anweat/idea-05b-smart-medicine-box/01_设计文档/07_取药几何优化.md

# IDEA-05B 取药几何优化（7 格演进版）

> 针对已确认的 **7 格演进方向**，专门解决「药片倒不出来 / 手指抠不到 / 手抖撒药 / 清洗难」。
> 结论：不做复杂机构，用 **一只可取出药杯** 同时支持「斜向指取」和「提杯倾倒」两种取法。
> 状态：待确认后进入 Blender 建模。

---

## 0. 结论先说

| 项 | 方案 |
|---|---|
| 格型 | 浅口 **15 mm**（现状约 25 mm），前部浅槽 **4.8°**、整底微倾 **3.4°**，内壁 R3、底壁 R2 |
| 取药口 | 前唇高 **5 mm**，中央 **24 mm** 宽倒药口，R2 圆唇 |
| 药杯 | **可取出**：41.9 × 54 × 15 mm，食品级 PP，带提手，可水洗、可预装、可带走 |
| 指取 | 指腹从上方 **35–45°** 斜插，落点距唇口仅 **5 mm**，不需要捏取、不需要下探到格底 |
| 倒取 | 提杯 → 倾斜 **40–50°** → 从 24 mm 倒药口倒入手心，适合手抖/关节炎 |
| 底座配合 | 杯底 **10 × 24 mm** 透光窗，与 LED 引导灯、红外对射对位 |
| 代价 | **+7 只 PP 杯**，BOM +¥2–3；模具多一套杯体（7 腔一模） |
| 不做 | 弹起平台、翻斗、电机转盘——机构复杂、密封差、成本高，首版不做 |

取药几何
取药方案对比

---

## 1. 为什么「抠药」是个几何问题

现状 7 格：单格约 44 × 55 × 25 mm，垂直壁、平底、无倒药口。

| 几何事实 | 老人实际动作 | 后果 |
|---|---|---|
| 格深 25 mm | 食指要整根下探到格底 | 指关节弯曲受限、指甲长的用户更困难 |
| 垂直壁 + 平底 | 药片贴在格底，只能「捏」或「抠」 | 捏力 3–5 kg 且关节炎再降 30–40%，失败率高 |
| 格口 44 × 55 | 手要伸进格子，视线被盖沿挡住 | 看不清、容易把药拨到别的格 |
| 平底无聚集 | 药片散在四周 | 要多次拨动，手抖会撒 |
| 一体内胆不可拆 | 只能擦，不能洗 | 药粉残留、串味、受潮 |

**核心判断**：老人不是「不愿意取」，而是**取药动作要求的手指能力超过了他们的手**。几何优化的目标不是把格子做大，而是**把「捏/抠」改成「斜插/倾倒」**。

---

## 2. 四种几何方案对比

| 方案 | 做法 | 步骤 | 耗时 | 指力/捏力 | 清洁 | 成本 | 密封风险 | 结论 |
|---|---|---|---|---|---|---|---|---|
| A 现状 | 深格 + 垂直壁 | 3 | 5–10 s | 高（下探+捏） | 差 | 0 | 低 | 不解决根本问题 |
| B 斜底 + 前唇（一体模） | 15 mm 浅格、3.4° + 前槽 4.8° 斜底、5 mm 前唇 | 3 | 3–5 s | 中低（斜插） | 差（不可拆） | 低 | 低 | 可作为**低配** |
| **C 可取出杯 + 倒药口（推荐）** | B + 独立 PP 杯 + 提手 + 24 mm 倒药口 | 3–5 | 3–6 s | **低**（斜插或倾倒） | **好（可水洗）** | +¥2–3 | 中（杯口密封） | **主推** |
| D 可翻出硅胶软胆 | 软硅胶内胆，按压翻出 | 2 | 2–4 s | **最低** | 中（易吸味） | +¥4–6 | 中 | 作为**配件**，重度关节炎选配 |

**推荐 B + C 组合**：同一个杯体，两种取法。
- 日常：开盖 → 斜插指取 → 合盖（3 步，3–5 s）。
- 手抖/关节炎：开盖 → 提杯 → 倾斜倒出 → 放回 → 合盖（3–5 步，但每步都简单）。
- D 软胆作为选配件，不进入首版模具。

---

## 3. 推荐几何（给建模的硬参数）

### 3.1 药杯

| 参数 | 数值 | 说明 |
|---|---|---|
| 外形 | **41.9 × 54 × 15 mm** | 与 7 格托盘 1:1；单杯有效容积约 20 ml |
| 壁厚 | 1.6 mm | 食品级 PP，注塑 |
| 内腔 | 38.7 × 50.8 mm，内深 10–11 mm | 内壁 R3 |
| 底形 | **3.4° 微倾 + 前 12 mm 浅槽 4.8°** | 前部内深 11 mm、后部内深 10 mm；胶囊平放不顶盖 |
| 前唇 | 高 **5 mm**（相对杯底最低点） | 静置挡药；倾倒时越过 |
| 倒药口 | 宽 **24 mm**、深 5 mm、R2 圆唇 | 20 mm 胶囊可整粒倒出 |
| 提手 | 前缘上方 20 × 8 mm，外伸 3 mm | 拇指+食指可勾；提杯力 <2 N |
| 透光窗 | 杯底 **10 × 24 mm**，厚 0.8 mm | 与 LED/红外对位；≥70 % @850 nm |
| 圆角 | 内壁 R3、底壁 R2、口沿 R1.5 | 无锐边、不夹药、不藏粉 |
| 间隙 | 杯与托盘单边 0.2 mm | 不夹手、可取出 |
| 防呆 | 2 条导向筋 + 前后不对称 | 反装插不进 |

### 3.2 取药动作与尺寸链

```
杯口 z=41.5
前唇 z=35.5  ← 距杯底 5 mm，距杯口 6 mm
前部浅槽 z=30.5  ← 距唇口 5 mm，距杯口 11 mm
后部杯底 z=31.5  ← 距杯口 10 mm（胶囊平放不顶盖）
```

- 指腹落点：距前唇仅 **5 mm**，食指以 35–45° 斜插即可触药；不需要整根手指下探。
- 视线：杯口完全敞开（日盖开 100°），无遮挡。
- 倒药：提杯后倾斜 40–50°，5 mm 唇口成为倒药堰，24 mm 口宽保证胶囊/大钙片通过。
- 单杯约 20 ml：一天 3–6 粒胶囊只占 10–20 %，空间不局促；药片不会「卡」在角落。

### 3.3 托盘与底座配合

- 托盘 7 腔，单腔 42.3 × 54.4 × 15.4 mm；杯口低于托盘口 0.4 mm，日盖压合时密封在**托盘口**（不是杯口），避免杯体公差影响密封。
- 杯底透光窗与底座 PCB 上的 LED/红外对射一一对位；杯取出后，底座仍可检测「杯缺失」。
- 称重：托盘整体坐在称重平台上；取杯/放杯的重量变化由固件识别为「杯取出/放回」，不误判为「已取药」。

---

## 4. 为什么不是其他几何

| 备选 | 为什么不选 |
|---|---|
| 加深/加大格 | 手指能力不变，只是让药更难够到 |
| 纯倒药口、不可拆杯 | 倒药口在托盘上要穿破前脸，密封与外观都麻烦 |
| 抽屉/翻斗 | 滑轨占空间、药片易卡、密封差、成本高 |
| 弹起平台 | 7 套弹簧+导向，公差累积、清洁死角、成本高 |
| 转盘自动出药 | 电机、卡药、清洁、体积、成本都上一个量级；首版不做 |
| 只做硅胶软胆 | 软胆吸味/难彻底干燥，且需要杯体支撑；作为配件更合适 |

---

## 5. 对建模的影响（直接进 Blender）

1. 7 只独立药杯，不是 7 个一体化格；杯体单独建模、阵列 7 个。
2. 杯体必须做出：3.4° + 前槽 4.8° 斜底、5 mm 前唇、24 mm 倒药口、20×8 提手、10×24 透光窗、R3/R2 圆角。
3. 托盘 7 腔带 0.4 mm 台阶与防呆筋；日盖密封面在托盘口。
4. 英雄图：打开「周三」日盖，杯内 5 粒胶囊，杯底 LED 微亮；同时展示提手与倒药口。
5. 爆炸图：日盖 → 药杯（7 只）→ 托盘 → 称重/传感器板 → 主板/电池 → 底壳。
6. 细节图：杯口 5 mm 唇口与 24 mm 倒药口的特写；指取姿态用透视/剖面辅助图说明。

---

## 6. 待验证（打样前）

1. **5 mm 唇口**：静置 7 天不洒；倾斜 40–50° 时胶囊/大钙片可靠倒出；不同形状药片（圆片、椭圆片、胶囊、软胶囊）各 10 次。
2. **斜底 3.4° + 前槽 4.8°**：是否需要微振动/更陡角度才能让药片聚集；若药片仍停在后面，改 10° 或加前部浅槽。
3. **指取**：15 名老人（含关节炎/低视力）开盖→取药→合盖的成功率、时间、是否需要双手。
4. **透光窗**：PP 透光率 @850 nm ≥70 %；药片颜色（深色/半透明）对红外判定的影响。
5. **杯口密封**：杯在托盘内、日盖压合后的 IP54 与 7 天湿度保持。
6. **清洗**：杯体可洗碗机（≤70 °C）；提手/倒药口无清洁死角。

---

## 7. 与整体设计的关系

- 本次只改「取药几何」，不改已确认的：**7 格、段码屏 + 3 键、暖白 + 烟灰盖、主机+药芯+爆炸图+渲染**。
- 称重、环境、语音、双端 App 的规格沿用前版方案（见 `IDEA-05_设计优化方案_v1.md` 的对应章节，按 7 格口径调整：7 个杯、7 个霍尔、7 组红外/灯）。
- 下一步：按本文件的杯体参数建模；如果确认采用「一体模（B）」或「加硅胶软胆（D）」，只改杯体与爆炸图，不影响主机。

---

> 依据：`notes/research_ergonomics.md`（捏力、开盖力、单格尺寸、步骤上限）、`notes/research_competitors.md`（格子太小/太深、倒不出来、开盖判定）、`notes/research_components.md`（PP/PC、硅胶、透光、IP54、BOM）。
