anweat/idea-05b-smart-medicine-box/01_设计文档/08_IDEA-05B_7格定稿.md

# IDEA-05B 智能药盒 · 7 格演进版 · 设计定稿

> 确认日期：2026-10-18
> 已确认：**7 格演进** · **段码屏 + 3 键** · **暖白 + 烟灰透明盖** · **主机 + 药芯 + 爆炸图 + 渲染** · **可取出药杯 + 前唇倒药口（B+C）**
> 交付：`model/IDEA-05_box.blend`、`model/IDEA-05_box.glb`、`model/IDEA-05_box_closed.glb`、`renders/`、`design/09_IDEA-05B_design_board.png`、本文件、`07_取药几何优化.md`

---

## 1. 一句话

保留 IDEA-04 的 320 × 70 × 52 mm 外形与 7 天分格，把「深格抠药」改成 **7 只可取出药杯（浅口 + 前唇倒药口 + 底部透光窗）**，并补齐 **只称药芯的称重台、SHT40 温湿度/光照、离线语音、段码屏 + 3 键、双端 App**。

## 2. 总体尺寸与分层

| 项 | 数值 |
|---|---|
| 外形 | 320 × 70 × 52 mm，圆角 R8，暖白 ABS + 烟灰 PC |
| 底壳 | 0–24 mm：电池、主控、传感器板、称重台、UI |
| 药芯托盘 | 24–42 mm：7 腔、2 mm 底、可整体抽出 |
| 日盖 | 42–52 mm：7 个独立烟灰 PC 盖，按压弹开 |
| 空机重量 | 目标 ≤ 380 g |
| 电池 | 3.7 V 3000 mAh（805060，约 60 g） |

## 3. 七格与药杯（最终几何）

- 7 个日格（周一…周日），每格一只 **可取出药杯**：
  - 外 **41.9 × 54 × 15 mm**，壁厚 1.6 mm，食品级 PP；
  - 内腔 **38.7 × 50.8 mm**，前部内深 11 mm、后部内深 10 mm；
  - 底形：整底微倾 3.4° + 前 12 mm 浅槽 4.8°；
  - **前唇高 5 mm**、中央 **24 mm 倒药口**（R2 圆唇），距杯口 6 mm；
  - 杯底 **10 × 24 mm 透光窗**（与 LED/红外对位）；
  - 内壁 R3、底壁 R2；杯与托盘单边 0.2 mm 间隙；2 条防呆筋；
  - 提杯：指腹勾住前唇/杯口，或双手捏杯口；可水洗、可预装、可带走。
- 托盘：310 × 62 × 18 mm，7 腔 42.3 × 54.4 mm；日盖密封在**托盘口**，避免杯体公差影响密封。
- 日盖：43.4 × 62 × 9.5 mm，烟灰 PC 空心壳，前缘提手 26 × 8 mm；push-push 弹开 + 阻尼下放 + 磁吸辅助合盖；7 个霍尔判盖。
- 取药动作：
  - 指取 3 步：开盖 → 斜插指取 → 合盖（3–5 s）；
  - 倒取 2 步：提杯 → 倾斜 40–50° 倒出（手抖/关节炎）。
- 详细几何与验证项见 `07_取药几何优化.md`。

## 4. 称重（只称药芯）

| 项 | 方案 |
|---|---|
| 传感器 | 1 只 500 g–1 kg 单点式，承托「托盘 + 7 杯」；HX711/CS1237，24 bit |
| 精度目标 | 0.2–0.5 g（500 g 量程），需温度补偿与空载去皮 |
| 每格有无 | 7 组红外对射（38 kHz 调制），杯底透光窗对位 |
| 开合 | 7 个霍尔 + 盖内磁铁 |
| 装药标定 | App 引导逐格装药，记录每格增重 Δm 作为基线；总重复核，错格/漏装提示 |
| 取药校验 | 开盖 + 减重 ≈ 基线 → 已取出；无减重 → 未取；未开盖 → 未动 |
| 状态口径 | **已确认 / 已取出未确认 / 未动** 三态；不显示「已服药」 |
| 能力边界 | 单片 0.1–0.5 g，不能逐粒计数；整剂校验可靠 |

## 5. 环境感应

- **SHT40**（±0.2 °C / ±1.8 %RH）置于药仓侧壁，ePTFE 透气膜后，远离电池/充电 IC ≥15 mm。
- **VEML7700** 光照：开盖见光累计；避光药提醒。
- **密封**：托盘口硅胶圈 + 日盖 TPU 密封唇，目标 **IP54**；7 盖累计公差是最大风险。
- **干燥剂**：可抽换硅胶盒，按湿度上升速率提醒更换；120–140 °C 可再生。
- **阈值动作**：>25 °C 预警、>30 °C 告警；>65 %RH 预警、>75 %RH 更换干燥剂；见光超阈提醒合盖/避光内胆。
- **避光边界**：透明/烟灰 PC 不满足「遮光」；可选乳白避光内胆；如做琥珀窗需实测 290–450 nm 透射。
- **负面清单**：胰岛素/GLP-1、生物制品、硝酸甘油、泡腾片、中药颗粒、栓剂、需冷藏滴眼液、麻精药、儿童药。

## 6. 语音与交互

- 离线优先：RTC + Flash，断网可定时、语音、记录 30 天。
- **MEMS 麦克风** + SU-03T 离线唤醒（按键/开盖/加速度计一级唤醒，语音模组负载开关供电 3–5 s）。
- **8 Ω 2 W 扬声器**：75 dB、500–1000 Hz、语速 100–150 字/分；家人录音「亲情语音」。
- **3 键**：⌀22 主键「已服药」、⌀12「稍后」、⌀12「呼叫」；0.8–2 N，行程 ≥1.5 mm，声/光/触反馈。
- **58 × 18 段码屏**：时间 + 下一剂 + 温湿度/电量；7 天进度灯；7 格内导光（当次应服格常亮）。
- 提醒升级：T0 声光 → +5 min 重复 → +15 min 家属 App → +30 min 可选电话；「稍后」10 min，次数同步家属端。

## 7. App 双端

| | 长者端 | 家属端 |
|---|---|---|
| 账号 | 无 | 有 |
| 入口 | 物理键 + 语音（可选大字 App） | App / 小程序 |
| 功能 | 确认、稍后、呼叫、问状态 | 排药、装药引导、依从性、环境、库存、远程提醒、亲情语音、多家属协同 |
| 连接 | 断网可用 | BLE 近场 + WiFi 云同步；4G 底座选配 |

## 8. BOM（1k 批量估算，不含模具/认证/组装）

| 物料 | 数量 | 小计 ¥ |
|---|---|---|
| ESP32-C3-MINI-1 | 1 | 12 |
| 称重传感器 500 g–1 kg + HX711 | 1+1 | 24 |
| 红外对射（每格一组） | 7 | 7 |
| 霍尔（每盖一个） | 7 | 13 |
| SHT40 + VEML7700 | 1+1 | 8 |
| SU-03T + 功放 + MEMS 麦克风 | 1 | 22 |
| 8 Ω 2 W 扬声器 + 音腔 | 1 | 5 |
| 段码屏 58 × 18 | 1 | 12 |
| 充电管理 + 电池 3000 mAh + Type-C + pogo | 1 | 33 |
| PCB + 阻容/ESD/辅料 | 1 | 18 |
| 药杯 7 只（PP）+ 托盘 + 日盖（PC） | 7+1+7 | 约 8–12 |
| 密封圈 + 干燥剂 + 铰链/弹开 + 磁铁 + 脚垫 | — | 约 12 |
| **合计** | | **≈ ¥160–180** |

建议零售 ¥299–399；家属云服务基础免费 + ¥9.9/月高级。

## 9. 已交付的模型/渲染

| 文件 | 内容 |
|---|---|
| `model/IDEA-05_box.blend` | 参数化 Blender 源文件（单位 m，1:1） |
| `model/IDEA-05_box.glb` | 2.2 MB，117 mesh / 25 material / 1 texture；含开盖状态 |
| `model/IDEA-05_box_closed.glb` | 同上，全部日盖关闭；适合 Web/AR 展示 |
| `design/09_IDEA-05B_design_board.png` | 2000 × 1250 设计图板（整体图 / 三视图 / 爆炸图 / 取药几何 / 参数） |
| `renders/hero.png` | 3/4 英雄图（周三开盖 + 药杯 + 引导光） |
| `renders/front.png` | 正视图（段码屏、三键、7 日标签） |
| `renders/top.png` | 俯视图（7 个烟灰日盖 + 周一…周日） |
| `renders/exploded.png` | 爆炸图（日盖 / 药杯 / 托盘 / 称重传感 / 主板电池 / 底壳） |
| `renders/cup_detail.png` | 药杯细节（前唇、倒药口、透光窗） |

GLB 校验：开盖版包围盒 **322 × 77.5 × 93 mm**，闭盖版 **322 × 73.2 × 57.7 mm**（含按键/脚垫凸起）；Z 轴向上。材质含 transmission，Web/AR 需支持 KHR_materials_transmission。

## 10. 与 IDEA-04 的差异

| 部位 | IDEA-04 | IDEA-05B |
|---|---|---|
| 格型 | 深格 25 mm | 浅口 15 mm + 可取出杯 |
| 取药 | 手指抠 | 斜插指取 / 提杯倾倒 |
| 称重 | 机身中部称重片 | 只承托药芯的称重台 + 7 格红外 + 7 霍尔 |
| 环境 | 无 | SHT40 + 光照 + IP54 + 干燥剂 |
| 语音 | 仅播报 | 麦克风 + 离线唤醒 + 亲情语音 |
| 交互 | 4 LED + 1 键 | 段码屏 + 3 键 + 7 天进度 + 7 格导光 |
| 摄像头 | 顶部扫码窗 | 取消（App 扫码） |
| 充电 | Type-C | Type-C + pogo 底座（选配） |

## 11. 待验证（打样前）

1. 5 mm 前唇：静置 7 天不洒；倾斜 40–50° 可倒出胶囊/大钙片。
2. 杯底透光窗 ≥70 % @850 nm；深色药片不影响红外判定。
3. 称重 0.2–0.5 g 重复性；开盖手压扰动；装药基线误差 <5 %。
4. IP54：7 个日盖 + 托盘口密封累计公差。
5. 15 人可用性（75+、关节炎、低视力）：开盖、指取、提杯倒、读标签、处理报警。
6. 合规：GB 4806、GB 31241、GB/T 9254.1、IP54、SRRC；**NMPA 分类界定**；宣传禁用「治疗/诊断」，称重只讲三态。
