anweat/idea-05b-smart-medicine-box/01_设计文档/11_特色点与创新点_讲述稿.md

# IDEA-05B 智能药盒 · 特色点与创新点（讲述稿）

> 用途：答辩 / 路演 / 评审 / 组会讲述。所有数字为设计目标或调研值，标注了“目标/估算”，不要当成实测结论。

---

## 0. 先记住三句话

1. **一句话定位**：不是把药盒做“智能”，而是把**取药**这件小事做简单——让老人不用抠、不用记、不用学 App。
2. **一句话差异**：同尺寸 7 天分格，**可取出药杯 + 前唇倒药口**，**只称药芯的称重三态**，**离线语音 + 双端**。
3. **一句话边界**：称重只证明“药离开了药仓”，不证明“吞下去了”；所以我们只说**已确认 / 已取出未确认 / 未动**三态。

---

## 1. 30 秒电梯稿

> 我们的智能药盒面向独居、行动不便、每天要吃药的长辈。调研发现，老人真正的痛点不是“缺一个 App”，而是**盖子难开、格子太深倒不出来、忘了吃没吃、受潮变质、不会用手机**。所以我们保留 7 天分格，把格子做成**可取出药杯**：浅口、前唇、24 mm 倒药口，手指斜插就能取，也可以提杯直接倒；底座只称药芯，配合 7 格红外和 7 个霍尔，做**装药逐格标定 + 取药差重校验**；再加上温湿度、光照、密封、离线语音和双端 App。白牌 30 元只分格，进口 200–800 元/月卖服务，我们做 **299–399 元买断**的智能硬件。

---

## 2. 2 分钟讲述稿（按“痛点 → 方案 → 差异 → 证据”）

**① 痛点（20 秒）**
> 我国社区老年多重用药者不依从率约 31.8%–48.8%，平均吃 6 种药；60 岁以上占非网民 46.8%。老人不是不想吃，是**开、倒、看、记**四个动作超出了手和眼睛的能力。

**② 方案（50 秒）**
> 我们做了四件事：
> 第一，**取药几何**。7 个日格，每格一只可取出药杯：15 mm 浅口、5 mm 前唇、24 mm 倒药口、杯底 10×24 透光窗。日常“开盖 → 斜插指取 → 合盖”3 步；手抖或关节炎时“提杯 → 倾斜倒出”2 步。
> 第二，**称重三态**。称重台只承托药芯，装药时逐格记录基线，取药前后做差重校验；配合 7 组红外和 7 个霍尔，输出“已确认 / 已取出未确认 / 未动”，不冒充“已服药”。
> 第三，**保存条件**。SHT40 温湿度 + 光照 + 硅胶密封 + 可换干燥剂，超温、超湿、见光都给具体动作，而不只是显示数字。
> 第四，**适老化交互**。段码屏 + 3 个物理键 + 7 格导光；离线语音 + 家人录音的“亲情语音”；长者端零账号，家属端管排药、依从性、环境、库存和远程提醒。

**③ 差异（30 秒）**
> 和 14 款竞品比，**“称重 + 温湿度/光照”这个组合没看到**；白牌只做“分格 + 闹铃”，进口卖的是月费服务。我们的差异是：同尺寸把“取”做好、把“有没有取”说清楚、把“保存条件”变成动作、把 App 从老人侧拿掉。

**④ 收尾（20 秒）**
> 目前完成 7 格方案的设计定稿、Blender 模型、爆炸图和概念图板；下一步是药杯打样、5 mm 唇口倾倒测试、称重台架和 15 人可用性测试。我们先把最难的“取”做对，再谈自动分药。

---

## 3. 6 个特色点（讲给别人听时，一条一句话 + 一个数字）

| # | 特色点 | 一句话讲法 | 支撑细节 / 数字 |
|---|---|---|---|
| 1 | **7 天独立分格 + 按压弹开** | 一天一格，7 个独立烟灰日盖，指腹一压就弹开 | 按压 <3 N；开 100°；阻尼下放防夹手；日盖可整排取下 |
| 2 | **可取出药杯 + 前唇倒药口** | 药杯能拿出来，浅口 + 前唇 + 24 mm 倒药口，斜插或倾倒都行 | 杯 41.9×54×15 mm；内深 10–11 mm；前唇 5 mm；指腹落点距唇口 5 mm；可水洗、可预装、可带走 |
| 3 | **只称药芯的称重三态** | 只称药芯，装药逐格标定，取药差重校验 | 500 g 单点 + HX711；目标 0.2–0.5 g；7 组红外 + 7 霍尔；三态输出 |
| 4 | **环境感应闭环** | 不只显示温湿度，而是告诉你“现在该做什么” | SHT40 ±0.2 °C / ±1.8 %RH；>25 °C 预警、>30 °C 告警；>65/75 %RH 提醒换干燥剂；目标 IP54 |
| 5 | **离线优先 + 亲情语音** | 断网也能提醒、能记录；家人录的声音比机器声更管用 | 本地 RTC + Flash，30 天事件；SU-03T 门控供电；8 Ω 2 W、75 dB、500–1000 Hz |
| 6 | **双端分工：长者零账号，家属管后台** | 老人不需要学 App；家属在手机上看排药、依从性、环境、库存 | 长者端 3 键 + 语音；家属端排药 / 依从性 / 环境 / 库存 / 远程提醒 / 亲情语音 |

**加分项**：段码屏 + 3 键 + 7 天进度 + 7 格导光；Type-C + 磁吸 pogo 底座（选配）；取消摄像头（隐私 + 成本）；BOM 约 ¥160–180，建议零售 ¥299–399。

---

## 4. 5 个创新点（重点：为什么算创新、为什么难被抄）

### 创新点 1：把“取药”当成几何问题，而不是 UI 问题
- **做法**：7 只可取出药杯，15 mm 浅口、5 mm 前唇、24 mm 倒药口、杯底透光窗；指取 3 步、倒取 2 步。
- **为什么算创新**：竞品大多在“提醒”和“分格数量”上卷，很少有人把**手指可达、倾倒角度、唇口高度、胶囊能否通过**做成可量化的几何指标。
- **证据**：人因数据——捏力老人约 3–5 kg、关节炎再降 30–40%；开盖/按键建议 ≤10–15 N；单次操作 ≤3 步。
- **一句话**：**把“抠药”改成“斜插 / 倾倒”，让手比 App 先解决问题。**

### 创新点 2：只称药芯，而不是称整机
- **做法**：称重台只承托“托盘 + 7 只药杯”，不承托电池、主板和外壳；装药时逐格记录增重基线，取药后做差重校验。
- **为什么算创新**：整机称重会被电池、外壳、手压和温漂吃掉精度；只称药芯把量程从“整机”降到“药芯”，分辨率更容易做；再用“逐格基线”把“总重”变成“哪一格少了多少”。
- **证据**：1 kg 单点工程精度约 0.5–1 g，500 g 量程可到 0.2–0.5 g；单片药 0.1–0.5 g，不能逐粒计数——所以我们只做**整剂校验**，不做“数粒”。
- **一句话**：**从“开盖推断”升级为“差重校验”，并且诚实地说三态。**

### 创新点 3：环境感应必须“给动作”，不是“给参数”
- **做法**：SHT40 放在药仓侧壁，远离电池/充电 IC；>25/30 °C、>65/75 %RH、见光超阈，分别给“移阴凉处 / 换干燥剂 / 合盖或换避光内胆”的动作；干燥剂按湿度上升速率提醒更换。
- **为什么算创新**：多数产品只显示温湿度，用户不知道 68 %RH 意味着什么；我们把“保存条件”翻译成“下一步做什么”。
- **边界**：透明/烟灰 PC 不满足“遮光”，避光药要选配乳白内胆；不宣称“药典遮光”。
- **一句话**：**把“保存条件”从参数装饰变成行动建议。**

### 创新点 4：适老化不是放大字体，而是把 App 从老人侧拿掉
- **做法**：设备端 3 个物理键 + 语音 + 段码屏 + 格内导光；断网可定时、可语音、可记录 30 天；长者端零账号；家属端才做排药、依从性、环境、库存和远程提醒。
- **为什么算创新**：60+ 占非网民 46.8%，让老人“先配网、再授权、再学 App”是把最难的一步留给最弱的人；我们把复杂度移到家属端。
- **一句话**：**老人端是“家电”，家属端才是“后台”。**

### 创新点 5：同尺寸 7 格的可换药芯 + 成本卡位
- **做法**：药芯（7 只杯 + 托盘 + 日盖）可整体抽出、可水洗、可预装；主机复用；BOM 约 ¥160–180，零售 ¥299–399。
- **为什么算创新**：白牌 ¥23–45 只做“分格 + 闹铃”，进口 ¥213–888/月是服务费；中间 ¥199–399 的“买断式智能硬件”是空档。可换药芯把“卫生 + 备药 + 耗材”做成产品结构。
- **一句话**：**用耗材化药芯解决卫生和备药，用主机复用把价格打下来。**

> 如果评委问“21 格是不是更创新”：我们做过同尺寸 7×3 = 21 格的概念（文档里有），但 21 格装药负担大、7 个日盖的密封累计公差更难；首版选 7 格是**风险控制**，不是没想到。多剂次可以后续用日内分隔内胆或 21 格 SKU 扩展。

---

## 5. 和竞品 / 白牌 / 进口的对比（讲这一张表就够）

| 维度 | 白牌 7 格（¥23–45） | 进口自动分药（¥213–888/月） | IDEA-05B（¥299–399 买断） |
|---|---|---|---|
| 分格 | 7 格 | 10–60 杯 / 28 格 | **7 天 × 7 只可取出杯** |
| 取药 | 手指抠 | 自动出药 / 托盘 | **斜插指取 3 步 / 提杯倾倒 2 步** |
| 是否吃了 | 无 | 开盖/出药推断 | **称重 + 红外 + 霍尔 → 三态** |
| 环境 | 无 | 基本无 | **温湿度 + 光照 + 密封 + 干燥剂** |
| 联网 | 无 | 月费服务 / 蜂窝 | **离线优先 + BLE/WiFi + 双端** |
| 老人操作 | 闹铃 | 需家属/药师装药 | **3 键 + 语音 + 格内导光** |
| 价格 | ¥23–45 | ¥213–888/月 | **¥299–399 买断** |

---

## 6. 现场演示动线（3 分钟）

1. **开盖**：按一下 周三 日盖 → 弹起 12° → 掀开 100°；说“按压 <3 N，阻尼下放，不夹手”。
2. **指取**：食指 35–45° 斜插，从 5 mm 前唇上方触到药片；说“指腹落点距唇口 5 mm，不用下探到格底”。
3. **倒取**：把药杯提出，倾斜 40–50°，从 24 mm 倒药口倒入手心；说“手抖/关节炎也能完成”。
4. **称重**：放回药杯 → 屏幕/语音提示“已取出，请确认”；说“只称药芯，不称整机；三态，不冒充已服药”。
5. **环境**：展示温湿度/光照卡片，说“超 30 °C 提醒移阴凉处；超 75 %RH 提醒换干燥剂”。
6. **双端**：长者端按“已服药” → 家属端收到记录；说“长者零账号，家属管后台；断网也能用”。

---

## 7. 可能被追问的 8 个问题（附答法）

| 问题 | 答法 |
|---|---|
| 称重能证明老人吃了吗？ | 不能。称重只证明“药离开药仓”，所以我们输出三态，不写“已服药”；结合按键/语音确认和家属端事件流。 |
| 单片 0.1 g 能称出来吗？ | 不能逐粒计数。目标 0.2–0.5 g，做整剂校验和装药基线；单片计数需要更高精度和更贵的结构，首版不做。 |
| 7 格够吗？一天 3 次怎么办？ | 7 格是“一天一格”；多剂次可由家属按顿分装，或后续加日内分隔内胆 / 21 格 SKU。首版选 7 格是降低装药负担和密封风险。 |
| 为什么不做自动分药？ | 电机、卡药、清洁、体积、成本都上一个量级；首版先把“取、称、存、提醒”做对。 |
| 7 个日盖能做到 IP54 吗？ | 日盖 TPU 密封唇 + 托盘口硅胶圈，目标 IP54；7 盖累计公差是最大风险，必须打样验证。 |
| 成本/售价怎么定？ | 1k 批量 BOM 约 ¥160–180；建议零售 ¥299–399，卡在白牌和进口月费之间。 |
| 法规上算医疗器械吗？ | 只做提醒/记录/依从性，通常按消费电子；不宣称治疗/诊断，不做按剂量分发；建议做 NMPA 分类界定。 |
| 老人不会用 App 怎么办？ | 老人端不需要 App/账号；设备本地 3 键 + 语音 + 屏幕；家属端才需要 App。 |

---

## 8. 一页 PPT / 展板提纲

1. **标题**：IDEA-05B · 把“取药”做简单
2. **痛点**：开、倒、看、记（4 个动作）+ 3 个数字（31.8–48.8% 不依从、6 种药、46.8% 非网民）
3. **方案总图**：概念图板（整体 + 三视图 + 爆炸 + 取药几何）
4. **特色 1**：可取出药杯 + 前唇倒药口（剖面图 + 3 步/2 步）
5. **特色 2**：只称药芯 + 三态（称重架构 + 状态卡）
6. **特色 3**：环境闭环（阈值 → 动作）
7. **特色 4**：离线语音 + 双端（长者端/家属端分工）
8. **对比**：白牌 / 进口 / 我们（价格 + 能力）
9. **验证计划**：药杯打样、5 mm 唇口、称重台架、15 人可用性、IP54
10. **收尾**：先把“取”做对，再谈自动分药

---

## 9. 金句（可直接用）

- 把吃药从**记忆题**，变成**动作题**。
- 不是提醒得更大声，而是让**手**更容易。
- 称重不证明“吃下去了”，只证明“药离开了药仓”——所以我们只说**三态**。
- 老人端是**家电**，家属端才是**后台**。
- 同尺寸、7 天、可水洗：先把最难的“**取**”做好。
- 白牌 30 元只分格，进口 300 元/月卖服务；我们做 **300 元买断**的智能硬件。

---

## 10. 诚实边界（别被问倒）

- 5 mm 前唇、IP54、称重 0.2–0.5 g、15 人可用性：**都还没实测**，是设计目标。
- 7 格是“一天一格”；一天 2–3 次的场景需要家属分装或后续内胆/SKU。
- 透明/烟灰 PC 不满足“遮光”；避光药需选配内胆，琥珀窗要实测 290–450 nm。
- 称重不能逐粒计数；不能证明吞服。
- 不做摄像头、不做自动分药、不做 4G 主机（4G 只做底座选配）。
- 宣传禁用“治疗/诊断/替代用药”；医疗器械分类需 NMPA 界定。
