anweat/idea-05b-smart-medicine-box/01_设计文档/IDEA-05_设计优化方案_v1.md

# IDEA-05 智能药盒 · 设计优化方案 v1（概念对比稿）

> **已确认方向（2026-10-18）**：采用 **7 格演进版**（不是本文件的 21 格方案），取药几何采用 **可取出药杯 + 前唇倒药口（B+C）**。7 格定稿见 `08_IDEA-05B_7格定稿.md`，取药几何见 `07_取药几何优化.md`。本文件保留 21 格概念作为备选与论证材料。

> 基于现有设计稿 **IDEA-04（320 × 70 × 52 mm，7 格单排）** 的优化提案。
> 目标：在**不改变外形语言与总体尺寸**的前提下，解决「槽位不够、存取费劲、称重说不清、保存条件不可见、提醒不闭环、双端不会用」六个问题。
> 状态：**待确认**。确认后进入 Blender 建模（主机 + 药芯 + 爆炸图 + 渲染 + GLB）。

---

## 0. 一页结论

| 维度 | 现状 IDEA-04 | 优化后 IDEA-05 | 收益 |
|---|---|---|---|
| 外形 | 320 × 70 × 52 mm | **不变**（仅细节重构） | 不推翻已有 ID |
| 槽位 | 7 格 × 1 剂/天 | **21 格 = 7 天 × 3 剂（早/中/晚）** | 同尺寸容量 ×3，覆盖 2–3 次/天的主流方案 |
| 药芯 | 固定内胆 | **可换药芯**（7×1 / 7×2 / 7×3 共用底座） | 可水洗、可预装备用、耗材化 |
| 开盖 | 单排大盖 + 把手 | **7 个独立日盖**，按压弹开 <3 N，阻尼下放 | 单手、无捏取、无夹手 |
| 格型 | 深格垂直壁 | **15 mm 浅口 + 前低后高斜面 + R3 圆角** | 好倒、好抠、不撒 |
| 称重 | 单片「称重片」，不可定位到格 | **只承托药芯的浮动称重 + 21 格红外 + 7 霍尔** | 装药逐格标定；取药差重校验；输出三态 |
| 环境 | 无传感器，仅文案 | **SHT40 + VEML7700 + IP54 密封 + 可换干燥剂** | 超温/超湿/见光 → 给出动作建议 |
| 语音 | 仅播报、无麦克风 | **离线唤醒 + 亲情语音 + 三级升级**（供电门控） | 断网可用；家属声音更有效 |
| 交互 | 4 颗 LED + 1 大键 | **段码屏 + 3 键 + 7 天进度 + 21 格引导灯** | 大字、少步骤、状态可见 |
| 双端 | 未定义 | **长者端零账号 / 家属端管理后台** | 老人不用学 App，家属能真正管起来 |
| 成本 | — | 1k 批量 BOM **≈ ¥160（¥150–190）** | 建议零售 ¥299–399，卡在 ¥199–399 空档 |

**一句话**：外壳不动，内部重构成「**7 天 × 3 剂的换芯药盒 + 只称药芯的称重台 + 会发光指路的药格 + 断网也能用的语音提醒**」。

顶视图
正视图
横剖
槽位对比

---

## 1. 现设计诊断（IDEA-04）

| # | 现状问题 | 用户后果 | 优化动作 |
|---|---|---|---|
| 1 | 7 格 = 7 剂，只覆盖「每天 1 次」 | 2–3 次/天的慢病患者不够用，只能每天补药 | 同尺寸改 7×3 = 21 格；保留 7×1 / 7×2 药芯变体 |
| 2 | 格深、壁垂直、底部平 | 手指抠不到、倒不净；关节炎用户尤其困难 | 浅口 15 mm、前低后高 6° 斜面、R3 圆角、前唇倒药 |
| 3 | 单排长盖，开盖要捏/抬 | 需要捏取与持续用力，失败率高 | 7 个独立日盖，按压弹开，<3 N；阻尼下放防夹手 |
| 4 | 「称重片」在机身中部，测的是整机 | 只能得总重，无法对应到格；开盖≠服药 | 称重台只承托药芯；21 格红外判有无；7 霍尔判盖；三源融合 |
| 5 | 无温湿度/光照/密封 | 「防潮防氧化」只是文案，无法验证 | SHT40 + 光照 + 硅胶密封 + 可换干燥剂；阈值→动作 |
| 6 | 只有语音播报，无麦克风 | 只能被动听，不能问「我今天吃了吗」 | MEMS 麦克风 + 离线唤醒（门控供电）+ 亲情语音 |
| 7 | 4 颗 LED 对应 7 格 | 状态对不上号，老人更困惑 | 21 格内引导灯 + 7 天进度灯 + 段码屏 |
| 8 | 前面板信息量低 | 老人不知道「下一剂几点、吃什么」 | 段码屏显示时间/下一剂/温湿度/电量 |
| 9 | 顶部扫码摄像头凸起 | 增加高度与成本，隐私顾虑，使用频次低 | **取消机身摄像头**，扫码放回手机 App |
| 10 | Type-C 侧插 | 老人插不准、方向错 | Type-C 保留 + **磁吸 pogo 底座**（放上即充，兼 10° 支架） |
| 11 | 内胆不可拆洗 | 药粉残留、串味、卫生差 | 药芯可整体抽出，食品级 PP，可水洗 |
| 12 | 透明 PC 盖 + 「防潮」文案 | 避光药（硝酸甘油等）实际不达标 | 透明盖为标准；另出**避光内胆/琥珀窗**，但**不宣称「满足药典遮光」** |
| 13 | 无儿童锁 | 彩色药片被幼儿误食 | 磁吸 + 隐藏滑扣的两动作结构（需 ISO 8317 双人群实测） |

---

## 2. 三个方向，为什么选 B

| 方向 | 内容 | 容量 | 存取 | 成本/风险 | 结论 |
|---|---|---|---|---|---|
| A 演进版 | 保留 7 格，只改格型、盖子、称重、环境、语音 | 7 剂/周 | 最好 | 低；但与现有 21 格白牌拉不开差距 | 可作为**低配 SKU** |
| **B 换芯 21 格（推荐）** | 同尺寸 7×3；药芯可换；共用底座 | **21 剂/周** | 好（7 个日盖 + 引导灯） | 中；核心风险是 7 盖密封与装药耗时 | **主推** |
| C 转盘自动分药 | 电机转盘 + 单出口，按点自动出药 | 14–28 剂 | 老人操作最少 | 高（电机、卡药、清洁、体积、成本） | 二代再评估 |

**选 B 的理由**

1. 竞品调研（14 款）里，**「称重 + 温湿度/光照」组合为 0**；21 格产品（SEC P56、金隆兴）只有「分格 + 闹铃」。B 是明确的差异化位置。
2. 中国 60+ 人群占非网民 **46.8%**（CNNIC），离线优先是硬需求；B 的本地提醒、本地记录、家属近场同步正好覆盖。
3. 换芯不是新概念（Memo Box 已验证「可换内芯」），但把「换芯 + 逐格称重标定 + 灯光引导装药」连起来，是本方案的独特点。
4. 同尺寸从 7 剂到 21 剂，是设计稿上最容易被看懂、也最容易被记住的升级点。

---

## 3. 推荐方案 B 详解

### 3.1 槽位系统：同尺寸 7 × 3 = 21 格

**总体**：320（长）× 70（宽）× 52（高）mm，圆角 R8，无锐边。

**分层**（从下到上）：

| 层 | 高度 | 内容 |
|---|---|---|
| 底座 | 0–24 mm | 电池、主控、传感器板、称重平台、按键/屏/扬声器 |
| 药芯托盘 | 24–42 mm | 3 mm 底 + 15 mm 格深；可整体抽出 |
| 透明日盖 | 42–52 mm | 7 个独立盖，10 mm 拱高，可整排取下 |

**槽位尺寸**

- 7 列 = 周一…周日；3 行 = 早/中/晚（**前→后 = 早→中→晚**，最近的一排是早上，最里面是晚上）。
- 单格净空 **41.9 × 16.8 × 15 mm ≈ 10.6 ml**，可放 6–10 粒常见胶囊/片剂。
- 格底 6° 前低后高；前唇 5 mm 挡药；四角 R3；格与格之间 1.5 mm 分隔筋。
- 7 × 3 = 21 格；每列上方一个日盖（43.4 × 62 mm），盖面印「周一…周日」。

**关于「7×3 还是 7×4」**（人因调研建议优先 7×4）：

- 7×3 覆盖「早/中/晚」，其中「晚」按睡前服处理；对 4 次/天（含睡前单独一剂）的用户不够。
- **7×4 需要把整机加宽到约 320 × 86 × 52 mm**，不能与 70 mm 底座共用。建议作为**第二 SKU**，不在首版。
- 首版保留 7×1 / 7×2 / 7×3 三种药芯（同一底座）；7×2 的单格深度可做到 27 mm，更适合超大药片/中药丸。

**为什么单格深度 16.8 mm 不是 20 mm**

- 人因建议单格 ≥20 × 20 × 15 mm；本方案在 70 mm 宽度内做 3 行，只能到 16.8 mm。
- 补偿：单格宽度 41.9 mm，手指可从侧向进入；前唇低、底部斜，实际取药动作是「拨/倒」而不是「捏」。
- **动作**：首版样机做 15 人形成性测试；若「抠取成功率」不达标，直接切 7×2 药芯（同底座）或 86 mm 宽的第二 SKU。

**编码方式（三重冗余）**

- 文字：盖面「周一…周日」≥ 5 mm 字高；格内前壁「早/中/晚」。
- 图形：太阳 / 时钟 / 月亮图标；行色带（暖黄 / 青 / 靛蓝）。
- 触觉：日盖把手左侧 1/2/3 个凸点；格区可加盲文「周一」。
- 灯光：**当次应服格常亮暖白**（格内导光），其余格不亮；不靠颜色区分对错。

### 3.2 存取几何：让「开—取—关」变成 3 步以内

| 动作 | 设计 | 指标 |
|---|---|---|
| 开日盖 | 按压前缘 → 弹起 12° → 可掀至 100° | 按压 <3 N；掀开 ≤10 N；无捏取、无夹点 |
| 取药 | 浅口 15 mm + 6° 斜面 + 前唇 5 mm | 单指可拨出；倒药不撒；不粘壁 |
| 关盖 | 磁吸辅助 + 阻尼下放 | 松手自动合到底；无「啪」声；防夹手 |
| 定位 | 日盖把手凸点 + 盖面文字 + 格内灯 | 不用记「第几格」 |
| 夜间 | 开盖即亮格内灯 + 2700 K 柔光 | 不刺眼、不吵醒家人 |
| 清洁 | 药芯 + 日盖整体抽出，可水洗 | 食品级 PP；无电子件；R2 以上圆角 |
| 防倾倒 | 底面积大、四角硅胶脚、重心低 | 15° 倾斜不翻倒；开盖不滑动 |
| 防儿童 | 磁吸 + 隐藏滑扣（两动作） | 需 ISO 8317 老人/儿童双人群实测 |

**一个关键的取巧**：日盖前缘把手**外伸 3 mm**，悬在底座前脸之外。老人不用把手指塞进缝里，用指腹一压即可弹开；这也让「盖缝」成为视觉特征。

### 3.3 称重系统：能说清「药离开药仓了没有」

**架构（三源融合）**

| 来源 | 器件 | 作用 |
|---|---|---|
| 总重 | 1 个单点式称重传感器（**只承托药芯**，量程 500 g–1 kg）+ HX711 | 装药基线、取药差重、余量趋势 |
| 每格有无 | 21 组红外**对射**（38 kHz 调制，ITR9608 类） | 哪一格还有药；装药引导 |
| 开合 | 7 个霍尔 + 盖内磁铁 | 哪一天、哪一刻开盖；与减重配对 |

> 为什么**不**做 21 格独立称重：调研测算显示 7 格独立称重 BOM +¥180–220，且温漂（0.05 %FS/10 K）与格间串扰会吃掉克级优势；21 格更不划算。首版用「整盘 + 每格有无」是正确取舍。

**装药流程（把称重变成确定性）**

1. 家属在 App 进入「装药模式」，设备逐格点亮。
2. 每装完一格，按一下主键 → 设备记录该格**增重 Δm**，作为该格基线。
3. 21 格装完，设备用总重复核；漏装/多装/错格立即语音提示。
4. App 生成「本周药单」，家属可回看每一格的基线。

**取药校验（三态，不说「已服药」）**

| 事件 | 判定 | 对外表述 |
|---|---|---|
| 开盖 + 减重 ≈ 该剂基线（±15% 或 ±0.5 g） | 已取出 | **已取出，请确认** |
| 开盖 + 无减重 | 开盖未取 | **未取药，请检查** |
| 未开盖 + 到点 | 未动 | **未服药，已通知家属** |
| 老人按键「我吃了」 | 人确认 | **已确认**（与称重独立） |

**精度边界（必须写进说明书）**

- 500 g 量程、HX711/CS1237，工程可重复精度目标 **0.2–0.5 g**（1 kg 量程为 0.5–1 g）。
- 单片药 0.1–0.5 g，**不能逐粒计数**；只能判断「整剂取了 / 没取 / 明显少取」。
- 温度补偿用 SHT40；开盖时手压会扰动，只在「盖合 + 稳定 2 s」后取值；每次装药自动去皮。
- 宣传口径：**「已取出 / 已确认 / 未动」三态**，禁止直接显示「已服药」。称重证明的是「药离开药仓」，不是「被吞下」。

**额外收益**：总重趋势 + 计划用量 → 提前 3–5 天提醒补药；对「一周装一次」的家庭非常实用。

### 3.4 环境感应：从「显示数字」到「给出动作」

| 参数 | 器件 | 位置 | 阈值 → 动作 |
|---|---|---|---|
| 温度 | SHT40（±0.2 °C） | 药仓侧壁，ePTFE 透气膜后，远离电池/充电 IC ≥15 mm | >25 °C 预警；>30 °C 告警「请移到阴凉处」；<5 °C 提醒回温 |
| 湿度 | SHT40（±1.8 %RH） | 同上 | >65 %RH 预警；>75 %RH 告警「更换干燥剂 / 检查盖缝」 |
| 光照 | VEML7700 | 药仓内侧，避开 LED 直射 | 开盖见光累计超阈 → 「避光药请尽快合盖 / 考虑避光内胆」 |
| 开合 | 7 霍尔 | 每个日盖 | 开盖事件、未关盖提醒（>2 min） |
| 姿态（选配） | 加速度计 | 主板 | 拿起/放下唤醒、跌落记录 |

**密封与干燥**

- 药芯与底座之间：食品级硅胶异形圈，压缩量 20–30 %，目标 **IP54**（防尘 + 防溅，不浸水）。
- 每个日盖：TPU 密封唇（双色注塑或嵌件），7 盖累计公差是最大风险，需做 IP54 验证。
- 干燥剂：底部可抽换硅胶盒（20 × 30 mm，无钴变色），App 按湿度上升速率提醒更换；硅胶 120–140 °C 烘 2–3 h 可再生。
- 隔热：电池与药仓之间加 2 mm EPP/泡棉隔层，避免充电发热影响温度读数与药品。

**避光边界（重要，不要过度承诺）**

- 透明 PC 盖满足「看得见药」，但**不满足「遮光」**；USP 对塑料容器的判据是 290–450 nm 任一波长透射 ≤10 %。
- 实测资料显示琥珀色半透明 PC 在 290–450 nm 透射 **1 %–37 %**，不稳定达标。
- 方案：标准透明盖 + **可拆避光内胆（乳白不透光 PP）**；如做琥珀窗，必须用分光光度计实测 290–450 nm 曲线，**不得只写「UV 阻隔」**。

**适用边界（说明书负面清单）**

- 只适用于 **10–30 °C 常温固体口服药**。
- 不适合：胰岛素/GLP-1、生物制品/疫苗、硝酸甘油（需原棕色瓶）、泡腾片、中药颗粒/散剂、栓剂、需冷藏滴眼液/益生菌、麻醉/精神药品、儿童药。
- 提前 7 天分装有稳定性风险：密封 + 干燥剂 + 避光 + 每周清洗，且不建议把药片从原包装取出超过 7 天。

### 3.5 声音与交互：断网也能用，声音是「家电」不是「App」

**离线优先**

- 本地 RTC + Flash：定时、语音、21 格灯、开合记录、30 天事件全部本地完成。
- 断网/没配网也能正常提醒；联网只做同步、远程、OTA。
- 长辈端**不需要账号**；家属端才有账号。

**语音方案（含功耗门控）**

| 模块 | 选型 | 说明 |
|---|---|---|
| 唤醒/命令词 | SU-03T（或 CI1302） | 离线唤醒「小药盒」+ 8–12 条命令 |
| 播报 | ESP32 I2S + 功放 + 8 Ω 2 W 扬声器 | 支持家属录音（App 录制 → 设备下载到 Flash） |
| 麦克风 | MEMS（I2S） | 拾音孔在前脸右侧 |
| 供电门控 | LDO + 负载开关 | SU-03T 待机可达 60 mA，**不能常开**：按键/开盖/加速度计先唤醒，再给语音模组上电 3–5 s |

**语音命令（示例）**：今天吃药了吗 / 下一顿几点 / 还有几格药 / 再提醒我 10 分钟 / 呼叫女儿 / 现在几度。

**提醒升级链（可配置）**

1. T0：格内灯常亮 + 段码屏 + 语音（75 dB，500–1000 Hz，语速 100–150 字/分）。
2. +5 min 未响应：重复语音 + 橙色状态灯。
3. +15 min：家属 App 推送；家属可远程「喊话」或代确认。
4. +30 min：可选电话/短信（云服务）。
5. 老人按「稍后」：10 min 后再提醒，次数同步家属端，避免被监控感。

**三个物理键（少而明确）**

| 键 | 尺寸 | 力度 | 功能 |
|---|---|---|---|
| 主键「已服药」 | ⌀22 mm | 0.8–2 N，行程 ≥1.5 mm | 短按确认；长按重播语音 |
| 副键「稍后」 | ⌀12 mm | 0.8–2 N | 10 min 后再提醒 |
| 副键「呼叫」 | ⌀12 mm | 0.8–2 N | 呼叫家属（App 推送/电话） |

所有按键：凸起、哑光、有「咔哒」+ LED + 短振动（至少两路反馈）；相邻键边距 ≥10 mm，加隔离筋。

**显示与灯光**

- 58 × 18 mm 段码屏：时间 + 下一剂（周三·早 3 粒）+ 温湿度/电量图标；字高 ≥10 mm，强光可读、暗处自动调光。
- 7 天进度灯：本周完成情况一眼可见。
- 21 格内导光：应服格常亮；装药模式逐格点亮；漏服格慢闪。
- 夜间模式：2700 K、低亮度，不直射眼。

### 3.6 App 双端：长者端是「家电」，家属端是「后台」

| | 长者端 | 家属端 |
|---|---|---|
| 账号 | **不需要** | 微信/手机号 |
| 主要入口 | 物理键 + 语音；可选「大字 App」 | App / 小程序 |
| 功能 | 确认、稍后、呼叫、问状态 | 排药计划、药品库、装药引导、依从性、环境、库存、远程提醒、亲情语音、多家属协同 |
| 复杂度 | 单次 ≤3 步 | 允许复杂，但默认向导化 |

**家属端关键页面**

1. 本周药单：7 × 3 网格，点格编辑；支持从处方/药盒扫码导入。
2. 装药模式：手机与设备同步逐格点亮，称重基线自动记录。
3. 依从性日历：已确认 / 已取出未确认 / 未动 / 漏服，四色 + 文字。
4. 环境曲线：温度、湿度、光照；异常给「现在做什么」。
5. 库存与补药：按总重趋势预测，提前 3–5 天提醒。
6. 亲情语音：家属录 30 s，设备播放；支持方言。
7. 异常分级：未开盖 > 开盖未减重 > 减重异常 > 设备离线。
8. 多家属：谁看过、谁确认，老人可查（隐私）。

**连接策略**：BLE 配网/近场同步 + WiFi 云同步；无路由器时，家属上门用 BLE 同步也能拿到记录。4G 只做底座选配，不放进主机（峰值电流 2 A 级）。

### 3.7 结构与材料

| 件 | 材料 | 工艺 | 备注 |
|---|---|---|---|
| 底壳/前脸 | 食品级 ABS（哑光） | 注塑，1.5° 拔模，壁厚 2.0 mm | 无锐边 R2+；前脸做 IMD/丝印 |
| 透明日盖 | PC（透明/烟灰） | 注塑，壁厚 1.8–2.0 mm | 可选避光内胆；UV 阻隔需实测 |
| 药芯托盘 | 食品级 PP（半透白） | 注塑 | 可水洗；格底 6° 斜面；格底开透光窗 |
| 密封 | 食品级硅胶 50–60 A | 异形圈 + TPU 唇边 | 压缩 20–30 %；可拆洗 |
| 脚垫 | TPE | 双色注塑/背胶 | 摩擦系数 ≥0.5 |
| 按键 | PC + 硅胶 | 双色 | 凸起、哑光 |
| 导光 | PMMA | 注塑 | 21 格 + 7 天 + 状态 |
| 磁铁 | N35 φ4×2 | — | 盖子磁吸 + 定位；远离扬声器与称重传感器 |

**结构要点**

- 三层架构：底壳（电池/主控）→ 传感器+称重板 → 药芯 → 日盖。
- 药芯 3 点 kinematic 定位 + 2 个防呆筋；称重平台只托药芯，四周留 0.5 mm 不接触。
- 日盖：独立销轴铰链（不锈钢 φ1.2）+ 扭转弹簧 + 硅胶阻尼；push-push 锁扣；7 组可整体取下。
- 磁吸 pogo：4 pin（V+/GND/D+/D-），磁极防反接，ESD/短路保护；底座 10° 倾角当支架。
- 主板天线区（右端）做 ABS 净空，远离电池与金属件。
- 可维修：底部 4 颗 M2.5 螺钉 + 卡扣；电池插拔式；干燥剂可换。

### 3.8 尺寸与重量预算

| 项 | 目标 |
|---|---|
| 外形 | 320 × 70 × 52 mm（不变） |
| 层高 | 24（底座）+ 18（药芯）+ 10（日盖） |
| 空机重量 | ≤ 380 g |
| 含一周药 | ≈ 430–460 g |
| 电池 | 3.7 V 3000 mAh（805060，约 60 g），Type-C 1 A + pogo 底座 |
| 续航 | 目标 45–60 天（每天 3 次提醒 + 2 次同步；语音模组门控） |

### 3.9 BOM 概算（1k 批量，不含模具/认证/组装）

| # | 物料 | 选型 | 数量 | 单价 ¥ | 小计 ¥ |
|---|---|---|---|---|---|
| 1 | 主控 | ESP32-C3-MINI-1 | 1 | 12.0 | 12.0 |
| 2 | 称重传感器 | 500 g–1 kg 单点式 | 1 | 22.0 | 22.0 |
| 3 | 称重 ADC | HX711 / CS1237 | 1 | 2.2 | 2.2 |
| 4 | 每格红外对射 | ITR9608 类 | 21 | 1.0 | 21.0 |
| 5 | 霍尔 | AH1815 | 7 | 1.8 | 12.6 |
| 6 | 温湿度 | SHT40 | 1 | 4.0 | 4.0 |
| 7 | 光照 | VEML7700 | 1 | 4.3 | 4.3 |
| 8 | 离线语音 | SU-03T | 1 | 8.0 | 8.0 |
| 9 | 功放 + 麦克风 | NS4168 + MEMS | 1 | 9.0 | 9.0 |
| 10 | 扬声器 | 8 Ω 2 W + 音腔 | 1 | 4.8 | 4.8 |
| 11 | 段码屏 | 定制 58 × 18 | 1 | 12.0 | 12.0 |
| 12 | 充电 | TP4056 + 保护 | 1 | 1.0 | 1.0 |
| 13 | 电池 | 3000 mAh 带保护 | 1 | 18.0 | 18.0 |
| 14 | Type-C + pogo | 16P + 4 pin 磁吸 | 1 | 7.0 | 7.0 |
| 15 | PCB | 4 层 60 × 90 | 1 | 10.0 | 10.0 |
| 16 | 密封/干燥剂 | 硅胶圈 + 硅胶盒 | 1 | 3.2 | 3.2 |
| 17 | 铰链/弹开/磁铁 | 7 组 + 8 磁铁 | 1 | 6.0 | 6.0 |
| 18 | 阻容/ESD/辅料 | — | 1 | 8.0 | 8.0 |
| | **合计** | | | | **≈ ¥165** |

- 区间 **¥150–190**（1k 批量）；不含外壳模具（¥3–8 万）、认证、包装、组装。
- 建议零售 **¥299–399**，家属云服务「基础免费 + ¥9.9/月高级」。
- 与「每格独立称重」版（BOM +¥180–220）对比：首版不做，二代评估。

### 3.10 合规与口径

| 事项 | 要求 | 状态 |
|---|---|---|
| 食品接触 | GB 4806.1 / 4806.7，供应商符合性声明 + 第三方报告 | 必做 |
| 锂电池 | GB 31241-2022，电芯 UN38.3 | 必做 |
| EMC | GB/T 9254.1-2021 Class B | 必做 |
| 防护 | GB/T 4208-2017，目标 IP54 | 打样验证 |
| 无线电 | WiFi/BLE 需 SRRC 型号核准 | 必做 |
| 医疗器械分类 | 「提醒/记录/依从性管理」通常按消费电子；若声称「按剂量分发/治疗/诊断/慢病干预」可能被界定 II 类 | **需 NMPA 分类界定**（建议正式申请） |
| 药品分装 | 消费电子不得替代药师分装 | 说明书声明 |
| 宣传 | 禁用「治疗/诊断/替代用药」；称重表述为三态 | 文案审核 |

### 3.11 风险与边界（先写清楚，再画图）

| 风险 | 影响 | 缓解 |
|---|---|---|
| 称重≠吞服 | 家属误以为「已服药」 | 三态 + 文案 + 人确认；不显示「已服药」 |
| 单片太轻（0.1–0.5 g） | 无法逐粒计数 | 只做整剂校验；说明书明示 |
| 7 盖密封累计公差 | IP54 不达标、受潮 | 每盖 TPU 唇边 + 整圈硅胶；打样做 IP54 + 湿度保持测试 |
| 21 格装药耗时 | 家属嫌麻烦，弃用 | 灯光引导 + 逐格称重 + 5 分钟目标；备用药芯预装 |
| 21 组红外对准 | 误判「有/无」 | 38 kHz 调制 + 同步解调；透光窗模具精度；产线校准 |
| SU-03T 功耗 | 待机被拖垮 | 负载开关 + 一级唤醒（按键/开盖/加速度计） |
| 琥珀 PC 遮光不达标 | 避光药失效风险 | 不做「遮光」宣称；避光内胆；实测 290–450 nm |
| 磁铁干扰 | 称重/扬声器异常 | 磁铁远离传感器与扬声器；做磁场分布验证 |
| 儿童锁 vs 老人友好 | 二者冲突 | 两动作磁吸+滑扣，ISO 8317 双人群实测；或只做「防误开」不做「儿童安全认证」 |
| 分装稳定性 | 7 天内受潮/避光不足 | 密封 + 干燥剂 + 避光内胆 + 说明书负面清单 |
| 法规 | 被认定为 II 类医疗器械 | 先做分类界定；宣传口径保守 |

### 3.12 验证计划（确认后随模型一起做）

1. **可用性**：≥15 人，覆盖 75+、手部关节炎、低视力、轻度认知障碍；任务：开盖、取药、读标签、处理报警；记录成功率、时间、开盖力。
2. **称重**：空载/满载/偏载/温漂/开盖扰动；目标 0.2–0.5 g 重复性；装药基线误差 <5 %。
3. **环境**：25/30/35 °C、45/65/75 %RH 下 7 天药片外观与重量变化；干燥剂寿命。
4. **结构**：IP54、1.2 m 跌落、15° 不翻倒、开合 5000 次、铰链寿命。
5. **续航**：正常使用 30 天电流积分；语音门控前后对比。
6. **EMC/SRRC**：预测试。
7. **小批试用**：10–20 户家庭 4 周，看依从性、装药耗时、家属使用频次。

### 3.13 与现设计的差异清单（给结构/建模用）

| 部位 | IDEA-04 | IDEA-05 |
|---|---|---|
| 槽位 | 7 格单排 | 21 格 7×3 |
| 盖 | 单排长盖 | 7 个独立日盖（按压弹开 + 阻尼） |
| 药芯 | 固定内胆 | 可抽出、可水洗、可换 7×1/7×2/7×3 |
| 称重 | 机身中部称重片 | 药芯下方浮动称重台 + 21 红外 + 7 霍尔 |
| 环境 | 无 | SHT40 + 光照 + 密封 + 干燥剂 |
| 麦克风 | 无 | 前脸 MEMS + 离线唤醒 |
| 屏 | 无 | 58 × 18 段码屏 |
| 键 | 1 大键 | 1 主键 + 2 副键 |
| 灯 | 4 颗 | 21 格导光 + 7 天进度 + 状态 |
| 摄像头 | 顶部扫码窗 | 取消（App 扫码） |
| 充电 | Type-C | Type-C + 磁吸 pogo 底座 |
| 底部 | 防滑脚 | 四角 TPE + 磁吸触点 + 称重限位 |
| 内部 | 电池 + 主板 + 语音 | 增加称重 ADC、传感器板、霍尔、21 组红外、干燥剂仓 |

### 3.14 下一步：Blender 建模交付物（确认后执行）

1. `IDEA-05_box.blend`：底座 + 药芯 + 7 日盖 + 21 格 + 前脸 UI + 接口；参数化，可改尺寸。
2. `IDEA-05_box.glb`：Web/AR 预览（PBR 材质）。
3. 渲染：
   - 英雄图（3/4 视角，一个日盖打开，应服格发光）；
   - 正视图 / 顶视图 / 侧视图；
   - 爆炸图（底座 / 称重板 / 药芯 / 日盖）；
   - 细节图（按压把手、按键、干燥剂仓、pogo 触点）；
   - 可选：夜间模式、装药模式。
4. 一张新的「设计图」板（把渲染 + 标注 + 参数组合，替代/升级现有 IDEA-04 图板）。

### 3.15 待确认（影响建模）

1. **槽位方案**：A 21 格换芯（推荐）/ B 7 格演进 / C 7×4 28 格（宽 82 mm）。
2. **显示与交互**：A 段码屏 + 3 键（推荐）/ B 电子墨水屏（需加高前面板）/ C 极简（只按钮 + 灯）。
3. **建模范围**：A 主机 + 药芯 + 爆炸 + 渲染（推荐）/ B 加磁吸充电底座 / C 先只做主机外壳。
4. **配色**：暖白 + 烟灰透明盖（推荐）/ 白 + 透明 / 深空灰 + 琥珀盖。

---

## 附录：调研依据

- 竞品与痛点：`notes/research_competitors.md`（14 款产品对比、12 条痛点、7 条空档、40 条来源）
- 元器件与 BOM：`notes/research_components.md`（称重精度、21 格红外、SHT40、SU-03T 功耗、BOM ¥120 基线、合规）
- 适老化人因与药品保存：`notes/research_ergonomics.md`（开盖力、按键、字号、听力、7×3/7×4、药典储存条件、负面清单）

> 本文中的价格为公开网页抓取的量级估算，不是询价单；结构尺寸为设计名义值，开模前需按供应商图纸与公差链复核。
