anweat/idea-05b-smart-medicine-box/06_调研笔记/research_ergonomics.md

# 面向中国老年人的智能药盒：适老化人因与药品保存条件依据

> 用途：为产品定义、结构/UI 设计、可用性测试与宣传口径提供可追溯依据；不构成用药建议。
> 证据等级：★★★ 药典/国标/规范原文级；★★ 同行评议论文或政府、三甲医院科普；★ 工程经验、小样本或专家判断，必须在本项目可用性测试中复核。
> 适用边界：本文的"常温药盒"指在 10–30 ℃ 室内环境使用的分装/提醒装置，不含冷藏、冷链运输与无菌调配场景。

## A. 适老化人因数据

### A1 手部力量、灵活度与开盖力

| 项目 | 数据/建议 | 设计含义 | 来源 |
|---|---|---|---|
| 握力 | 中国 60–69 岁约男 35–40 kg、女 22–26 kg；80 岁以上约男 22–26 kg、女 15–18 kg，女性约为男性 60%–65% ★★ | 整机重量、开盖力按女性第 5 百分位设计，不按"平均老人"；不要假设老人能握紧 | [7][14] |
| 捏力 | 钥匙捏（key pinch）老年约 5–9 kg，指尖捏约 3–5 kg；手部骨关节炎可再降 30%–50%，且疼痛限制持续用力 ★★ | 需捏取的动作应 ≤10 N（约 1 kg），避免"捏—拉""捏—撕"；泡罩板、小卡扣、薄膜开关对老人不友好 | [7][8] |
| 手指灵活度 | 精细操作随年龄下降；4–8 Hz 震颤使小于 10 mm 的目标命中率明显下降 ★ | 最小可操作目标 ≥20 mm；不用小滑块、微型拨轮、需要指甲抠的缝隙 | [9] |
| 开盖扭矩 | 普通螺旋盖约 0.6–1.5 N·m；儿童安全盖（CRC）常见 1.5–2.5 N·m；适老建议 ≤1.0 N·m，硬上限 1.5 N·m（40 mm 握持半径约合 25–37 N 切向力）★★ | 大盖径 + 滚花/软胶；避免"下压再旋转"复合动作——下压轴向力才是老人真正的障碍 | [6][21] |
| 开盖轴向力 | 拔盖/掀盖建议 ≤10–15 N；按压卡扣 ≤15 N ★ | 拇指可单动作完成；用弹盖、磁吸、杠杆助力，而不是更用力 | [9] |
| 按键力 | 舒适区 0.8–2.0 N，上限 2.5–3 N；关节炎/帕金森建议 ≤1.5 N ★ | 轻触即触发，但必须配防误触（见 A2），不能靠"按不动"防错 | ★ |
| 旋钮/拨杆 | 旋钮 ≤0.3–0.5 N·m，直径 ≥30 mm，档位 ≤5，每档 15–30°；拨杆长 ≥25 mm、力 ≤5 N ★ | 作为小按键的替代通道；档位要有清晰"咔哒"和指针，并设终点限位 | ★ |
| 提握 | 便携整机 ≤500 g（长时间单手持 ≤300 g）；提手内径 30–40 mm；握持保持力 ≤最大握力的 15%（约 5 kg）★ | 重心靠近握持面；桌面款 ≤1.5 kg，搬动时有双手位 | ★ |
| 单手操作 | 老年人单手操作成功率显著低于双手，但服药场景多为坐姿单手 ★★ | 取药、开盖、关盖三个关键动作均应单手可完成，另一手可扶握 | ★ |
| 关节炎影响 | 手部骨关节炎握力约降 20%–30%、捏力约降 30%–40%，类风湿更重 ★ | 表面不冰手、无锐边；力矩留 2 倍余量；冬季低温环境下塑料变硬、摩擦下降 | ★ |

### A2 按键与替代操作

| 项目 | 数据/建议 | 设计含义 | 来源 |
|---|---|---|---|
| 按键直径 | ≥15 mm 为最低，≥20 mm 推荐，≥25 mm 用于关节炎/震颤人群 ★ | 实体键应明显大于触屏目标；用指腹而非指尖操作 | [10][12] |
| 按键间距 | 相邻键边距 ≥10–12 mm，键间加隔离筋 ★ | 防"一按两键"；凸起隔离筋还能提供触觉定位 | ★ |
| 行程与反馈 | 行程 1.5–3 mm；按到底有"咔哒"声 + LED + 短振动或语音 ★ | 多模态确认，弥补听/视下降；不能只靠屏幕变化 | ★ |
| 按压力曲线 | 起始力低、末段略增，避免"无段落感"的薄膜键 ★ | 让老人明确知道"按到了"，减少重复按压 | ★ |
| 防误触 | 长按 1.5–2 s 或双击确认；物理翻盖；提供取消/撤销 ★ | 降低重复服药；但确认步骤不能超过 A5 的步骤上限 | ★ |
| 触感编码 | 不同形状/凸点：圆点=早、长条=中、三角=晚；可加盲文 ★ | 不依赖视力也能定位；形状差异应可单手摸辨 | ★ |
| 旋钮/拨杆替代 | 大旋钮、拨杆、翻盖+单一大键；避免小滑块和触摸薄膜 ★ | 转动比精确按压更省力；档位少、行程大、有终点限位 | ★ |
| 触屏（如采用） | 目标 ≥44×44 CSS px 且物理尺寸 ≥12 mm；支持指甲/手套；防掌误触 ★ | 老人皮肤干燥、指纹浅，电容屏识别率下降；触屏不应是唯一入口 | [10] |

### A3 视觉

| 项目 | 数据/建议 | 设计含义 | 来源 |
|---|---|---|---|
| 字号 | 正文 ≥18 pt（约 6.4 mm 字身，实际字面 5–5.5 mm）；关键信息 ≥24 pt（约 8.5 mm）；12 pt 仅限次要信息 ★★ | 药名、剂量、时间用最大字号；屏幕 UI 支持 200% 缩放 | [10] |
| 中文换算 | 1 pt = 0.3528 mm；建议实际字高 ≥5 mm，弱视/黄斑变性 ≥8 mm ★ | 印刷与屏幕统一用 mm/pt 标注，不用 px 描述字号 | ★ |
| 对比度 | 正文 ≥4.5:1，老年推荐 ≥7:1；大字 ≥3:1；图标/边框等非文本 ≥3:1 ★★★ | 深字浅底；避免灰底灰字、浅色 pastel、半透明叠色 | [10] |
| 色彩辨识 | 白内障晶状体黄化使蓝/紫/青辨识下降，短波散射加重眩光；黄斑变性造成中心暗点、对比敏感度下降 ★★ | 不用蓝紫传达关键状态；关键信息用高亮差（黑/白、红/橙）而非色相差异 | [17] |
| 红绿色觉 | 男性约 8% 红绿异常，老年后天色觉也下降 ★ | "已服/未服"不能只靠红/绿；加 ✓/✗、文字与亮度差 | ★ |
| 眩光 | 镜面/高光反射在白内障眼中散射明显；建议哑光表面（60° 光泽 ≤10 GU）★ | 避免高亮黑、镜面亚克力；屏幕亮度自动或三档可调，夜间不直射眼 | ★ |
| LED 指示 | 发光面 ≥3 mm；亮度可调；白天与环境对比 ≥3:1；颜色绿/琥珀/红并配图标或文字 ★ | 不要只用蓝色 LED；闪烁 1–3 Hz，避免 3–50 Hz 不适频段；夜间降低亮度 | ★ |
| 屏幕 | 室内亮度 ≥200 cd/m²、对比 ≥7:1；避免低频 PWM 调光 ★ | 减少闪烁感；阳光下可读性需实测 | ★ |

### A4 听觉

| 项目 | 数据/建议 | 设计含义 | 来源 |
|---|---|---|---|
| 高频损失 | 老年性耳聋先从 2 kHz 以上下降；65 岁以上约 1/3、75 岁以上约 1/2 有听力损失 ★★ | 提示音能量放在 2 kHz 以下，不要把"高频蜂鸣"当默认 | [16] |
| 提示音频率 | 基频 500–1000 Hz，带 1–2 次谐波；避免大于 3 kHz 的纯高频 ★ | 用"叮—咚"双音或低频调制音，而非尖锐蜂鸣 | ★ |
| 音量 | 60–75 dBA @1 m，高于环境 15–20 dB；可调三档 ★ | 夜间默认低档；最高不超过 75 dBA，避免惊扰与邻里问题 | ★ |
| 时长/节奏 | 单次 ≥500 ms；节奏 2–5 Hz；未响应每 10 min 重复 ★ | 与语音提示错开，避免声音重叠造成听不清 | ★ |
| 语音语速 | 老年友好 100–150 字/分钟（常规新闻播报约 240–300）；句间停 0.5–1 s ★ | 关键数字逐位读："两片，早饭后"；重要句可重复一次 | ★ |
| 语言 | 普通话为主，提供方言包（粤语/吴语/川渝等）或家属录音 ★ | 方言理解与信任度更高；语速、音量可独立调节 | ★ |
| 冗余 | 声 + 光 + 振动，至少两路；声音可关闭 ★ | 听障用户不依赖声音；光信号需在 1 m 外可见 | ★ |

### A5 认知与标签

| 项目 | 数据/建议 | 设计含义 | 来源 |
|---|---|---|---|
| 步骤数 | 单次任务 ≤3 步（理想 1–2 步），全流程 ≤5 步 ★ | "开盖→取一格→关盖"已是 3 步；不要"选日期→选时段→确认→再确认" | ★ |
| 工作记忆 | 老年工作记忆约 3–4 个 chunk；避免要求记住"第几格"★ | 用当前格高亮/弹起/语音点名，而不是记忆编码 | ★ |
| 编码方式 | 颜色（≤5 类）+ 图形（太阳/月亮/星星）+ 中文（早/中/晚/睡前）三重编码 ★ | 任一通道失效（色盲、白内障、不识字）仍可识别 | ★ |
| 7×3 网格 | 21 格；7 列接近快速扫视上限，3 行常缺"睡前"这一时段 ★ | 优先 7 列×4 行（早/中/晚/睡前）；若必须 3 行，需明确"晚"是否含睡前 | ★ |
| 单格尺寸 | ≥20×20×15 mm；开口 ≥15 mm；格内药片应可视 ★ | 7 列时盒宽约 ≥180 mm，与便携性冲突，需在结构上取舍 | ★ |
| 标签文字 | 药名（通用名+商品名）、剂量（片数+mg）、时间、餐前/餐后；≥18 pt ★ | 避免缩写与拉丁文；加药片外观图/颜色；"每次 1 片"比"qd"有效 | ★ |
| 提醒锚点 | 绑定"早饭/晚饭/睡前"等生活事件，而非抽象钟点 ★ | 减少看钟表与换算负担；固定位置放置 | ★ |
| 错误恢复 | 可撤销、可回看"今天已服"、家属远程确认 ★ | 防止重复服药；异常状态用文字说明原因，不只闪红灯 | ★ |

### A6 尺寸、可达与稳定

| 项目 | 数据/建议 | 设计含义 | 来源 |
|---|---|---|---|
| 手部可达 | 坐姿舒适操作区约肩前 300–400 mm、高 700–1200 mm；拇指可达半径 50–60 mm ★ | 桌面款放在餐桌/床头柜高度；不要设计成需要起身或转身取药 | ★ |
| 单手便携 | 宽度 ≤90 mm、厚 ≤40 mm；开盖用拇指推/拨 ★ | 可单手握持并完成操作；表面防滑 | ★ |
| 盒体尺寸 | 便携 ≤180×120×40 mm、≤500 g；桌面 ≤250×180×80 mm、≤1.5 kg ★ | 7 天×4 次=28 格，便携款需折叠/转盘/抽拉结构 | ★ |
| 防倾倒 | 15° 倾斜不翻倒；单手开盖不滑动；底部硅胶脚摩擦系数 ≥0.5 ★ | 重心低、底面积大；可加吸盘或防滑垫 | ★ |
| 防滑/防护 | 1.2 m 跌落不开裂；IPX4 防溅（GB/T 4208）★★ | 浴室/厨房场景；充电口加塞，外壳接缝做防水筋 | [18] |
| 放置环境 | 避窗台、灶台、浴室、冰箱顶；建议床头/餐桌固定位 ★ | 高温高湿是家庭药品失效主因（见 B3）；说明书写明"不要放哪里" | ★ |

### A7 相关标准与规范

| 标准 | 关键内容 | 对本项目的含义 | 来源 |
|---|---|---|---|
| GB/T 4208-2017 | 外壳防护等级（IP 代码）；家用建议 IPX4 | 只覆盖防尘防水，不覆盖可用性，不能拿来宣称"适老" | [18] |
| GB 50763-2012 | 无障碍设计规范；操作高度、通行与 reach 参考 | 公共/住宅设施标准，药盒可借用其尺寸逻辑 | [19] |
| GB 50340-2016 | 老年人居住建筑设计规范 | 床头柜/柜面高度与照度参考 | [19] |
| GB/T 10000-2023 | 中国成年人人体尺寸 | 手长、手宽、握距的本土数据优先于欧美数据 | [22] |
| WCAG 2.2 | 2.5.8 目标 ≥24×24 CSS px（AA）；2.5.5 ≥44×44（AAA）；1.4.3 对比 4.5:1/3:1；1.4.4 支持 200% 缩放 | 适用于 App/屏幕 UI；实体键按 20–25 mm 执行更严 | [10][11] |
| IEC 62366-1 | 医疗器械可用性工程：形成性评价 + 总结性评价 | 若按医疗器械/健康软件申报，按 NMPA 2024 年指导原则执行 | [13] |
| ISO 8317 / ISO 14375 | 儿童安全包装；老年友好测试组通常为 50–70 岁 | 兼顾"儿童打不开"与"老人打得开"，两者需同时测试 | [21] |
| ISO 14971 | 风险管理 | 误服、漏服、重复服药纳入危害分析 | ★ |
| GB 9706.1-2020 | 医用电气安全（若带电源/充电） | 充电、电池、漏电安全 | ★ |

> 常见误传："WCAG 要求点击目标 ≥44 px"。准确说法：WCAG 2.2 AA 的最低要求是 24×24 CSS px（2.5.8），44×44 属 AAA（2.5.5）；Apple HIG 的 44 pt、Material 的 48 dp 是平台规范，不是 WCAG AA。对老年实体按键，建议直接做到 20–25 mm。

## B. 药品保存条件

### B1 《中国药典》储存术语与家庭含义

| 术语 | 定义 | 家庭/药盒含义 | 来源 |
|---|---|---|---|
| 常温 | 10–30 ℃ | 夏季窗台、厨房灶旁可超 35 ℃；必须做温度监测与报警 | [1] |
| 阴凉处 | 不超过 20 ℃ | 多数家庭夏季难满足；需空调房或阴面柜 | [1] |
| 凉暗处 | 避光且不超过 20 ℃ | "避光 + 阴凉"叠加，要求最高 | [1] |
| 冷处 | 2–10 ℃ | 冰箱冷藏室，不贴内壁、不靠冷冻室 | [1] |
| 遮光 | 用不透光容器包装，如棕色容器或黑纸包裹 | 透明分格盒不满足；需不透光格体或铝箔袋 | [1] |
| 避光 | 避免日光直射 | 不等于"不透光"，但窗边仍不合格 | [1] |
| 密闭 | 防止尘土及异物进入 | 普通旋盖即可 | [1] |
| 密封 | 防止风化、吸潮、挥发或异物进入 | 需密封圈 + 干燥剂，普通分格盖不够 | [1] |
| 熔封/严封 | 防止空气与水分侵入并防污染 | 安瓿/西林瓶级别，不适用于分装 | [1] |
| 相对湿度 | 药典未统一规定家用值；GSP 要求储存环境 35%–75%；家用建议 45%–65% ★★ | >75% 易霉变/吸潮；<30% 胶囊脆裂、片剂易碎 | [2] |
| 温湿度记录 | 传感器 ±1 ℃、±5%RH；至少 2 次/日或连续记录 ★ | 用于发现车内、窗台、冰箱异常，不作为稳定性数据 | ★ |

### B2 常见家庭药品的敏感类型

| 类型 | 代表药品 | 储存要求 | 能否放常温分装药盒 |
|---|---|---|---|
| 需避光 | 硝酸甘油、维生素 C/B2、硝苯地平、左氧氟沙星、部分头孢与注射剂 | 遮光/避光、密封，硝酸甘油需原棕色瓶 | 硝酸甘油：不建议；其余需不透光格 |
| 需防潮 | 泡腾片、胶囊、中药颗粒/散剂、阿司匹林、酵母片 | 密封、干燥处 | 泡腾片、颗粒剂：不建议 |
| 需冷藏 | 胰岛素、司美格鲁肽等 GLP-1、部分生物制品/疫苗、部分滴眼液、益生菌 | 未开封 2–8 ℃，禁冷冻 | 不建议（见负面清单） |
| 易挥发/串味 | 樟脑、薄荷脑、风油精、碘酒、芳香类中药饮片 | 单独密闭，远离其他药品 | 不建议同盒混放 |
| 需儿童安全包装 | 铁剂、部分降压药、阿片类等处方药 | 儿童安全盖 | 必须带儿童锁 |
| 麻醉/精神药品 | 吗啡、安定类等 | 专柜、双锁、专册登记 | 不建议家用普通药盒 |

**"不适合放这种常温药盒"清单（说明书/宣教应逐条列出）**

1. 胰岛素及 GLP-1：未开封必须 2–8 ℃；已开封虽可室温，但要求 ≤25–30 ℃ 且 28 天内用完，药盒无法保证。
2. 生物制品、疫苗、部分单抗：全程冷链，超温即报废，不可自行判断。
3. 硝酸甘油：需原棕色瓶遮光密封；频繁开合与受热会加速失效，舌下无烧灼感常提示失效。[3]
4. 泡腾片：吸潮后失效、产气，开封后要求密封干燥。
5. 中药颗粒/散剂、胶囊：高湿下粘连、结块、霉变。
6. 栓剂：超过 30 ℃ 软化变形，需冷藏或阴凉处。
7. 需冷藏的滴眼液、益生菌。
8. 麻醉药品、精神药品：需专柜双锁，不得放入日常药盒。
9. 儿童药：必须保留儿童安全包装，不能转入无锁分格。
10. 开封后的滴眼液：一般 4 周内用完，且易污染，不适合长期分装。

### B3 温湿度超限与受潮的处置

| 情形 | 处置建议 | 设计含义 | 来源 |
|---|---|---|---|
| 短期超温（固体口服制剂） | 未直射、未超 40 ℃、小时级暴露：多数固体制剂可继续使用，观察外观；超 40 ℃、暴晒或时间长：咨询药师 ★ | 药盒记录超温时长与峰值，提示风险并建议咨询药师，而不是只报警 | [5] |
| 胰岛素 | 冻结或 >30 ℃：弃用；未开封误置室温：按厂家 28 天规则或弃用 ★★ | 药盒不应设计为"可放胰岛素"，说明书明确排除 | [4] |
| 生物制品 | 不自行判断，联系厂家/药师，按稳定性数据评估 ★★ | 不在普通药盒场景内 | [2] |
| 栓剂软化 | 冷藏 30 min 定型；变形、分层、变色则弃用 ★ | 提示"不要放车内/窗台" | ★ |
| 冷藏药回温 | 室温放置 10–30 min，擦干冷凝水，不加热、不热水浸泡 ★★ | 取药提醒可包含"提前取出"步骤 | [4] |
| 吸潮后 | 不可晒、不可烘、不可继续服用；片剂变色/斑点/霉/松散、胶囊粘连、泡腾片吸潮均弃用 ★★ | 格内放指示卡；App 记录"已丢弃"而非"已服用" | [5] |
| 变色硅胶 | 蓝→粉红表示吸湿；橙色无钴硅胶→墨绿；再生 120–140 ℃ 烘 2–3 h，冷却后密封保存 ★ | 优先无钴变色硅胶；干燥剂仓可更换并提醒 | ★ |
| 温湿度记录的意义 | 发现异常环境、支持就医/药师沟通、强化服药仪式感；对临床结局的改善证据有限 ★★ | 记录应默认本地存储、可导出，避免隐私风险 | ★ |

### B4 提前分装的风险与缓解

| 风险 | 机制 | 设计缓解 |
|---|---|---|
| 稳定性下降 | 脱离原包装后失去避光、密封、干燥屏障；光/氧/湿加速降解 | 不透光格体 + 每格密封圈 + 干燥剂仓；分装周期 ≤7 天 |
| 避光失效 | 透明塑料格无法满足"遮光" | 棕色/不透光材料；或整盒放入避光袋 |
| 受潮 | 反复开盖引入湿气；吸湿性药物在单剂量包装中仍可吸湿（2025 年研究 [15]）★★ | 独立密封格、湿度传感、干燥剂更换提醒 |
| 混淆 | 外观相似的药片混放、多药同格 | 一格一次剂量；标签含药名、剂量、外观图；禁止混装 |
| 有效期识别 | 脱离原包装后批号/效期丢失 | 打印"药名/剂量/分装日期/失效日期"；扫码关联原包装 |
| 儿童误服 | 彩色药片像糖果，分格盒无锁 | 双动作儿童锁；高置；说明书警示 |
| 微生物污染 | 手接触、非无菌分装、清洗不彻底 | 可拆洗内胆；每周清洗并彻底干燥；不徒手抓药 |
| 依从性反效果 | 分装麻烦、格位难认 | 药房 unit-dose 分装；家属协助；大格、少格、清晰标签 |

## C. 设计硬指标卡（建议直接进 PRD）

- 开盖扭矩 ≤1.0 N·m（硬上限 1.5），盖径 ≥35 mm，单手拇指可完成，不做"下压+旋转"。
- 按键直径 ≥20 mm（关节炎款 ≥25 mm），按压力 0.8–2.0 N，行程 ≥1.5 mm，声/光/触至少两路反馈。
- 正文 ≥18 pt、关键信息 ≥24 pt；对比度 ≥7:1；哑光表面；状态不只靠颜色。
- 提示音基频 500–1000 Hz、60–75 dBA；语音 100–150 字/分；普通话 + 可选方言；声光振动冗余。
- 单次操作 ≤3 步；默认 7 列×4 行；单格 ≥20×20×15 mm；标签四要素齐全。
- 便携 ≤500 g、≤180×120×40 mm；15° 不翻倒；IPX4；1.2 m 跌落不开裂。
- 分装周期 ≤7 天；不透光 + 每格密封 + 干燥剂；儿童锁；保留原包装与说明书。
- 10–30 ℃ 监测，>30 ℃ 或 >75%RH 报警（>65%RH 先预警）；明确"不要放窗台/厨房/浴室/车内"。
- 说明书与包装必须列"不适合放入本药盒"的负面清单（胰岛素、硝酸甘油、泡腾片、生物制品等）。
- 可用性测试 ≥15 人，覆盖 75 岁以上、手部关节炎、轻度认知障碍与低视力用户；任务含开盖、取药、读标签、处理报警。

## D. 不确定项与待验证

- 握力/捏力为中国人群近似范围，来自公开体质标准与文献综合，建议用本项目样本复核第 5 百分位。
- 开盖扭矩阈值来自小样本与包装研究，需在本项目做扭矩计实测 + 老人开盖成功率测试。
- 7×3 与 7×4 网格的可读性缺直接对照实验，结论属设计判断，需形成性测试。
- 家用相对湿度无药典统一值，45%–65% 为工程建议；35%–75% 来自 GSP，不直接等同于家庭场景。
- 硝酸甘油开封后效期各厂家不同（常见 3–6 个月），以说明书为准。
- 语音语速、方言偏好的老年样本证据有限，建议做 5–8 人快速访谈。
- 温湿度记录对临床结局的改善证据有限，更多价值在异常发现与沟通。

## 来源

1. 《中国药典》2020 年版 凡例（贮藏术语）：https://www.chp.org.cn/three/anon/user/download?id=48475cf592184cd684169dce92627bb9
2. NMPA《药品经营质量管理规范》（GSP，英文版）：https://english.nmpa.gov.cn/2022-06/30/c_785622_4.htm
3. 上海市卫健委《硝酸甘油的保存和使用》：https://wsjkw.sh.gov.cn/jtyx/20210722/bef3b3e2784747829f91dbc318eba6d3.html
4. 上海市卫健委《胰岛素如何储藏才正确？》：https://wsjkw.sh.gov.cn/jtyx/20200827/611238caacac40ac94b7c7a09d54b3c9.html
5. 北京大学医院《家庭如何正确存放药品》：https://www.pkuh6.cn/Html/News/Articles/5182.html
6. Quantifying Removal Torque for Child-Resistant and Senior-Friendly Packaging（Packaging Technology and Science）：https://onlinelibrary.wiley.com/doi/10.1002/pts.2859
7. Prediction of grip and key pinch strength in 978 healthy subjects（BMC Musculoskeletal Disorders）：https://link.springer.com/article/10.1186/1471-2474-11-94/tables/1
8. Hand strength and plastic bottle opening（J-Stage）：https://www.jstage.jst.go.jp/article/circrep/advpub/0/advpub_CR-25-0090/_pdf/-char/ja
9. Requirements for packaging from an ageing consumer's perspective（Age and Ageing）：https://academic.oup.com/ageing/article-pdf/49/2/233/32677877/afz148.pdf
10. W3C《Web Content Accessibility Guidelines (WCAG) 2.2》：https://www.w3.org/TR/WCAG22/
11. ETSI EN 301 549（含 WCAG 2.1 引用）：https://www.etsi.org/deliver/etsi_en/301500_301599/301549/04.01.00_30/en_301549v040100va.pdf
12. Smashing Magazine：Minimum WCAG-Conformant Interactive Element Size：https://www.smashingmagazine.com/2024/07/getting-bottom-minimum-wcag-conformant-interactive-element-size/
13. NMPA 器审中心《医疗器械可用性工程注册审查指导原则》（2024 年第 13 号）：https://www.cmde.org.cn/xwdt/zxyw/20240319144656177.html
14. 《国民体质测定标准》握力指标（地方体育局公开 PDF）：http://sport.yq.gov.cn/tzgg/202407/P020240721632366321474.pdf
15. Stability assessment of hygroscopic medications in one-dose packaging（Scientific Reports, 2025）：https://www.nature.com/articles/s41598-025-89835-y
16. WHO Deafness and hearing loss fact sheet：https://www.who.int/news-room/fact-sheets/detail/deafness-and-hearing-loss
17. WHO Blindness and visual impairment fact sheet：https://www.who.int/news-room/fact-sheets/detail/blindness-and-visual-impairment
18. GB/T 4208-2017《外壳防护等级（IP 代码）》（标准检索入口）：https://openstd.samr.gov.cn/
19. GB 50763-2012《无障碍设计规范》、GB 50340-2016《老年人居住建筑设计规范》（标准检索入口）：https://www.mohurd.gov.cn/
20. 《中国药典》2020 年版（官网入口）：https://www.chp.org.cn/
21. 東京都「海外の医薬品等の安全容器に係る規制」（含 ISO 8317 老年测试组说明）：https://www.shouhiseikatu.metro.tokyo.lg.jp/anzen/kyougikai/h22/documents/1_sankou4.pdf
22. GB/T 10000-2023《中国成年人人体尺寸》：https://openstd.samr.gov.cn/bzgk/std/newGbInfo?hcno=B19DCCA575D9406856ABF87A511EE11F

> 检索说明：以上链接为公开检索所得；本机网络限制导致部分原文未能逐字打开，凡与原文不一致处，以标准/药典/说明书原文为准。
