anweat/idea-05b-smart-medicine-box/v3/01_设计文档/31_创新点详述_v3.md

# IDEA-05B 智能药盒 v3 · 创新点详述

> 日期：2026-10-26 · 对应模型 `model/v3/IDEA-05_box_v3.blend`（整机）、`model/v3/取药结构_v3.blend`（取药结构）
> 写法：每条都按「问题 → 借鉴的成熟做法 → 我们怎么落 → 参数 → 证据 → 边界」。证据只写模型校验和仿真算出来的；没实测的标"目标"。
> 与 `11_特色点与创新点_讲述稿.md` 的关系：v3 **兑现并修正**了其中两条——"提杯倾斜 40–50° 倒出"（原杯仿真要 85–100°）、"只称药芯"（原模型托盘直接坐在底壳上）。讲述时以本文为准。

---

## 0. 一句话

**外观一点没变，里面把"取、称、感、存、装"五条链路全部换成了经过别的行业验证过的结构**——药杯借量杯、数药盘、硬币杯和 SIM 卡；称重借厨房秤和精密仪器的三点定位；开盖检测借笔记本电脑。每一条都在 3D 模型里装配、校验、仿真过。

| 链路 | 原设计的问题（实测） | v3 的做法 | 关键证据 |
|---|---|---|---|
| 取 | 斜底 3.4° 小于摩擦角；倒药要 85–100° | 后勾手 + 收拢倒嘴 + R12 弧底 | 仿真 40–58° 全部倒出 |
| 称 | 托盘直接坐在底壳上，称重片悬空 4 mm | 浮动架 + 单点称重 + 三点运动学定位 | 托盘只碰浮动架，其余件间隙 ≥0.6 |
| 感 | 7 组红外之间无隔光；霍尔在可拆件上 | 杯坐底 + 通光孔 + 隔光墙；霍尔进铰链脊 | 药芯不带任何电子件 |
| 存 | 干燥剂在底座，不在密封腔里 | 每盖 1 片干燥片 + 一件多腔密封垫 | 干燥片在日盖内腔，与勾手间距 ≥4 |

---

## 一、取药：把"抠"改成"推"和"倒"

### 创新点 1｜量杯式"后勾前嘴"：手和药分在杯子两端

- **问题**：原方案要么捏杯壁（老人捏力 3–5 kg，关节炎再降 30–40%），要么在托盘前壁挖指扣槽（前壁只有 3.8 mm，挖 6 mm 会挖穿密封面）。
- **借鉴**：量杯、水壶、簸箕——**把手在后，倒嘴在前**。倒的时候手在药的反方向，不挡视线、不沾药。
- **落法**：杯后壁一体伸出 T 形勾手（20 宽、高出杯口 6.5、翼板前伸 5），藏在日盖 8 mm 净高里；前壁开 24 mm 倒嘴。食指从上往下一勾就起，不需要捏。
- **证据**：勾手顶离日盖内顶 2.5 mm；日盖开合 0–105° 扫掠与杯零干涉；PP 杯约 11 g，提杯几乎不需要力。
- **边界**：勾手手感、杯在手里倾倒时会不会转，要手板验证。

### 创新点 2｜药房数药盘式收拢导流：药排队出口，不从杯角翻出

- **问题**：原杯倒嘴 24 宽，但杯内满宽 38.7 直壁；倾倒时药堆在前壁两角，有的从倒嘴外的杯沿翻出去。
- **借鉴**：药房数药盘的导流槽——药片被刮进一条收拢的槽，从一个口倒进药瓶。
- **落法**：杯前 18 mm 的两侧壁向倒嘴收拢，单侧 22°；倒嘴先 24 宽直通前壁再张开（避免斜壁和前壁夹出薄边）。
- **证据**（刚体仿真，6 粒）：v3 所有药都从倒嘴中线 ±7.7 mm 内出来；原杯最大偏 15.2 mm（从杯沿翻出）。
- **边界**：仿真是刚体，没算药粉、受潮粘连。

### 创新点 3｜收银机硬币杯式弧底：药自己不会滑，那就让手指"推到边再捏"

- **问题**：原文档用 3.4° 斜底 + 4.8° 前槽让药"聚到前面"。但药片在 PP 上的静摩擦角约 17–24°，**3.4° 根本推不动**——仿真里药片要倾到 12–19° 才开始动。斜底只在图纸上起作用。
- **借鉴**：收银机钱箱的硬币杯——前端是一段大圆弧，手指把硬币往前一推，硬币沿弧面上到杯沿，**停在边上**，再捏就容易了（和"把硬币推到桌边再拿"是一个道理）。
- **落法**：聚药沟（离杯口 12）→ R12 弧面 → 5.2 宽唇台（离最低点 5）。不提杯时，食指从后往前一抹，药停在唇台边。
- **同一几何解决倒药**：原杯唇口内侧是直壁，倾倒时药要沿前壁"爬"5 mm；弧面把这段"爬坡"变成斜面，倾过 ~55° 后整段弧面都朝外。
- **证据**（刚体仿真，μ=0.4，35°/s 前倾）：

  | | 原设计杯 | v3 杯 |
  |---|---|---|
  | 第一粒倒出 | 85° | **40°** |
  | 全部倒出 | 100° | **58°** |
  | 70° 时杯内残留 | 6 / 6 | **0 / 6** |

- **边界**：硬币是平的，药有厚度和圆角；R10 / R12 / R15 要打手板对比（改 `params.COVE_R` 一个数即可重建）。

### 创新点 4｜SIM 卡切角防呆 + 卡匣导入：放回去不用看

- **问题**：杯底透光窗必须正对红外；杯子方向放反，传感器就读错。老人放杯不会去对方向。
- **借鉴**：SIM 卡切掉一个角，插反插不进；卡匣插座口做导入倒角，插的时候自己对正。
- **落法**：杯后左角切 5，托盘杯位对应角放 4.6 填块；杯位口做 0.4 × 1.5 的导入（四周一致）。
- **证据**：杯转 180° 放入时与填块干涉 86 mm³（= 放不下去）；7 杯正常放入干涉 0。
- **边界**：导入倒角受格板（2.23 mm）和托盘后壁（1.6 mm）厚度限制，只给得出 0.4；后壁口沿实际留 1.2 mm。

---

## 二、称重：让"只称药芯"真正成立

### 创新点 5｜厨房秤式浮动架 + 单点称重：托盘不再坐在底壳上

- **问题**：原模型的托盘直接放在底壳口上，称重片在下面悬空 4 mm——**称重片根本不受力**；"只称药芯"只写在文档里。
- **借鉴**：厨房秤——一只单点（平行梁）称重传感器放在中间，上面托一块秤盘；单点传感器本身做了偏载补偿，东西放在秤盘哪个角，读数都一样。
- **落法**：
  - 铝浮动架（前梁 + 后梁 + 两端横梁，一体）托住托盘；
  - 后中 1 只 500 g 微型平行梁（双孔应变区），固定端坐底座凸台，自由端经垫块托住浮动架；
  - 托盘底比底座口高 **0.8 mm**——这条浮动缝在外观上就是原来的分模线，**外观零代价**；
  - 4 个 TPE 过载限位柱，离浮动架 0.5 mm，只在被按压或跌落时才接触。
- **证据**（整机校验）：托盘只与浮动架接触；托盘离底座 0.8、离铰链脊 0.8、离铰链梁 0.6、离传感板 1.2；浮动架离底座 0.9、离传感板 2.0；称重传感器固定端离浮动架 0.77。
- **为什么是"只称药芯"**：电池、主板、外壳、屏幕全部在称重链之外，传感器量程只需覆盖托盘 + 7 杯 + 药（约 200 g），500 g 量程目标分辨 0.2–0.5 g（**目标**，需台架验证）。

### 创新点 6｜三点运动学定位（锥窝 / V 槽 / 平面）：每次放回去都在同一个位置

- **问题**：托盘要整盘取出装药、再放回去。普通"四角平面落座"是过定位：四个点只要有一点不平就会翘、会晃，每次落座的受力都不同，去皮就漂。
- **借鉴**：精密仪器、光学平台、三坐标测量机常用的 **Maxwell 运动学定位**——三个球分别落在锥窝（限 3 个自由度）、V 槽（限 2 个）、平面（限 1 个），正好约束 6 个自由度，不多不少，放回去重复精度可到微米级。
- **落法**：托盘底 3 个 R3 半球脚；浮动架后梁左端锥窝（90°）、右端 V 槽（指向锥窝）、前梁中间平面。三个点同时是唯一的传力点。
- **证据**：托盘 × 浮动架干涉 0、间隙 0（相切接触）；托盘其余部位与底座无接触。
- **配合价值**：落座不会给秤加额外预载 → 放回即"自动去皮"可靠；托盘不会因为桌面不平而晃。
- **边界**：PP 球脚会磨损；量产可用不锈钢球嵌件。

---

## 三、感知：电子件全部留在底座，药芯不带电

### 创新点 7｜光路：杯坐底 + 通光孔 + 隔光墙，7 组红外互不串光

- **问题**：原杯底悬空 1.5 mm，托盘底 1 mm 实心 PP，红外要穿透；7 组之间无任何隔光，相邻格会串光。
- **落法**：杯直接坐托盘底；托盘底每格开 10×24 通光孔，下方两侧 1.6 mm 隔光墙（离传感板 1.2，不碰秤）；传感板每格 1 颗导光 LED + 1 对红外对管。"今日格"的 LED 透过半透明 PP 杯底发光，就是格内导光。
- **证据**：隔光墙、LED、红外对管与浮动架、托盘全部零干涉（两两校验 95 对）。

### 创新点 8｜开盖检测借笔记本电脑：霍尔在铰链脊，磁铁在盖后壁

- **问题**：如果霍尔做在托盘上，托盘就带电，不能水洗，也不能整盘拿走。
- **借鉴**：笔记本电脑的合盖检测——磁铁在屏幕边，霍尔在机身里。
- **落法**：日盖铰链梁改挂在底座的"铰链脊"上（不在托盘上），7 颗霍尔藏在铰链脊顶部；每个日盖后壁嵌 1 颗 Ø3×1.5 磁铁，开盖时随盖转开。
- **结果**：**托盘 + 7 杯 + 密封垫这一整套药芯不带任何电子件**，可整盘取出、水洗、预装。
- **证据**：日盖开合 0–105° 与铰链脊零干涉；托盘离铰链脊 0.8。

---

## 四、保存：干燥剂终于进了密封腔

### 创新点 9｜每盖 1 片干燥片 + 一件多腔密封垫

- **问题**：原设计干燥剂放在底座里，而密封腔是"托盘口 + 日盖"——**干燥剂根本不在密封腔里**；7 个独立硅胶圈有 7 份累计公差。
- **落法**：每个日盖内顶卡 1 片 30×34×2 硅胶干燥片 + 冲孔格栅（开盖就能换）；7 圈密封合并成 1 件多腔硅胶垫，一次定位。
- **证据**：干燥片与杯后勾手在前后方向错开 ≥4 mm，闭盖不碰。
- **边界**：IP54 与 7 天湿度保持要打样测；干燥片用量 1 g/格是估算。

---

## 五、装药：一周的药，一次装完

### 创新点 10｜同轴空程联动全开：拨一下，7 个盖一起开

- **问题**：给一周装药要逐个开 7 个盖。
- **借鉴**：单向拨爪 / 空程联轴（棘轮、离合器里常用）——主动件只在一个方向推从动件，从动件可以自己先走。
- **落法**：7 个日盖共用的铰链销做成驱动轴，每个铰链节里一只拨爪 + 一段约 150° 的空程槽；右端一个小拨片。拨片转 100°，拨爪推 7 盖同时翻开；拨回去，盖靠自重 + 阻尼跟着合上。单独开某一格时，盖带着铰链节在空程槽里转，轴不动。机构全部与日盖同轴、藏在铰链节里，外观只多一个拨片。
- **证据**：联动 0→100° 每 10° 校验，拨片 / 拨爪 / 7 盖与托盘、底座、铰链脊、杯零干涉；单开一格到 100°，拨爪不碰铰链节。
- **试过并放弃的方案**：在铰链后方加一根"压条"压日盖尾翼。日盖绕后下角翻开时，后壁会扫过铰链后方约 R9.5 的区域，压条放在哪里都会被单独打开的盖撞上（三角面相交检测查出）。
- **边界**：铰链节只有 Ø4.2，拨爪与空程槽是概念尺寸，量产要加粗铰链节或改金属销。

### 创新点 11｜提耳整盘提出 + 装药漏斗模板

- **问题**：托盘四周只有 0.8 mm 称重浮动缝，没有能抓的地方；在盒子上逐格装药容易撒、容易装错格。
- **借鉴**：烤盘的端耳；药房分装用的漏斗 / 模板。
- **落法**：托盘两端各一只提耳（伸出端面 2 mm，仍在 320 外形以内）。全开后捏住两耳整盘提出，到桌上装；放回时三点运动学定位自动对正、自动去皮。配件"装药漏斗模板"盖在托盘口上，7 个漏斗对准 7 只杯、避开杯后勾手，药撒进漏斗就落进当天的杯，不会串格。
- **证据**：模板与杯、勾手、日盖、托盘零干涉（离勾手 0.7 mm）；拨片离托盘 0.6 mm，不碰秤；批量装药刚体动画里，各格的药都经漏斗落进本格杯。

---

## 六、研发方法：数字样机闭环（这是能持续迭代的原因）

- **全参数化**：所有尺寸在 `tools/v3/params.py` 一处，改一个数整机重建（约 1 分钟）。
- **两道独立几何校验**：自写校验（水密、两两干涉、开盖扫掠、间隙）+ Blender 官方扩展 3D Print Toolbox（非流形、自相交、薄壁）。后者查出了原设计就有的托盘两端 0.55 mm 薄壁。
- **物理仿真进设计**：倒药用刚体仿真对比新旧方案，而不是凭感觉。
- 这套流程让"取药结构"从几轮效果不佳的手工模型，变成每个参数都有出处、每个结论都有证据的方案。

---

## 七、讲述用的金句（替换原讲述稿对应句）

- 药自己不会滑，**3.4° 斜底推不动药片**；我们让手指把药"推到边再捏"。
- 原来倒药要把杯子几乎倒扣（85–100°）；现在 **40° 就出来，58° 倒空**。
- 称重片悬空 4 mm 是称不准的；现在托盘**三点落在浮动架上**，像厨房秤一样只称药芯。
- 药芯**不带一根线**：能整盘拿走、能水洗。
- 外观一点没改：0.8 mm 的称重浮动缝，就是原来那条分模线。
- 拨一下，7 个盖一起开；捏两耳，一周的药端到桌上装。

## 八、诚实边界

- 仿真是刚体近似（单一摩擦系数、无药粉/静电/受潮），只用于新旧方案比较。
- 称重分辨 0.2–0.5 g、IP54、干燥片寿命、勾手和弧底手感：**都还没实测**。
- 日盖的按压弹开机构（push-push + 阻尼）本轮仍只有外形。
- 托盘由 310 加宽到 312（两端外壁 0.55 → 1.6），需设计确认外观。
