anweat/idea-05b-smart-medicine-box/v3/01_设计文档/34_成本估算_v3.md

# IDEA-05B 智能药盒 v3 · 成本估算

> 日期：2026-10-26 · 口径：**1k 批量、出厂成本、不含税运**；模具单列、按产量摊销。
> 依据：电子料单价来自 `notes/research_components.md`（华秋 / 立创报价，标"估"的为区间中值）；
> 结构件重量由 3D 模型 `model/v3/IDEA-05_box_v3.blend` 体积 × 材料密度算出（底座、铰链脊按量产抽壳到 2–2.5 mm 壁厚折算）。
> 全部为**设计阶段估算**，下单前需向供应商询价核实。

---

## 1. 一句话

**出厂成本约 ¥210 / 台（¥185–235），一次性模具约 ¥11–18 万。**
v3 的 11 条结构创新里，取药 5 条、提耳、通光孔 / 隔光墙都是"模具里的几何"，**不增加零件**；全部创新合计只多约 **¥17 / 台（约 8%）**。

| 构成 | ¥ / 台 | 占比 |
|---|---|---|
| 电子 BOM | 152 | 73% |
| 结构件（壳体、托盘、杯、盖、浮动架、联动轴、密封、干燥片…） | 38 | 18% |
| 组装 + 称重标定 + 出厂测试 | 12 | 6% |
| 包装 + 说明书 | 6 | 3% |
| 装药漏斗模板（随机附送） | 1.5 | 1% |
| **合计** | **≈ 210** | 100% |

---

## 2. 电子 BOM（≈ ¥152）

| 物料 | 选型 | 数量 | 单价 | 小计 |
|---|---|---|---|---|
| 主控 | ESP32-C3-MINI-1（WiFi + BLE 单芯片） | 1 | 12.0 | 12.0 |
| 称重传感器 | 500 g 微型平行梁（单点） | 1 | 20.0 | 20.0 |
| 称重 ADC | HX711 | 1 | 2.2 | 2.2 |
| 红外对管 | ITR9608 类，每格 1 对 | 7 | 1.0 | 7.0 |
| 导光 LED | 每格 1 颗 | 7 | 0.15 | 1.0 |
| 霍尔 | AH1815，每格 1 颗 | 7 | 1.8 | 12.6 |
| 温湿度 | SHT40 | 1 | 4.0 | 4.0 |
| 光照 | VEML7700 | 1 | 4.3 | 4.3 |
| 离线语音 | SU-03T | 1 | 8.0 | 8.0 |
| 功放 + 麦克风 | NS4168 + MEMS | 1 | 9.0 | 9.0 |
| 扬声器 | 8 Ω 2 W + 音腔 | 1 | 4.8 | 4.8 |
| 段码屏 | 定制 58 × 18 | 1 | 12.0 | 12.0 |
| 电池 + 充电 | 3000 mAh 带保护 + TP4056 | 1 | 19.0 | 19.0 |
| 接口 | Type-C + 4 pin 磁吸 pogo | 1 | 7.0 | 7.0 |
| 主板 | 4 层 60 × 90 | 1 | 10.0 | 10.0 |
| 传感板 | 2 层长条 280 × 38（LED / 红外） | 1 | 6.0 | 6.0 |
| 霍尔柔性板 | FPC，藏在铰链脊里 | 1 | 5.0 | 5.0 |
| 阻容 / ESD / 线材 | — | 1 | 8.0 | 8.0 |
| **小计** | | | | **≈ 152** |

---

## 3. 结构件（≈ ¥38）

| 零件 | 材料 | 重量（模型算） | ¥ / 台 | 说明 |
|---|---|---|---|---|
| 底座外壳 + 前脸件 | 暖白 ABS | ≈ 70 g（抽壳后） | 8.0 | 含前脸装饰件、按键帽 |
| 铰链脊 | ABS | ≈ 12 g（抽壳后） | 1.3 | |
| 托盘（含提耳、球脚、隔光墙） | 食品级 PP | 66 g | 2.5 | 一体注塑 |
| 药杯 × 7 | 食品级 PP | 10.8 g / 只 | 3.5 | 7 腔一模；勾手、倒嘴、弧底、切角都在型腔里 |
| 日盖 × 7 | 烟灰 PC | 6.3 g / 只 | 4.4 | 4 腔模 |
| 称重浮动架 | 铝 | 29 g | 4.0 | 冲压折弯 |
| 多腔硅胶密封垫 | 食品级硅胶 | 0.4 g | 1.0 | 1 件替代 7 圈 |
| 联动驱动轴 + 拨爪 + 拨片 | 不锈钢 + POM | 7 g | 2.5 | |
| 日盖扭簧 + 阻尼 × 7 | — | — | 4.0 | 按压弹开、阻尼下放 |
| 磁铁 × 7 | Ø3 × 1.5 N35 | — | 0.7 | 开盖检测 |
| 干燥片 × 7 + 格栅 × 7 | 硅胶 1 g / 片 + PP | — | 3.1 | 干燥片为耗材 |
| 过载限位 + 脚垫 | TPE | — | 1.0 | |
| 紧固件 / 泡棉 / 双面胶 | — | — | 2.0 | |
| **小计** | | | **≈ 38** | |

---

## 4. 创新带来的成本增量（相对"同外形、无这些结构"的普通智能药盒）

| 创新 | 新增什么 | 增量 ¥ / 台 |
|---|---|---|
| 量杯式勾手 / 数药盘收拢 / 硬币杯弧底 / SIM 卡防呆 / 卡匣导入 | 无——都是杯和托盘模具里的几何 | 0 |
| 同轴空程联动全开 | 驱动轴 + 拨爪 + 拨片 | +2.5 |
| 提耳整盘提出 | 无——托盘一体 | 0 |
| 装药漏斗模板 | 配件 | +1.5 |
| 浮动架 + 三点定位 + 过载限位 | 铝架、TPE 柱 | +5.0 |
| 通光孔 + 隔光墙 | 无——托盘一体 | 0 |
| 霍尔进铰链脊（药芯不带电） | 柔性板 | +5.0 |
| 干燥片进日盖 | 干燥片 + 格栅 | +3.1 |
| 一件多腔密封垫 | 替代 7 圈 | ≈ 0 |
| **合计** | | **≈ +17（约 8%）** |

---

## 5. 一次性模具（≈ ¥11–18 万）

| 模具 | ¥ 万 |
|---|---|
| 底座外壳（前脸开孔，带滑块） | 2.5–4.0 |
| 前脸装饰件 / 按键帽 | 0.8–1.5 |
| 铰链脊 | 0.8–1.2 |
| 托盘（7 杯位 + 提耳 + 球脚 + 隔光墙） | 1.8–2.8 |
| 药杯 7 腔 | 2.0–3.0 |
| 日盖 4 腔（PC 高光） | 1.5–2.5 |
| 装药漏斗模板 | 0.8–1.2 |
| 浮动架冲压模 | 0.5–1.0 |
| 硅胶密封垫 | 0.3–0.6 |
| 拨片 / 拨爪小件 | 0.3–0.5 |
| **合计** | **≈ 11–18** |

**按产量摊销到每台**：1 千台 +¥110–180；5 千台 +¥22–37；1 万台 +¥11–18。
→ 首批 1 千台主要用于验证，模具成本要靠第二批起摊薄；量产 5 千台起，每台总成本约 ¥230–250。

---

## 6. 定价与使用成本

- **价格带**：白牌 7 格药盒 ¥23–45（只分格 + 闹铃）；进口自动分药机按月收费 ¥213–888 / 月。¥299–399 的买断式智能药盒是空档。
- **建议零售**：首批 ¥399；量产 1 万台后可下探到 ¥349。家属端云服务"基础免费 + ¥9.9 / 月高级"另计。
- **用户的持续花费**：只有干燥片（每格 1 g，约 2–3 周一换），约 ¥2 / 月；药杯、托盘、模板都可水洗重复用。

## 7. 主要成本风险

1. 称重传感器、SU-03T、段码屏是"估"价，差异可能在 ±¥10 内；
2. 底座若要喷涂 / 高光，外观件成本 +¥3–6；
3. 联动轴拨爪是概念尺寸，量产若改金属销 + 加粗铰链节，+¥1–2；
4. 认证（3C / SRRC / EMC / GB 4806 检测）一次性约 ¥5–10 万，未计入。
