anweat/idea-05b-smart-medicine-box/06_调研笔记/research_competitors.md

# 智能药盒竞品与老年用户痛点调研（7天分格 / 称重 / 环境感应 / 离线语音 / 双端）

> 调研日期：2026-10-18｜范围：美国主流自动分药服务、中国电商热销电子药盒与白牌、老人端/家属端相关产品｜币种：美元按 ≈7.1、港元按 ≈0.92 折算人民币，均为约数。

## 0. 一页结论

- **需求侧成立**：我国社区老年多重用药者不依从率约 31.8%–48.8%，平均服用 6 种药[S37][S40]；这不是“伪需求”。
- **市场两极分化**：一端是 Hero、MedMinder、Philips MD.2 等“月费制服务”（约 ¥213–888/月），卖的是自动分药 + 家属通知；另一端是中国白牌（¥23–45）只做“分格 + 闹铃”。¥199–399 的“买断式智能硬件”几乎是空档。
- **“是否真的吃了”仍未被解决**：主流产品用开盖/按键/按时出格来推断，行业受访者直言“开盖判断准确性有限”“是否真吃无法判断”[S27]；称重是更可靠的替代方案[S31]，但消费级产品极少见。
- **中国老人的真实摩擦点是“开、倒、看、记”**：盖子难开、格子小、字看不清、忘了吃没吃、提示音听不见，而非“缺一个 APP”。
- **离线能力是硬需求**：60 岁以上占全部非网民的 46.8%[S34]，配网、微信授权、手机常开对很多老人不可行；断网必须仍能提醒和记录。
- **双端正确分工**：长者端做“家电”（零账号、零配网、物理键），家属端做“管理后台”（排药、换芯、异常分级、远程代设）。

## 1. 方法与口径

- 检索方式：Exa 网页检索 + 厂商页面/帮助中心 + 京东/淘宝商品页 + 学术与专利文献；评价类内容只引用可检索到的原文摘要，不做改写式“编造”。
- 价格：为检索时页面标价或媒体报价，含众筹价、研究期租赁价；带“约”者为折算或区间，**不代表当前成交价**。
- 尺寸：英寸换算为毫米并四舍五入；厂商未公开的字段一律写“未获取”，不推测。
- 局限：京东/淘宝商品页多有反爬，部分白牌只拿到标题、价格与评论数；Pillo 据用户投诉已停止支持，其数据为历史值。

## 2. 竞品对比表

| 产品/型号 | 分格数 | 尺寸(mm) | 重量 | 提醒方式 | 联网 | 传感器 | 供电/续航 | 价格(¥) | 主要优点 | 主要槽点 |
|---|---|---|---|---|---|---|---|---|---|---|
| Hero Health Smart Dispenser | 10 个药仓，90 天药量（非 7 天分格） | 约229×229×381 | 约4.5kg（10 lb） | 声音+闪灯+APP | Wi-Fi 2.4GHz | 未获取 | 市电 | 约213/月起（$29.99/月，12个月预付） | 自动排序分药、90天药量免每周分装、家属APP、24/7支持 | 体积大、月费制、不支持半片/软糖/粉末 |
| MedMinder Jon / Maya | 28 格（7天×4次） | 约356×279×51 | 未获取 | 闪灯+蜂鸣+语音提示+电话/短信/邮件 | 内置蜂窝（无需Wi-Fi） | 未获取 | 市电 | 约888/月（$125/月；另有$39.99–64.99/月说法） | 老人无需智能手机、远程代设、Jon 可锁格防多吃 | 月费高、需家属/药师装药、整机与托盘占地大 |
| Philips MD.2（Lifeline） | 42–60 个药杯（最多6次/天） | 约330×305×356 | 未获取 | 语音+文字屏+红色闪光+电话呼叫4位家属 | 电话线（PSTN） | 未获取 | 市电+18小时备电 | 仅租赁；研究期$90/月（约639） | 大药杯易开、可上锁、漏服电话逐级升级 | 体积最大、依赖固话、价格不透明、需护理方定期装药 |
| EllieGrid | 7 格（按药种分，不按天） | 约197×108×32 | 未获取 | 闹铃+仓位灯+APP推送 | 蓝牙 | 未获取 | 充电锂电池，约1周 | 约1058（$149，2019年价） | 整瓶倒入、30秒补药、灯光提示粒数 | 太大、不能静音/贪睡、报表与家属提醒另收费 |
| Pillo / Pria | 28 次剂量 | 未获取 | 未获取 | 语音对话+屏幕+视频通话+APP | Wi-Fi | 摄像头、人脸识别 | 市电 | 约3543（$499含1年服务；Pria约$750） | 可对话、视频通话、家属远程查看 | 贵、项目停止支持并改名 Pria（用户投诉）[S12]、摄像头引发隐私顾虑 |
| MOBI Smart Dispenser | 28 格 | 未获取 | 未获取 | 声音+LED闪烁+APP | Wi-Fi 双频 | “自动检测取药”（原理未披露） | 4×AA 电池 | 约1065（$149.99） | 28格+UV避光盖+双锁、可离线按键操作 | 检测原理不透明、AA电池、机身尺寸未公开 |
| HiPee PB1（小米有品/华为HiLink） | 4 格 | 130×45×39 | 未获取 | 滴滴声+仓位绿灯+微信公众号 | 蓝牙+微信 | 无环境传感 | CR2032 纽扣电池（续航未获取） | 119–129 | 便宜、扫码添药、微信即用、FDA内胆 | 4格不够、纽扣电池难换、开大盖即算服药 |
| Memo Box（Tinylogics） | 4 格（可换2/4/7天内芯） | 100×76×22 | 72g | 蜂鸣+呼吸灯+APP | 蓝牙（另有SIM版） | 无环境传感 | 未获取 | 99–398（京东众筹价）[S19] | 小巧、红点奖、可换内芯、重复服药红灯 | 提示音小且不可调、APP Bug、忘带提醒失效 |
| SEC P56（21格WiFi自动药盒） | 21 格 | 未获取 | 未获取 | 响闹+LED灯条+APP推送 | Wi-Fi | 无环境传感 | 电池（容量未获取） | 约990（HK$1,080） | 转盘自动出格、可锁、最多9次/天、可拆转盘 | 只能App设定、香港渠道、无环境感应、无称重 |
| 药准时（App） | 无硬件（虚拟药箱） | — | — | APP通知+桌面小组件 | 手机 | — | 手机 | 0 | 大字、免注册、库存/过期提醒、子女共享 | 无硬件联动；用户差评“不提醒不响铃，有毛用”[S21] |
| folca F1908 | 6 格 | 未获取 | 未获取 | 定时闹铃 | 无 | 无 | 未获取 | 45（市场价59）[S39] | 便宜、六格便携 | 无APP/无家属端、未见语音功能 |
| 白牌 7格电子药盒（淘宝） | 7 格 | 未获取 | 未获取 | 定时闹铃 | 无 | 无 | 未获取 | 44.2[S23] | 极便宜、结构简单 | 无记录、无远程、无音量标注、无电子防错 |
| 白牌“语音”7天药盒（淘宝） | 7 天 | 未获取 | 未获取 | 语音闹铃 | 无 | 无 | 未获取 | 119[S24] | 语音提醒，老人更易理解 | 无联网/无记录、语音内容固定 |
| 金隆兴 21/28格大字版 | 21 或 28 格（7天×3/4） | 未获取 | 未获取 | 无电子提醒 | 无 | 无 | 无 | 22.9–28.21[S25][S26] | 大字、密封、极便宜、销量高 | 纯机械、靠自觉、无电子防错 |

**读表要点**：① “格数”含义不同——Hero/MedMinder/Pillo 是自动出药，EllieGrid 是“按药种”分格，中国白牌才是“按天×顿”分格；② 只有 Pillo 明确带摄像头，称重与环境感应在这 14 款中均未出现；③ 进口产品几乎都靠“服务费”而非硬件差价。

## 3. 老年人真实使用痛点（12 条）

1. **盖子/药瓶难开**：84 岁老人拧不开药瓶，连老虎钳都用上[S35]；12 项观察研究一致发现相当比例老人打不开包装，儿童安全盖最难[S36]；HiPee 评测也指出盒盖边缘摩擦力不足、需双手[S17]。
   → 启示：主开盖做大面积防滑翻盖+助力凸缘，开盖力实测并标注；避免儿童安全锁式结构。
2. **格子太小/太深，药片倒不出来**：HiPee 小仓放不下一次 3–4 粒，需用手抠[S17]；专利直言取药易污染、开盒用力会致药物溢出[S30]。
   → 启示：一格对应一顿，斜底+倒药口，药杯可整体取出，格深与容量按“最大药片×粒数”定义。
3. **分不清早中晚、分不清哪一格**：京东热销款把“早中晚”“大字版”当核心卖点[S22]；调查显示老人平均服 5–6 种药、存放混乱[S28]。
   → 启示：早/中/晚三色+凹凸触感+图形，一格只放一顿，不做纯文字排布。
4. **忘了到底吃没吃**：药准时把“记不清吃没吃”写进宣传语[S21]；HiPee 以打开大盒盖判定，打开没吃也算[S17]；行业受访者承认开盖判断准确性有限[S27]。
   → 启示：显示“未到/待服/已取/已确认”四态，用物理翻牌或常亮灯保持状态，不依赖记忆。
5. **提示音听不见**：Memo Box 实测提示音偏小、不可调、无振动[S18]；我国 60 岁以上人群听力损失现患率约 45%[S33]，80 岁以上约 90% 会出现听力损失[S32]。
   → 启示：低频+大音量+闪光+振动多模态；音量可调；未响应时逐级升级（重复→家属）。
6. **APP 太复杂、不会用**：社区老人质性研究归纳出“接纳意愿不高”“技术焦虑”[S29]；HiPee 评测认为操作对长辈偏复杂[S16]。
   → 启示：长者端零 APP/零账号；家属端代设；设备本地可完成全部日常操作。
7. **充电/换电池麻烦**：HiPee 的 CR2032 更换费劲[S17]；EllieGrid 每周一充[S9]；MD.2 需常年插电[S6]。
   → 启示：半年级续航+易换标准电池仓/磁吸充电；低电提前一周提示并同步家属端。
8. **受潮、避光、变质**：专利指出普通塑料盒遮光性差、耐热度差，易使药物变质[S30]；京东把“密封防潮/避光”作为卖点[S22]。
   → 启示：密封圈+干燥剂位+避光材质；温湿度超阈给“现在该做什么”，不只显示数字。
9. **看不清标签、字太小**：21/28 格“大字版”成为热销款[S22]；HiPee 仓位数字与盖同色、老人难辨[S17]。
   → 启示：高对比大字号+图标+语音报药名；标签可更换、可由家属打印。
10. **带出门太大**：EllieGrid 被评“too big”[S9]；Hero 重约 4.5kg[S1]、MD.2 宽 330mm[S7]，均无法随身。
    → 启示：主机留家+单日药仓可拆带走，或“家用底座+便携药芯”双件式。
11. **家属无法确认是否真吃**：行业承认“是否真吃目前真的做不到”[S27]；MedMinder、Hero 都把家属通知当核心卖点[S4][S1]。
    → 启示：家属端看事件流（开盖/减重/确认），标注置信度与“已取出未确认”，不伪报“已服药”。
12. **换药/备药繁琐**：HiPee 需一粒粒放入、药板装填麻烦[S16]；MedMinder 需药师或家属预装托盘[S4]。
    → 启示：药板直插/漏斗/可整体取出的药仓；把“一周一次装药”压缩到 5 分钟内。

## 4. 市场空档与差异化机会（7 条）

### 4.1 称重校验：能解决“开盖≠服药”，但不能宣称“确认吞服”
- 物理边界：单粒药约 50–500mg，要分辨“少了一粒”需 0.01g 级分辨率，还要抗温漂、振动、手压；药片被取出后丢弃、掰半片、换格都会误判。
- 学术结论：基于重量变化的检测比开盖/按钮确认更可靠[S31]；但它只能证明“药离开了药仓”，不能证明“被吞下”。
- 机会：**三源融合**（称重+开合+老人按键/语音确认），输出三档状态——“已确认服用 / 已取出未确认 / 未动”，家属端显示置信度而非二元“已服”。
- 附加价值：装药时用称重做**每格基线校验**，装错格、漏装、多装立即提示，这比“服药检测”更容易做出确定性。

### 4.2 双端分工：长者端做“家电”，家属端做“管理后台”
- 长者端：无账号、无配网、无触屏依赖；三个物理键（“我吃了”/“稍后”/“叫人”），大字+语音，断网可用。
- 家属端：排药计划、库存与换芯提醒、异常分级（未开盖 > 开盖未减重 > 减重异常 > 设备离线）、远程代设、多家属协同。
- 权限设计：老人可“延后/静音”，但次数与时长同步家属；避免“被监控感”导致抵触（技术焦虑已被质性研究证实[S29]）。

### 4.3 离线语音 vs 联网：离线优先，联网只做增值
- 断网仍要定时、语音、记录：本地 RTC+Flash+离线 TTS；联网只负责同步、远程、OTA。
- 依据：60 岁以上占全部非网民的 46.8%[S34]；老人家中 Wi-Fi 不稳定、不会配网是常见门槛。
- 语音策略：家属录音+离线 TTS 双轨，方言/语速可调；不把微信/APP 推送当唯一提醒通道。

### 4.4 换药芯/备药：把“一周一次”做成 5 分钟
- 结构：抽拉式药仓可整体拿到桌面；每格独立开盖；药板直插或配漏斗；周几/早中晚做凹凸防呆。
- 流程：家属端“换芯模式”逐步语音引导，装完自动称重复核并生成新基线；漏装/错格当场提示。
- 兼容：半片、胶囊、大颗钙片；明确标注每格容量与最大片数，避免“装得下但盖不上”。

### 4.5 环境感应必须“给动作”，否则是参数装饰
- 温湿度/光照只有转成行动才有价值：湿度>70% 提醒加干燥剂/除湿；光照超阈提醒避光或换位置；温度>25℃ 提醒远离暖气。
- 传感器应放**仓内**而非机身，否则测的是室温不是药仓微环境；与密封结构联动设计。

### 4.6 价格带空档：¥199–399 买断 + 可选云服务
- 白牌 ¥23–45 只解决“分格+闹铃”；进口 $30–125/月是服务费而非硬件价[S2][S5]。
- 中国老人/子女更接受一次性买断；家属云服务可“基础免费+¥9.9/月高级”（历史记录、多家属、电话升级）。

### 4.7 适老化多模态与隐私
- 提醒：低频大音量+闪光+振动+语音报药名，四通道至少三路；避免只有 APP 推送。
- 隐私：不做摄像头（Pillo 的摄像头/人脸识别可能引发抵触[S11]）；数据本地优先，家属授权可见，老人可查“谁看过”。

## 5. 对我方产品的 10 条硬指标建议（可直接进 PRD）

1. 7 天×3–4 顿分格，一格一顿；早/中/晚三色+凹凸+图形，格口≥可倒出 4 粒大钙片。
2. 每格独立称重，分辨率 0.01g；给出“已确认/已取出未确认/未动”三态，禁止直接显示“已服药”。
3. 装药基线校验：换芯后逐格称重比对，错格/漏装即时语音提示。
4. 离线优先：断网可定时、可语音、可记录 30 天；联网仅同步与远程。
5. 长者端三个物理键+大字+语音，无账号；家属端小程序/APP 完成全部设置。
6. 开盖力实测并标注；大面积防滑翻盖+助力凸缘；单格可整体取出。
7. 多模态提醒：≥75dB 可调+低频+闪光+振动；未响应 3 次升级家属。
8. 环境三参（温度/湿度/光照）+具体行动建议；传感器置于药仓内。
9. 续航≥6 个月或磁吸充电；低电提前 7 天双端提示。
10. 便携：主机留家，单日药仓可拆；整机重量目标≤1.2kg，可单手提拿。

## 6. 来源清单

- [S1] [Hero 产品规格页（尺寸/重量/90天药量）](https://herohealth.com/our-product/)
- [S2] [Hero 定价页（$29.99–59.99/月）](https://herohealth.com/pricing/)
- [S3] [MedMinder 产品册（28格、蜂窝、提醒方式）](https://pdf.medicalexpo.com/pdf/medminder/get-to-know-medminder/84219-98027.html)
- [S4] [MedMinder Jon 说明（14×11×2 in、电话升级、预装托盘）](https://globalrph.com/2021/03/technology-assisted-methadone-take-home-dosing-for-patients-with-opioid-use-disorder/)
- [S5] [The Senior List 自动分药器对比（MedMinder $125/月）](https://www.theseniorlist.com/medication/dispensers/)
- [S6] [Philips MD.2 FAQ（药杯、电话线、备电、仅租赁）](https://www.epill.com/md2qa.html)
- [S7] [MD.2 居家满意度研究（13×12×14 in、$90/月租赁）](https://pmc.ncbi.nlm.nih.gov/articles/PMC4122419/)
- [S8] [EllieGrid 官方规格（7.75×4.25×1.25 in、1周续航）](https://elliegrid.com/)
- [S9] [Reviewed EllieGrid 评测（$149、太大、不能静音、订阅费）](https://www.reviewed.com/smarthome/features/elliegrid-smart-pill-box-review)
- [S10] [MobiHealthNews Pillo 上市（$499、28剂量、摄像头）](https://www.mobihealthnews.com/news/conversational-treatment-adherence-device-pillo-launches-consumers)
- [S11] [Fierce Healthcare Pria（$750、人脸识别、$10/月）](https://www.fiercehealthcare.com/tech/new-robot-offers-home-monitoring-and-medication-dispensing)
- [S12] [Pillo Indiegogo 评论区（支持终止、改名 Pria，用户自述）](https://www.indiegogo.com/en/projects/pillohealth/pillo-your-personal-home-health-robot/comments)
- [S13] [MOBI 28格智能药盒（$149.99、Wi-Fi、4×AA）](https://mobiusa.com/products/smart-pill-medication-dispenser)
- [S14] [小米有品 HiPee 智能健康药盒（¥119）](https://www.xiaomiyoupin.com/detail?gid=105782)
- [S15] [华为商城 HiPee PB1（¥129、HiLink）](https://m.vmall.com/product/10086740904156.html)
- [S16] [亿智蘑菇 HiPee 测评（130×45×39mm、CR2032、逐粒装药）](http://images.yzmg.com/article/show-2755.html)
- [S17] [智能界 HiPee 测评（盖子难开、字难辨、开大盖即算服药）](http://m.znjchina.com/huati/18480.html)
- [S18] [爱搞机 Memo Box 测评（100×76×22mm/72g、提示音小、APP Bug）](https://www.igao7.com/news/201608/k2MBpY0qPWUyK3Xa.html)
- [S19] [Memo Box 中国众筹价 ¥99–398](https://www.10100.com/article/150018045)
- [S20] [SEC P56 21格 WiFi 自动药盒（HK$1,080、9次提醒、可锁）](https://www.easy66.com.hk/products/sec-dispenser-wifi-p56)
- [S21] [药准时 App Store 页（免费、3.5分、差评“不提醒不响铃”）](https://apps.apple.com/cn/app/id6754901017)
- [S22] [京东智能定时药盒价格页（21/28格大字版、密封防潮卖点、销量）](https://www.jd.com/jiage/1318c3ab319052e4c306.html)
- [S23] [淘宝白牌 7格电子药盒 ¥44.2](https://pcdetail.taobao.com/MXQ1ZjFINC9UVTRueHV6eHBRUHB0QT09.html)
- [S24] [淘宝白牌语音 7天药盒 ¥119](https://pcdetail.taobao.com/Um9IRkhUbC85TWJCQzlYR3pFYXdzZz09.html)
- [S25] [淘宝 金隆兴 B8335（21/28格，¥22.9 起）](https://pcdetail.taobao.com/U3BKZWw2ZHBtTzZzSkNOUXJwRXMvQT09.html)
- [S26] [慢慢买 金隆兴 28格京东自营 ¥28.21](https://cu.manmanbuy.com/discuxiao_20176428.aspx)
- [S27] [简书《药不能停？智能药盒的尴尬和无可奈何》（单粒药太轻、开盖判定局限）](https://api3.jianshu.io/p/c238251405ea)
- [S28] [知乎《老年人智能药盒的设计现状及研究分析》（5–6种药、存放混乱）](https://www.zhihu.com/market/paid_magazine/1113913966388137984/section/1113914016266670080)
- [S29] [解放军护理杂志 2024(1) 社区老人智能药盒使用体验质性研究（技术焦虑）](https://jfjhlzz.smmu.edu.cn/jfjhlzz/article/issue/2024_1)
- [S30] [中国专利 CN202322784903《一种自称重多功能药盒》（取药污染、溢出、遮光差）](https://www.xjishu.com/zhuanli/05/202322784903.html)
- [S31] [IRJET 2025《Smart Pill Box Monitoring System…Weight Based Detection》（称重优于开盖）](https://www.irjet.net/archives/V13/i5/IRJET-V13I0537.pdf)
- [S32] [中新网《中国听力健康报告（2025）》（60+ 听力损失 11.04%、80+ 约90%）](https://www.chinanews.com/life/2025/12-17/10535317.shtml)
- [S33] [国家卫健委《关于推进耳与听力健康工作的指导意见》解读（60+ 现患率约45%）](https://www.nhc.gov.cn/yzygj/c100067/202508/e0ed852183734430a6bf544f212e1b98.shtml)
- [S34] [CNNIC 第55次《中国互联网络发展状况统计报告》（60+ 占非网民 46.8%）](https://www.cnnic.com.cn/IDR/ReportDownloads/202505/P020250514564119130448.pdf)
- [S35] [杭州网《84岁大伯死活拧不开药瓶盖子，连老虎钳都用上》](https://hznews.hangzhou.com.cn/shehui/content/2020-01/15/content_7661406.htm)
- [S36] [Age and Ageing 2022 系统综述《Difficulties associated with opening medication packaging》](https://doi.org/10.1093/ageing/afac225)
- [S37] [BMC Geriatrics 2023 中国多中心研究（31.8% 不依从、平均6种药）](https://link.springer.com/article/10.1186/s12877-023-03768-7)
- [S38] [中国老年慢病居家用药依从性全国横断面调查（2025）](https://www.yydbzz.com/CN/10.3870/j.issn.1004-0781.2025.12.011)
- [S39] [甲子商城 folca F1908 六格电子药盒（¥45，市场价59）](https://www.china60.com/home/Goods/index.html?goods_id=10121)
- [S40] [Wiley 2025 中国老年多重用药依从性研究（引 48.8%/31.8%）](https://doi.org/10.1111/nhs.70192)
