anweat/idea-05b-smart-medicine-box/v3/01_设计文档/33_讲解稿_双人5分钟.md

# 适老智能药盒 · 讲解稿（双人，5 分钟）

> 配合介绍页使用：讲解人一负责「板块一 · 需求与创新」（约 520 字），讲解人二负责「板块二 · 产品与结构」（约 410 字）。
> 按正式讲解语速每分钟约 200 字计，合计约 4 分 40 秒，留有余量。
> 【】内为翻页或指图提示，不需念出。数字与页面保持一致。

---

## 讲解人一 · 需求与创新（约 2 分 35 秒）

**【封面】**
各位老师好。我们的作品是一款适老智能药盒，目标是让老年人的取药与分装更简单。

**【1.1 问题来源】**
我国老年人慢性病多病共存现象普遍。调研显示，社区老年多重用药者的服药不依从率在 **31.8% 到 48.8%** 之间，平均每人同时服用 **6 种**药物。与此同时，老年人指尖捏力仅为 **3 到 5 公斤**，患有关节炎时还会进一步下降；非网民中 60 岁及以上人群占比达到 **46.8%**。现有分格药盒以存放为主，取药要捏、分装要逐格开盖、是否已经服药无从确认——这些环节恰恰超出了老年人的能力。

**【1.2 目标人群】**
因此，我们面向三类人群：居家多病共存的老年人，手部功能或视力减退的使用者，以及负责分装药物的家属和照护人员。

**【1.3 应用场景】**
对应四个场景：每日定时取药、每周集中分装、服药状态记录，以及日常的防潮存放。

**【1.4 核心创新】**
围绕这些场景，我们提出五点创新。
第一，取药方式由"捏取"改为"倾倒与推取"，提杯倾斜约 40 度即可出药。
第二，一次开启、整盘分装：拨动拨片，七个日盖同时打开，托盘可整体取出，在桌面一次完成一周的分装。
第三，只称药品的称重结构，每次放回自动对位、归零，与开盖检测共同形成服药记录。
第四，药芯不含任何电子元件，可以整体水洗。
第五，这些结构均移植自其他领域的成熟做法，并经过三维装配校验与物理仿真验证。

**【1.5 价值与成本】**
按千台批量估算，单台出厂成本约 **210 元**，全部结构创新仅增加约 **17 元**。建议零售价 **399 元**，一次买断，定位于普通分格药盒与按月收费的进口分药设备之间。
下面由我的同伴介绍产品与结构。

---

## 讲解人二 · 产品与结构（约 2 分 05 秒）

**【2.1 产品外观】**
产品为 320 × 70 × 52 毫米的长条形桌面设备。上部是七个独立日盖，前部是段码屏和三个按键，老年人不需要使用手机即可完成操作。

**【2.2 使用方式】**
日常使用时，到点后当日药格亮灯，开启日盖，勾起药杯倾斜即可倒出。每周分装时，拨动侧面拨片，七个日盖同时开启，将托盘整体取出，配合漏斗板完成分装。

**【2.3 结构组成】**
整机自上而下由日盖、药杯、托盘、称重浮动架与传感板、底座组成。从剖面可以看到，药芯与电子部分完全分离。

**【2.4 关键结构】**
取药结构：药杯后侧设勾手，前部为收拢倒药口和圆弧杯底，杯体切去一角，防止反装。
装药结构：铰链轴兼作驱动轴，带动七个日盖同步开启；托盘两端设提耳，配合漏斗板整盘分装。
称重结构：托盘经锥窝、V 槽和平面三点支承在铝制浮动架上，下方是一只 500 克单点称重传感器，因此只称量药品本身。
感知与保存：红外与导光元件位于托盘下方，并设有隔光墙；开盖检测的霍尔传感器位于底座的铰链脊内；每个日盖内置干燥片。

**【2.5 设计验证】**
我们对整机 **103 对**零部件进行了两两干涉检查，均无干涉；联动开盖全行程无干涉；倒药仿真中，药杯倾斜 **40 度**开始出药，**58 度**完全倒空。
以上是我们的介绍，谢谢各位。

---

## 备问（不计入 5 分钟）

| 可能的提问 | 回答要点 |
|---|---|
| 称重能否证明老人已经服药？ | 不能。称重只能反映药品是否被取出，因此系统只记录"已取出并确认 / 已取出未确认 / 未取出"三种状态。 |
| 仿真结果是否可靠？ | 采用刚体仿真，未考虑药粉与受潮，主要用于方案比较；具体角度需通过样机测试确认。 |
| 为何不采用自动出药？ | 电机出药在卡药、清洁、体积与成本上代价较高，本作品优先解决取药、分装与记录三个环节。 |
| 联动开盖是否存在夹手风险？ | 日盖采用阻尼缓降；拨爪只推不拉，单独开盖不受影响。量产前需进行夹手测试。 |
| 成本估算依据是什么？ | 电子元件参考华秋、立创报价；结构件重量由三维模型体积计算；部分物料需进一步询价核实。 |
