anweat/idea-05b-smart-medicine-box/00_设计图板/01_top_layout.png

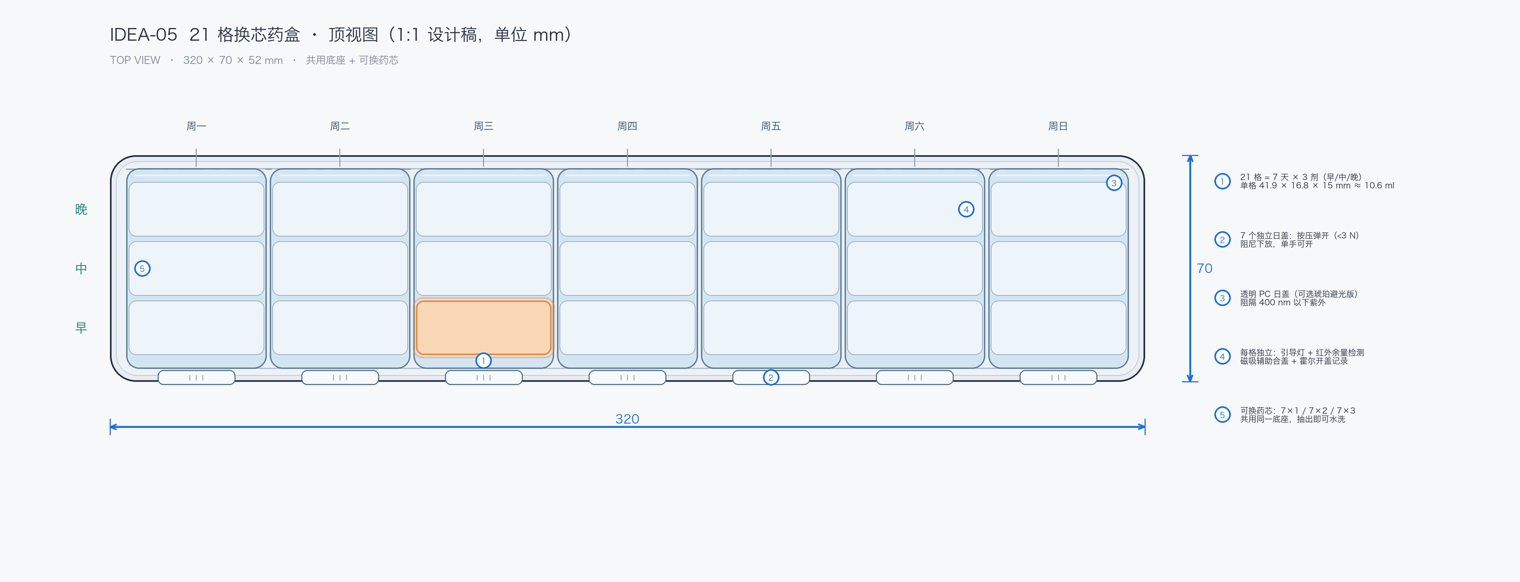
00_设计图板/01_top_layout.png
