anweat/idea-05b-smart-medicine-box/00_设计图板/02_front_view.png

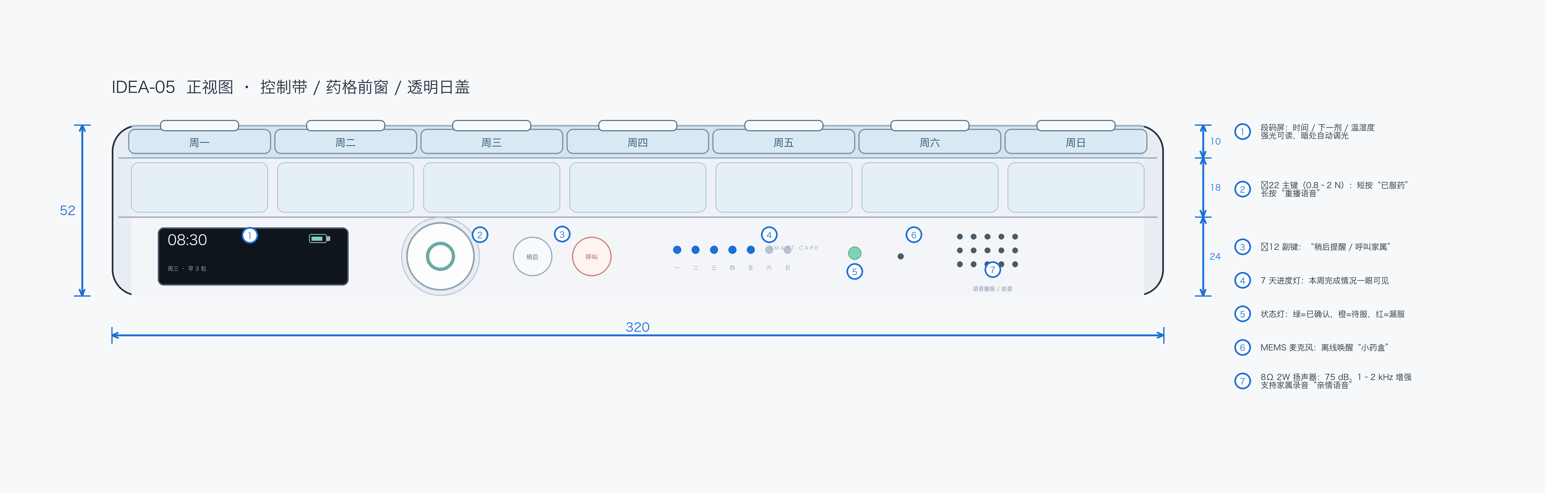
00_设计图板/02_front_view.png
