anweat/idea-05b-smart-medicine-box/00_设计图板/03_section.png

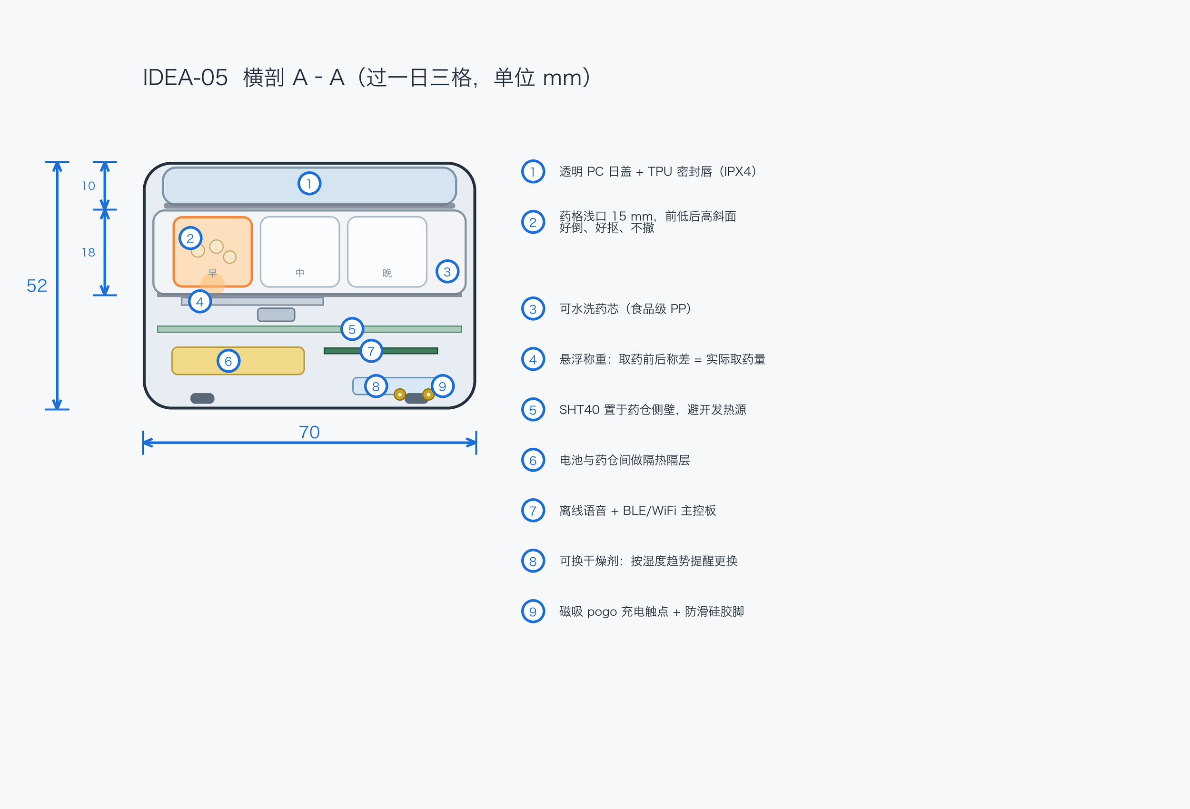
00_设计图板/03_section.png
