anweat/idea-05b-smart-medicine-box/00_设计图板/04_compare.png

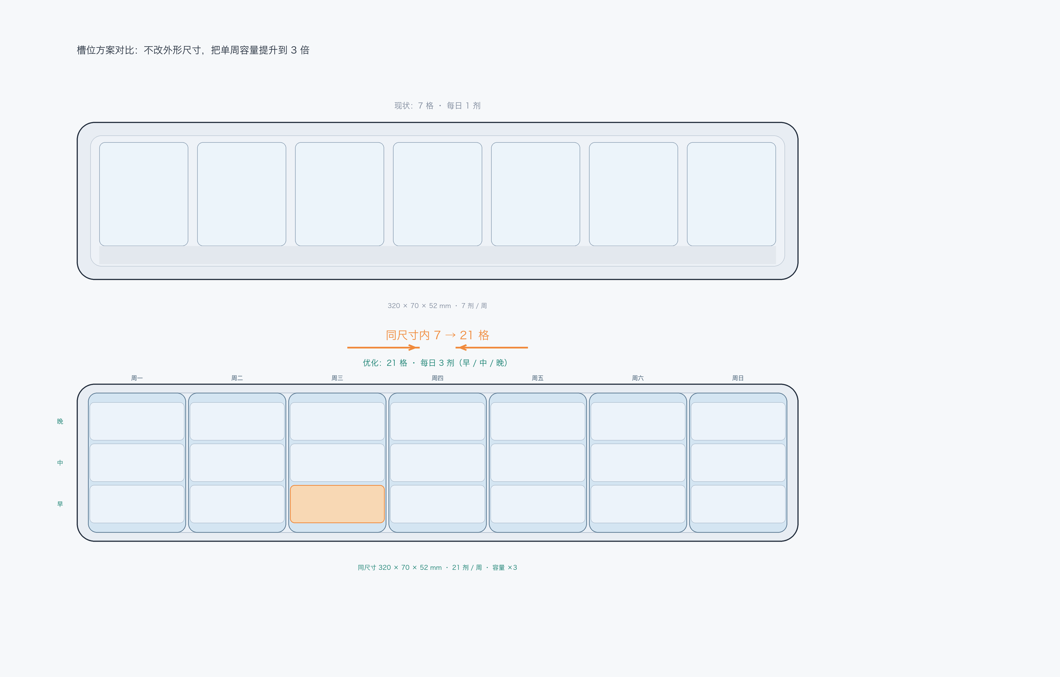
00_设计图板/04_compare.png
