anweat/idea-05b-smart-medicine-box/00_设计图板/05_retrieval_geometry.png

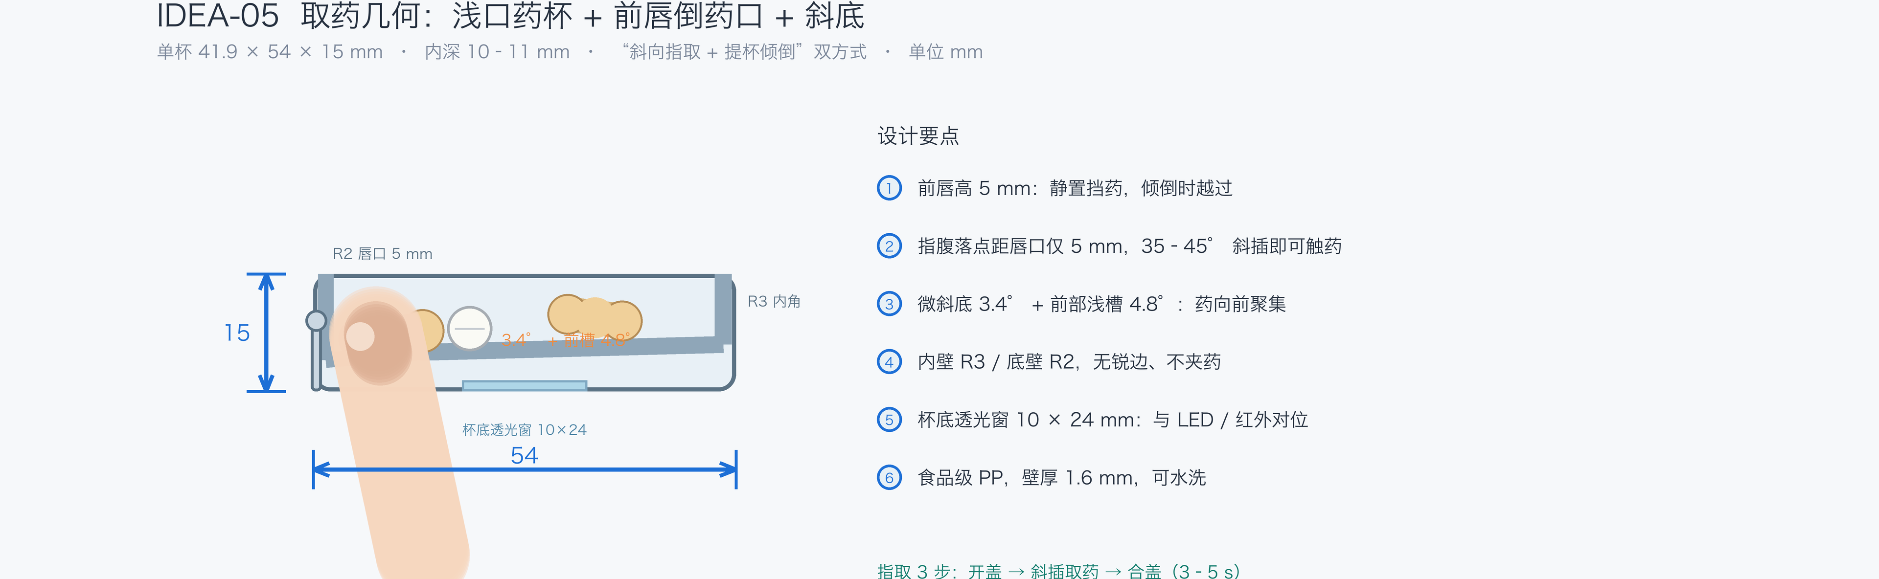
00_设计图板/05_retrieval_geometry.png
