anweat/idea-05b-smart-medicine-box/00_设计图板/06_retrieval_options.png

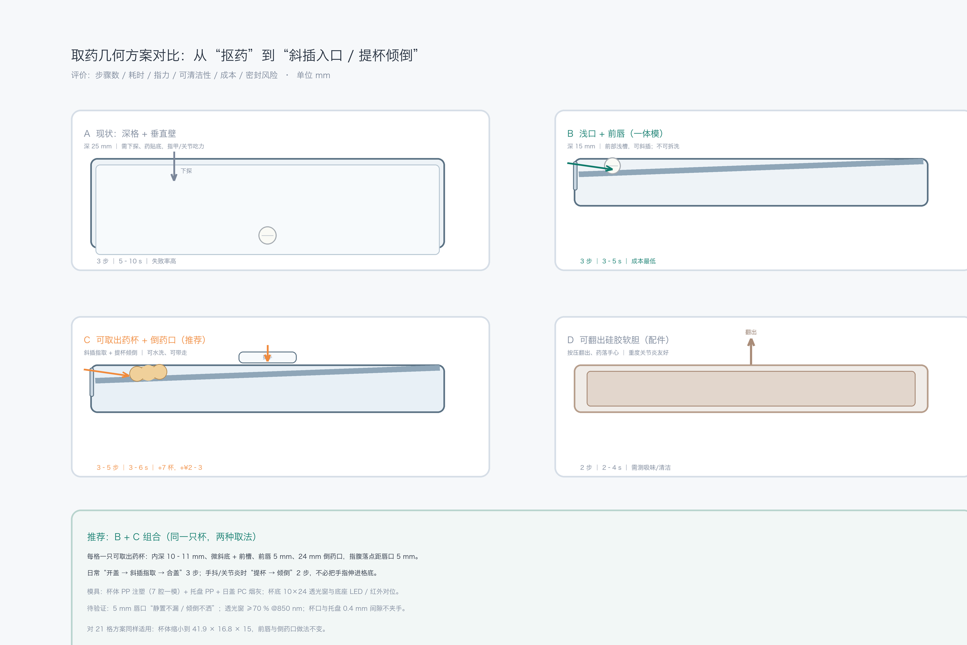
00_设计图板/06_retrieval_options.png
