anweat/idea-05b-smart-medicine-box/02_三维模型/display_ui.png

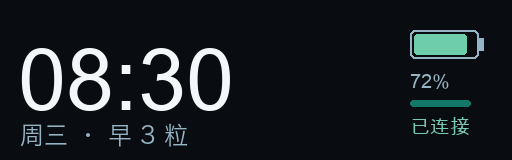
02_三维模型/display_ui.png
