anweat/idea-05b-smart-medicine-box/03_渲染图/cup_detail.png

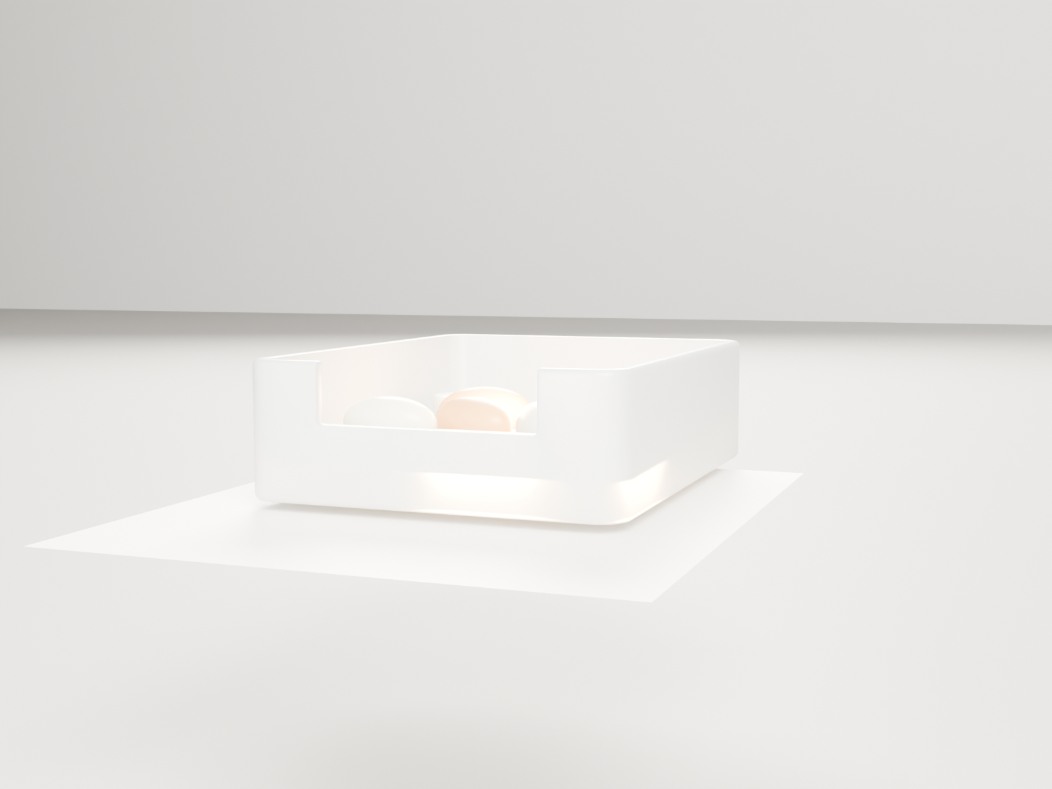
03_渲染图/cup_detail.png
