anweat/idea-05b-smart-medicine-box/03_渲染图/hero.png

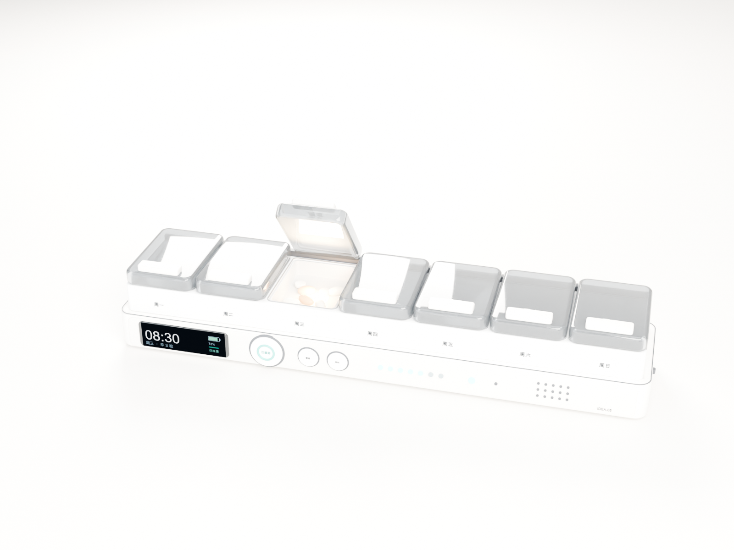
03_渲染图/hero.png
