anweat/idea-05b-smart-medicine-box/03_渲染图/transparent/front.png

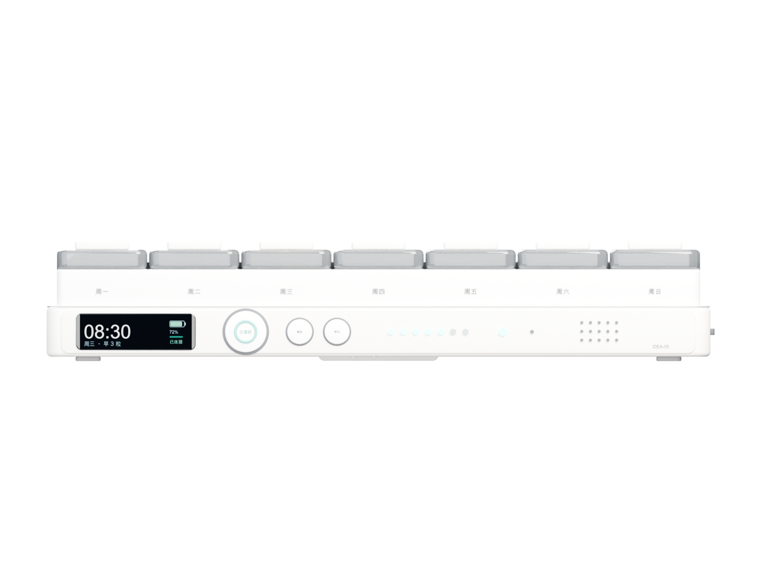
03_渲染图/transparent/front.png
