anweat/idea-05b-smart-medicine-box/03_渲染图/transparent/hero.png

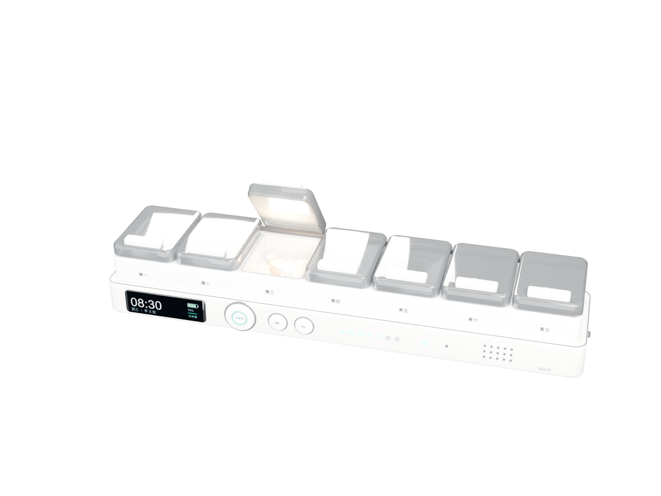
03_渲染图/transparent/hero.png
