anweat/idea-05b-smart-medicine-box/03_渲染图/transparent/top.png

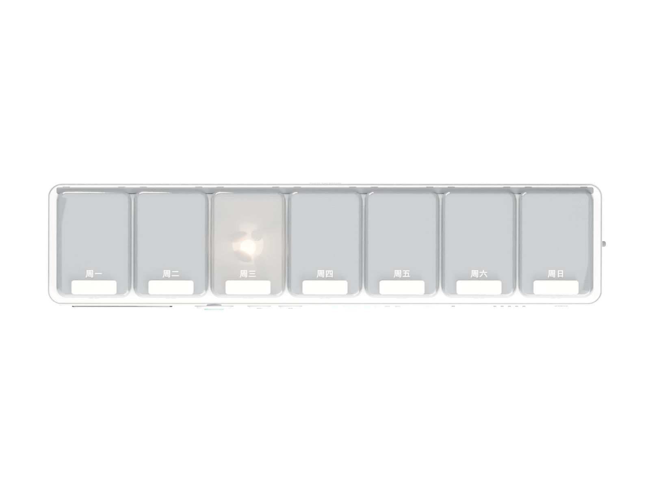
03_渲染图/transparent/top.png
