anweat/idea-05b-smart-medicine-box/05_参考资料/design_ref_raw.png

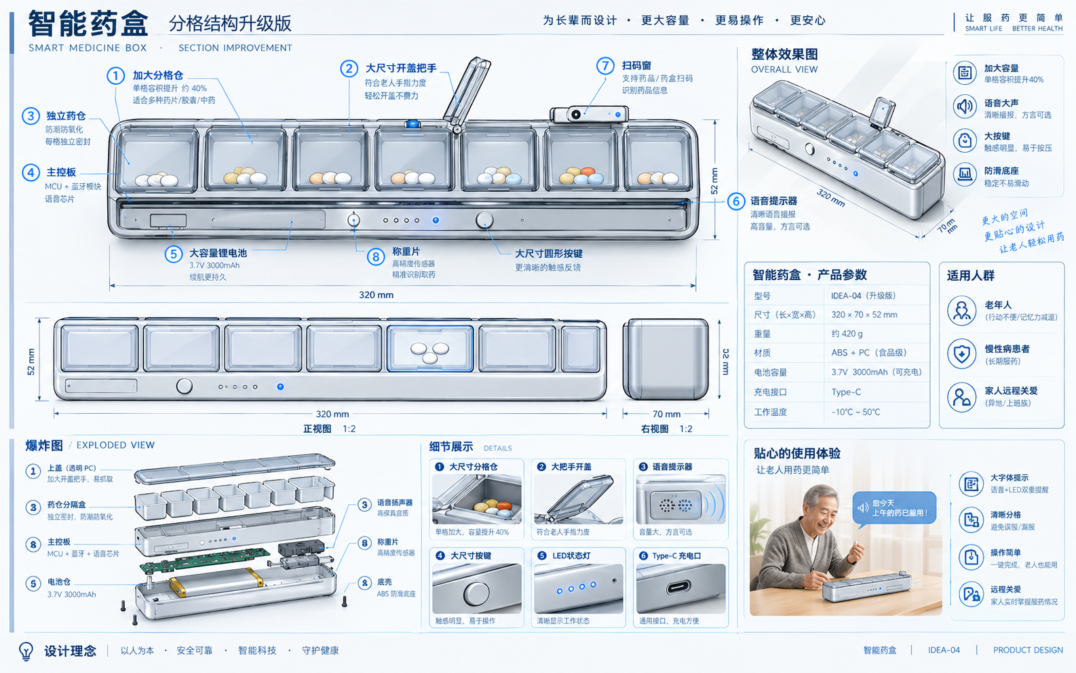
05_参考资料/design_ref_raw.png
