anweat/idea-05b-smart-medicine-box/05_参考资料/ref_front.png

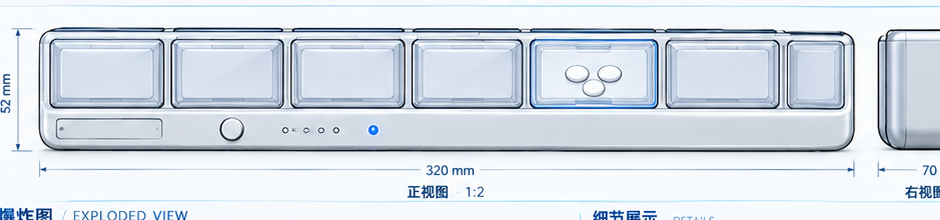
05_参考资料/ref_front.png
