anweat/idea-05b-smart-medicine-box/docs/assets/board.png

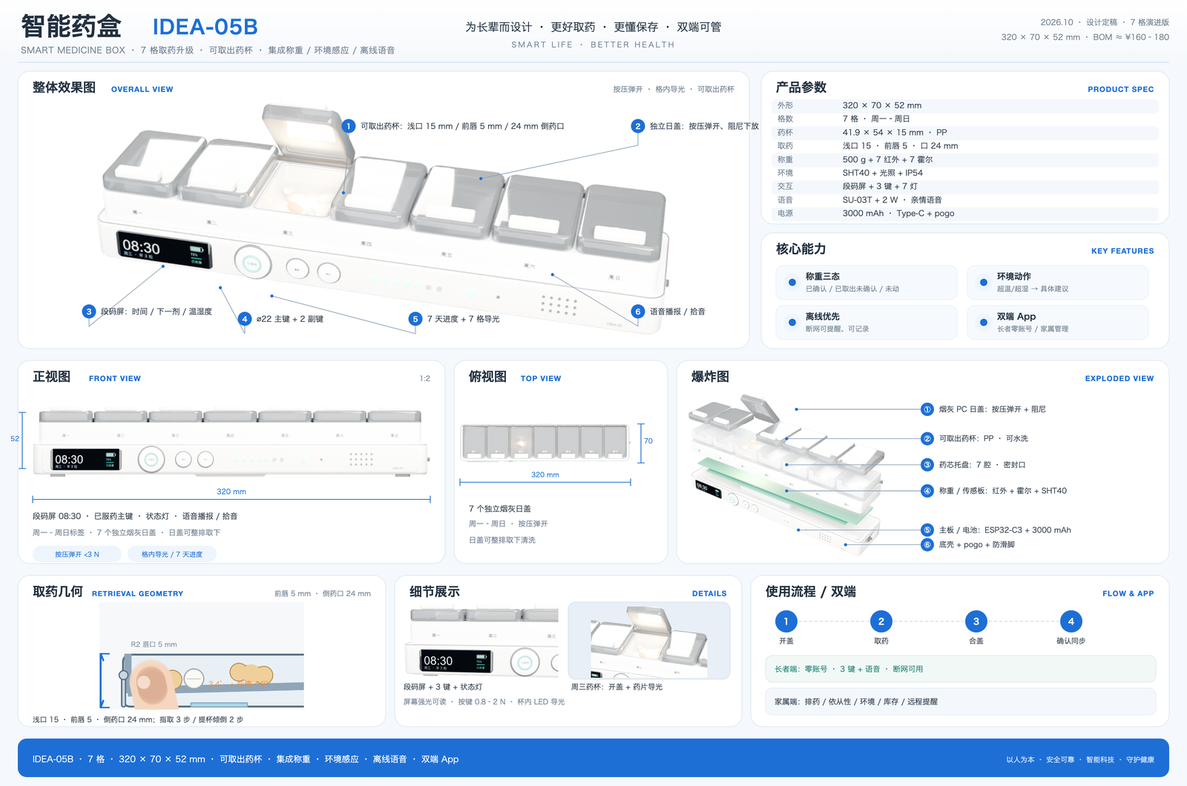
docs/assets/board.png
