anweat/idea-05b-smart-medicine-box/docs/assets/cup.png

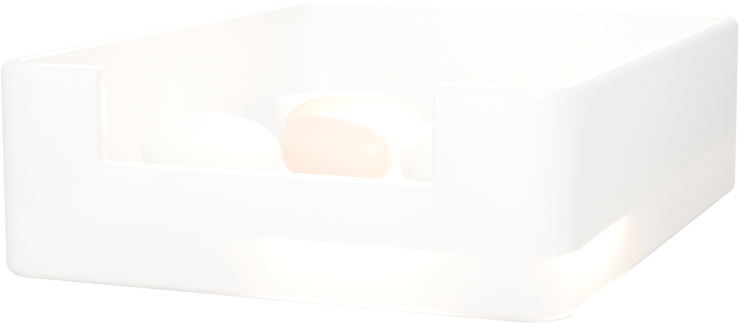
docs/assets/cup.png
