anweat/idea-05b-smart-medicine-box/docs/assets/exploded.png

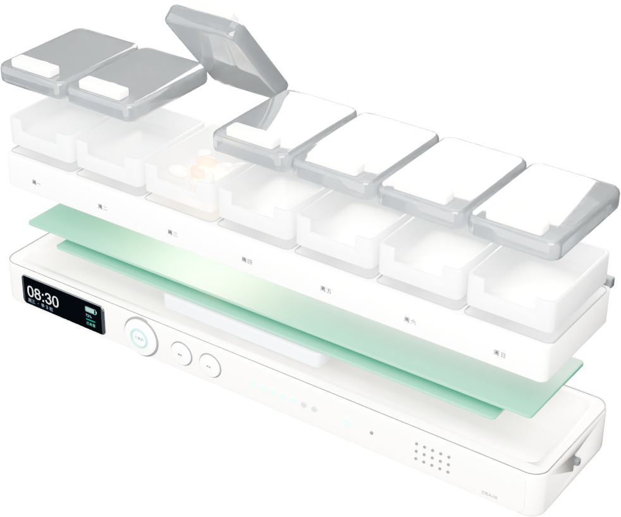
docs/assets/exploded.png
