anweat/idea-05b-smart-medicine-box/docs/assets/front.png

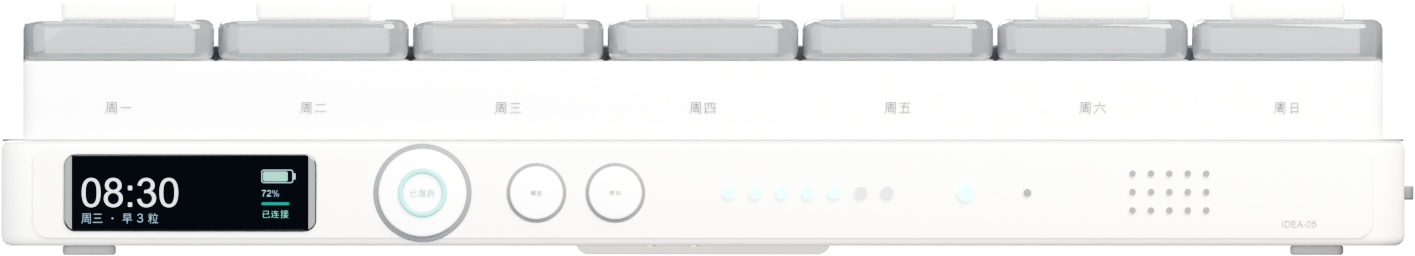
docs/assets/front.png
