anweat/idea-05b-smart-medicine-box/docs/assets/hero.png

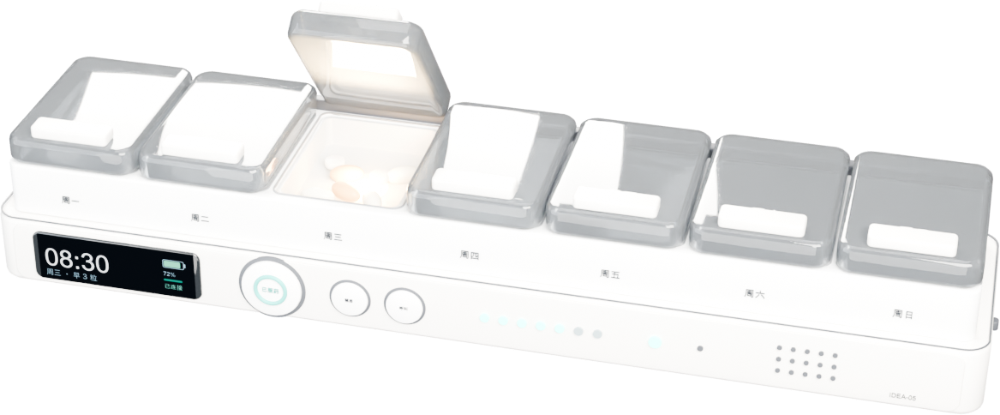
docs/assets/hero.png
