anweat/idea-05b-smart-medicine-box/docs/assets/og.png

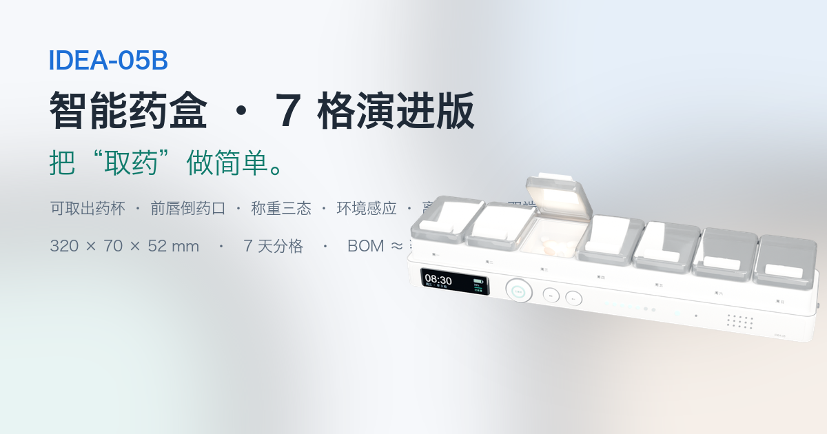
docs/assets/og.png
