anweat/idea-05b-smart-medicine-box/docs/assets/retrieval.png

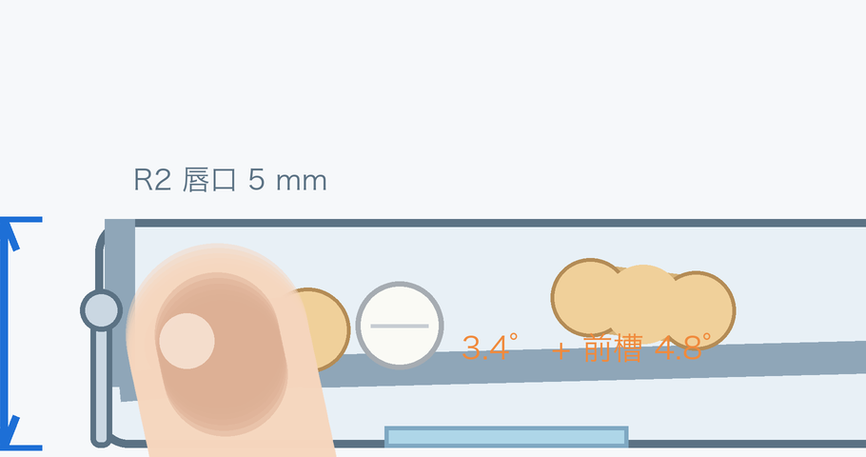
docs/assets/retrieval.png
