anweat/idea-05b-smart-medicine-box/docs/assets/top.png

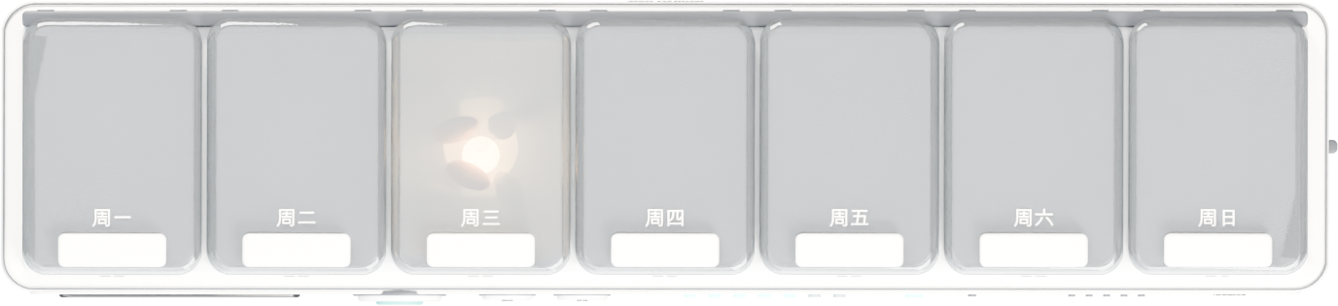
docs/assets/top.png
