anweat/idea-05b-smart-medicine-box/docs/assets/ui.png

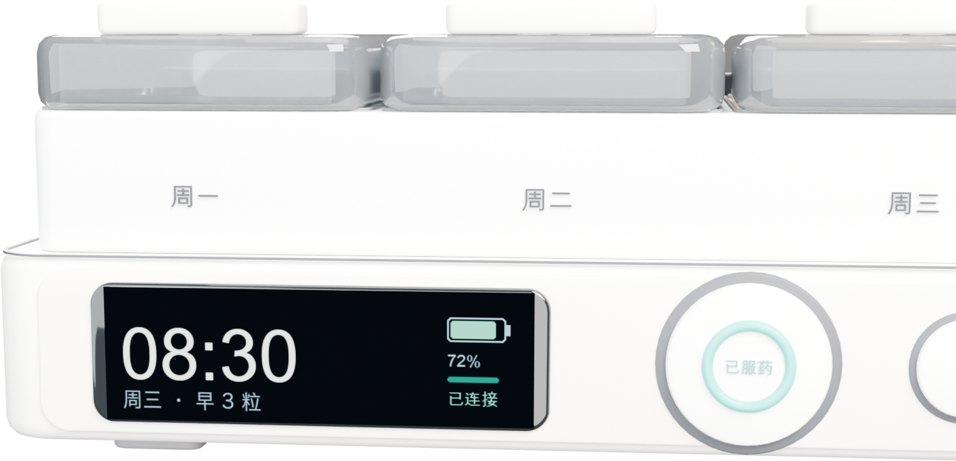
docs/assets/ui.png
