anweat/idea-05b-smart-medicine-box/docs/v3/assets/poster.jpg

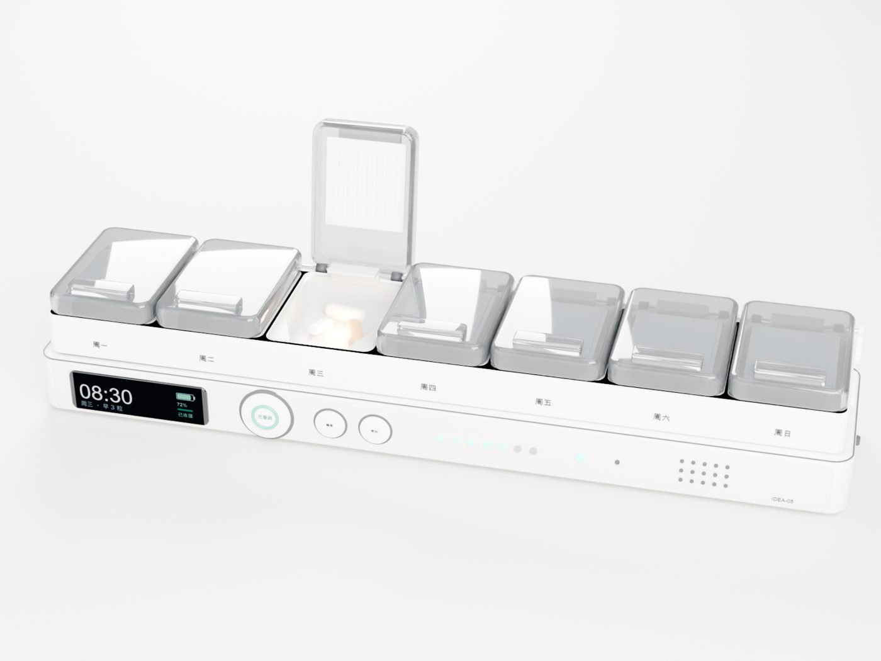
docs/v3/assets/poster.jpg
