anweat/idea-05b-smart-medicine-box/v3/01_设计文档/32_整机v3_剖面A-A.png

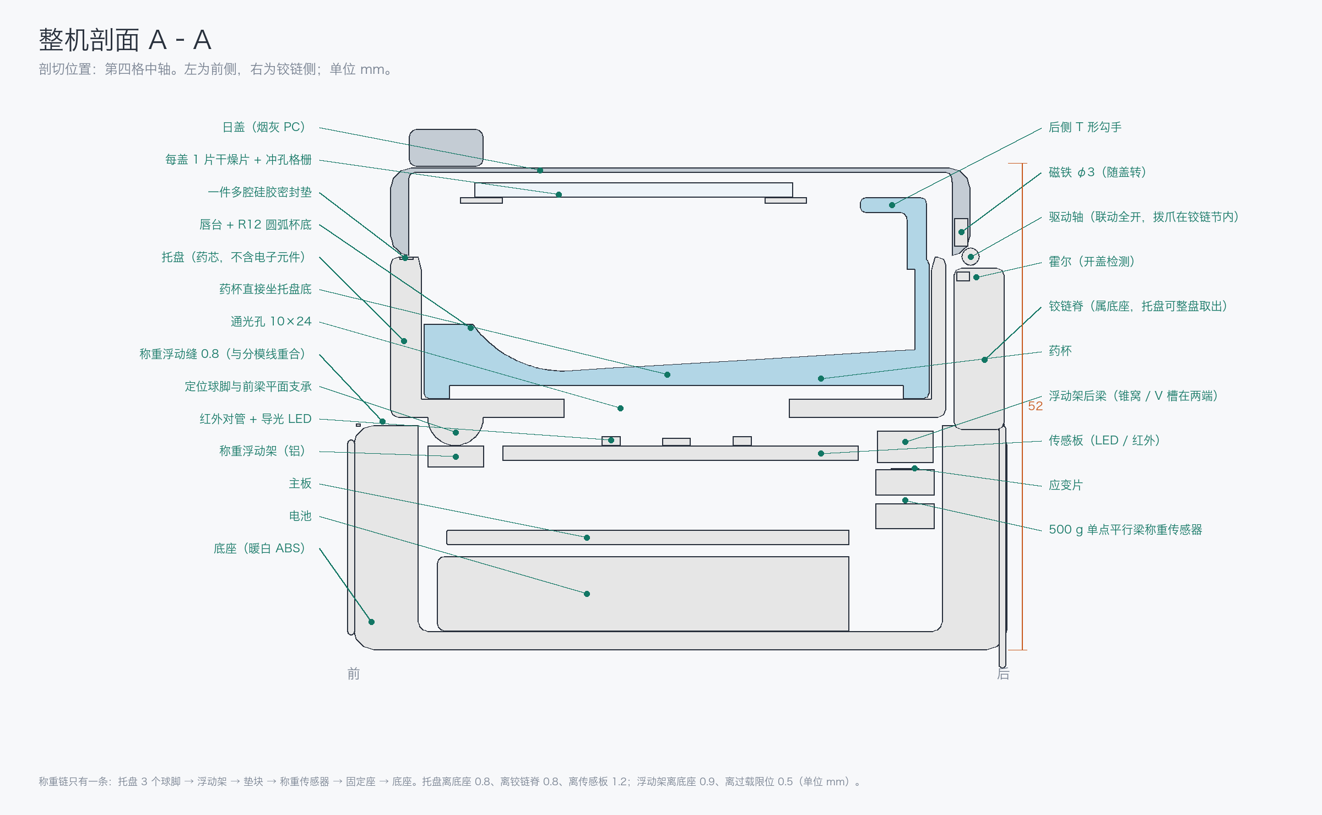
v3/01_设计文档/32_整机v3_剖面A-A.png
