anweat/idea-05b-smart-medicine-box/v3/04_渲染图/front_v3.png

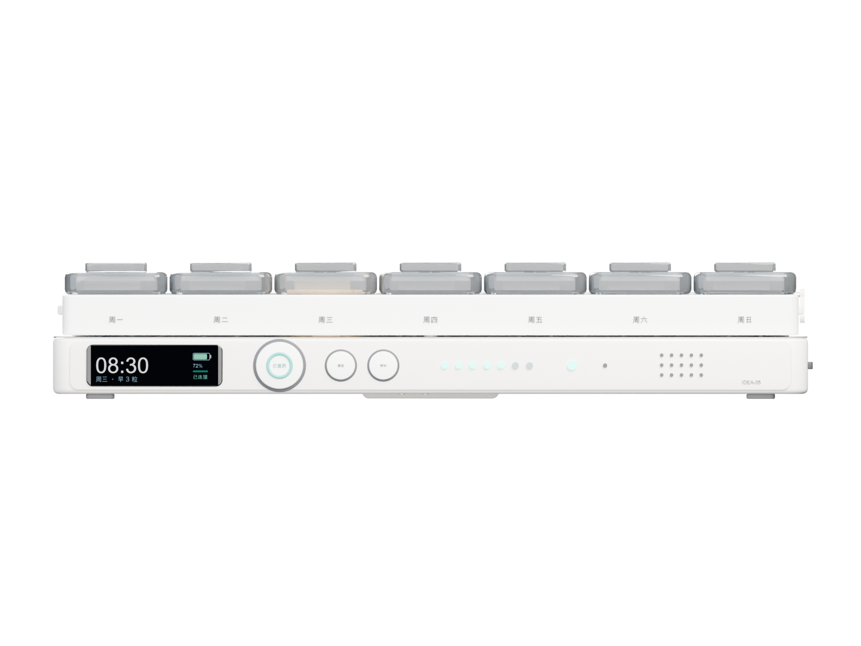
v3/04_渲染图/front_v3.png
