anweat/idea-05b-smart-medicine-box/v3/04_渲染图/v3_pour45.png

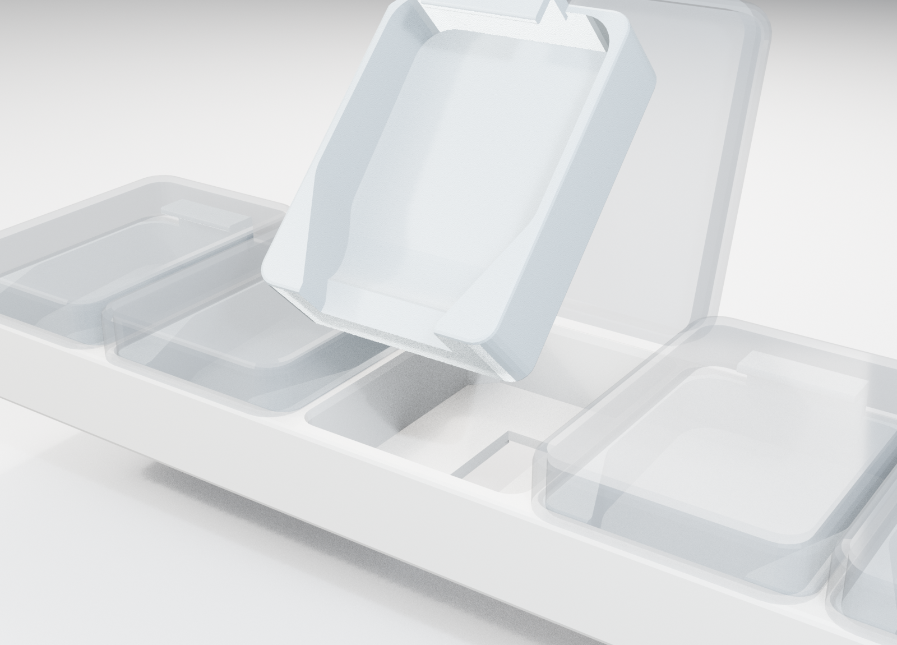
v3/04_渲染图/v3_pour45.png
