anweat/idea-05b-smart-medicine-box/v3/04_渲染图/v3_section_AA.png

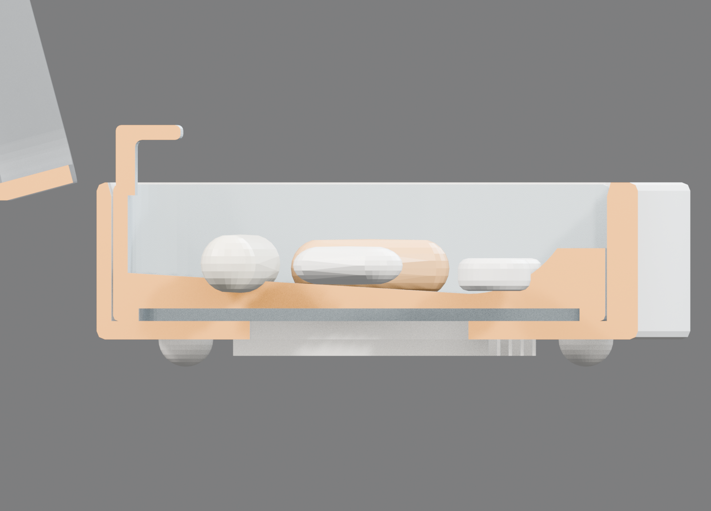
v3/04_渲染图/v3_section_AA.png
