anweat/idea-05b-smart-medicine-box/06_调研笔记/research_components.md

# 智能药盒 元器件选型与 BOM 成本调研（初版 v0.1）

> 调研日期：2026-10-18。价格均为**人民币含税前**口径，标注了渠道与抓取方式；`约`= 区间估算，`待核`= 未取得可核报价。
> **重要**：本文件价格来自公开网页（立创/华秋/Findchips/厂商页）抓取，**不是询价单**。批量价、账期、备货状态需向代理复核，波动 ±20% 属正常。

## 0. 结论速览

| 需求 | 首选方案 | 备选 | 一句话理由 |
|---|---|---|---|
| 整盒称重 | 1kg 单点式应变片 + HX711 | ADS1232（双通道/更稳） | 成本最低，0.5–1g 工程精度够做"缺药趋势" |
| 每格检测 | 每格 IR 对射（38kHz 调制）+ 霍尔判盖 | VL53L1X ToF | 每格 ¥1 级，不受药片颜色影响（对射优于反射） |
| 每格称重 | **不建议首版做** | ADS1234 四通道 ×2 + 7×500g | 成本 +¥180~220，温漂与串扰吃掉克级优势 |
| 温湿度 | SHT40 | AHT20（降本）/ SHT85（高精度） | ±1.8%RH/±0.2°C，0.4µA，1.5×1.5mm |
| 光照 | VEML7700 | BH1750 | 16bit、量程宽、I2C 简单 |
| 主控 | ESP32-C3-MINI-1 | ESP32-C6（Thread）/ nRF52832（纯 BLE） | 单芯片 BLE+WiFi，深睡 8µA |
| 语音 | SU-03T（离线唤醒+命令词）+ ESP32 播报 | CI1302/CI2305 | SU-03T 便宜、可自定义命令词 |
| 充电 | Type-C + TP4056；底座用 4pin pogo + 磁吸 | IP5306（带升压/电量） | TP4056 ¥0.3 级，静态功耗低 |

---

## 1. 称重：传感器 + 24bit ADC

### 1.1 单点式应变片传感器（铝合金，电阻应变式）

| 量程 | 典型外形（随厂家变化） | 灵敏度 | 非线性 | 零点温漂 | 蠕变(30min) | 参考价 |
|---|---|---|---|---|---|---|
| 1kg | 约 80×12.7×12.7mm，4×M4 安装孔 | 1.0±0.1 mV/V | 0.05%FS | 0.05%FS/10K | 0.05%FS | 约 ¥15–35 |
| 2kg | 同上或 90×12.7×12.7mm | 1.0±0.1 mV/V | 0.05%FS | 0.05%FS/10K | 0.05%FS | 约 ¥18–38 |
| 5kg | 约 90×12.7×12.7mm 起 | 1.0±0.1 mV/V | 0.05%FS | 0.05%FS/10K | 0.05%FS | 约 ¥20–45 |

- 结构尺寸与安装孔位**必须按选定型号图纸确认**，同类产品不同厂家不通用（[CZL601 单点式](https://www.madeinchina.com/mall/show-Single-Point-Load-Cell-CZL601_665448.html)、[EVT-18B 单点铝合金](https://cn.made-in-china.com/gongying/feiwosiqie-bqjJoVpyyehN.html)）。
- 价格未取得可核报价（1688/淘宝量级），**待核**；建议同时询 2 家要 1kg/2kg 图纸 + 温漂曲线。
- 关键认知：**温漂 0.05%FS/10K 在 1kg 量程上就是 0.5g/10K**，这是克级精度的天花板来源，不是 ADC 决定的。

### 1.2 24bit ADC 对比

| 型号 | 分辨率 | 通道 | PGA | 速率 | 电源 | 接口 | 单价(¥) |
|---|---|---|---|---|---|---|---|
| HX711 | 24bit ΣΔ | 2（A 差分 / B 固定 gain32） | A:128/64，B:32 | 10 / 80 SPS | 2.6–5.5V（内含稳压） | 2 线（PD_SCK/DOUT） | ¥1.61（立创 1 片）/ ¥1.74–3.01（华秋阶梯） |
| CS1237 | 24bit ΣΔ | 1 差分 | 1/2/64/128 | 10/40/640 SPS（待核） | 2.7–5.5V | 2 线（SCLK/DRDY） | ¥1.64–2.14（华秋） |
| ADS1232 | 24bit ΣΔ | 2 差分 + 片内温度 | 1/2/64/128 | 10 / 80 SPS | 2.7–5.5V | SPI | ¥9.24–15.81（华秋） |
| ADS1234 | 24bit ΣΔ | 4 差分 | 1/2/64/128 | 10 / 80 SPS | 2.7–5.5V | SPI | 约 ¥18–30（**待核**，按 ADS1232 通道数推算） |

- HX711 规格：24bit、片内低噪声 PGA、10/80SPS 可选、内置 LDO 供传感器、50/60Hz 同时抑制（[HX711 datasheet](https://cdn.sparkfun.com/datasheets/Sensors/ForceFlex/hx711_english.pdf)、[立创 HX711 页](https://item.szlcsc.com/7662293.html)）。
- HX711 输入噪声：gain128 下约 **50nVrms@10SPS / 90nVrms@80SPS**（同 datasheet 噪声表）。
- ADS1232 有效位：23.5bit(gain1)、**19.2bit 无噪声(gain64)**，RMS 噪声 17nV@10SPS/gain128（[TI ADS1232](https://www.ti.com/product/ADS1232)）。
- 价格来源：华秋商城阶梯价（1 片价→大货价），2026-10-18 抓取，如 [CS1237](https://www.hqchip.com/search/CS1237.html)、[ADS1232](https://www.hqchip.com/search/ADS1232.html)。

### 1.3 实际可达到的克级分辨率与漂移（算账）

1kg 传感器 + 5V 激励 + 1mV/V → 满量程输出 **5mV**；HX711 gain128 噪声 50nVrms → 理论噪声底 **约 0.01g**。
但工程上被三个因素吃掉：

| 误差源 | 1kg 量程折算 | 说明 |
|---|---|---|
| 零点温漂 0.05%FS/10K | **0.5 g / 10K** | 电池发热、手掌温度都会触发 |
| 蠕变 0.05%FS/30min | **0.5 g / 30min** | 长时间放置读数持续下沉 |
| 装配回差/偏载 | 0.2–1 g | 盘面刚度、螺丝扭矩、四角偏载 |
| **工程可重复精度** | **0.2–1 g（1kg）/ 0.4–2 g（2kg）/ 1–5 g（5kg）** | 需空载去皮 + 温度补偿 |

- **结论**：单片药 0.1–0.5g，靠廉价单点传感器**无法逐粒计数**；只能做"格内总量趋势 / 缺药提醒 / 一周用量估算"。
- 若必须克级：选 ADS1232 + 恒流/恒压激励 + 铝块热隔离 + 出厂两点校准，成本 ×5。

### 1.4 "整盘称重 + 每格 IR" vs "每格独立称重"

| 维度 | A：单点承托整盘 + 每格 IR 有无 | B：每格独立称重（7×） |
|---|---|---|
| 传感器/ADC 成本 | 1×传感器 ¥22 + HX711 ¥2 ≈ **¥24** | 7×传感器 ¥154 + ADS1234×2 ¥40 ≈ **¥194** |
| 结构 | 一块浮动托盘 + 3 点限位，简单 | 7 套独立浮动格 + 防串扰筋，模具与装配复杂 |
| 精度 | 整盘 0.5–1g，**知总量不知哪格** | 每格 0.2–1g，但格间机械串扰 + 温漂叠加 |
| 标定工时 | 1 次 | 7 次/台，产线节拍 ×7 |
| 失效模式 | 单点失效 | 任一路漂移即误报"少吃药" |
| 适用 | 首版量产 | 高端/临床依从性研究 |
| 建议 | **✅ 首版选 A（+霍尔判盖）** | ❌ 二代再评估 |

**推荐落地方案（A+）**：1kg 单点传感器承托整个 7 格盘 + 每格 IR 对射判有无 + 霍尔判盖；用"整盘差值 ÷ 当格药片平均片重"做**估算**片数，明确告知用户是估算值（避免医疗声称）。

---

## 2. 每格有无 / 余量检测

| 方案 | 原理 | 功耗 | 成本/格 | 主要误判风险 | 适配度 |
|---|---|---|---|---|---|
| IR 对射（ITR9608 类） | 发射管↔接收管跨格对射，遮断=有药 | 脉冲驱动，平均 <1mA（占空比 1–5%） | ¥0.9–1.9 | 半透明胶囊/粉末漏光；粉尘遮挡；需 38kHz 调制 + 同步解调抗环境光；开槽对准精度要求高 | ⭐⭐⭐⭐⭐ |
| IR 反射（TCRT5000 类） | 单侧发射+接收，反射强度判有无 | 同上 | ¥0.5–1.0（成品模块约 ¥9，勿按模块价算） | **黑色/深色药片反射弱→漏检**；格壁串扰；环境光 | ⭐⭐⭐ |
| VL53L1X ToF | 940nm 激光飞行时间测距，4m 量程，±5mm | 峰值约 20mW，平均可 <1mW（间歇） | ¥15–26 | 视场 27° 打到格壁→需遮光筒；透明盖板需校准；多格同时工作需分时 | ⭐⭐⭐（成本高） |
| 电容感应 | 电极电容变化判有无/接近 | µA 级 | ¥0.5–2（可用 MCU 触摸通道） | 湿度/结露漂移，需基线跟踪；只能判"有无"，不能判"余量" | ⭐⭐ |
| 霍尔 + 磁铁 | 盖/格盖开合 | 3µA 级 | ¥1.5–2.2 + 磁铁 ¥0.2 | 只判盖不判药；磁铁干扰扬声器/传感器 | ⭐⭐⭐⭐（必配，判盖） |

- 价格来源：[ITR9608](https://www.hqchip.com/search/ITR9608.html) ¥1.86(1 片)→¥0.88(大货)；[AH1815 霍尔](https://www.hqchip.com/search/AH1815.html) ¥2.15→¥2.06。
- **建议**：每格 IR 对射（38kHz 载波 + 软件同步解调，参考遥控接收头思路）+ 1 个霍尔判整盖 + 整盘称重兜底；三路冗余可把误报压到可接受。

---

## 3. 温湿度

| 型号 | 湿度精度 | 温度精度 | 电源 | 平均电流 | 封装 | 单价(¥) |
|---|---|---|---|---|---|---|
| **SHT40** | ±1.8%RH（max ±3.5%） | ±0.2°C | 1.08–3.6V | **0.4µA** | DFN 1.5×1.5×0.5mm | ¥3.58–5.54 |
| SHT31 | ±2%RH | ±0.3°C | 2.4–5.5V | 约 0.8µA（间歇） | DFN 2.5×2.5mm，8pin | ¥9.8–16（**疑为模块价，待核**） |
| SHT85 | ±1.5%RH | ±0.1°C | 2.15–5.5V | 约 1µA | 4pin 插针（可换） | 约 ¥60–90（**待核**） |
| AHT20 | ±2%RH | ±0.3°C | 2.2–5.5V | 约 20–60µA（测量时） | 3×3×1.0mm | ¥2.52–4.50 |

- SHT40 数据来自 [Sensirion 产品页](https://sensirion.com/products/catalog/SHT40/)（±1.8%RH、±0.2°C、0.4µA、DFN 1.5×1.5×0.5）；价格为 [华秋 SHT40](https://www.hqchip.com/search/SHT40.html)、[AHT20](https://www.hqchip.com/search/AHT20.html)。
- **放置建议**：① 装在格盘上方侧壁，距电池/充电 IC/DC-DC **≥15mm**；② 外壳开透气孔 + ePTFE 防尘透气膜（防水又透气，配合 IP54）；③ 避免阳光直射和 LED 补光直射（LED 自身发热 1–3°C 偏差）；④ 与主板做热隔离槽/开窗，别贴在 PCB 大铜面上；⑤ 单点即可，无需多点。

---

## 4. 光照与避光

| 器件 | 量程/分辨率 | 接口 | 功耗 | 单价(¥) |
|---|---|---|---|---|
| **VEML7700** | 0–120klx，16bit，内置暗电流补偿 | I2C | 待机约 0.5µA | ¥3.87–6.76 |
| BH1750 | 1–65535lx，16bit | I2C | 约 0.1µA 待机 | ¥3.18–6.06 |

- 价格：[VEML7700](https://www.hqchip.com/search/VEML7700.html)、[BH1750](https://www.hqchip.com/search/BH1750.html)。

### 避光材料（有数据，但要当心）

- 口服/外用**塑料容器**遮光判据：290–450nm 任一波长透射率 **≤10%**（USP `<661.2>`/`<671>`，被国内药包材标准广泛引用）。
- 实测：琥珀色半透明塑料瓶在 290–450nm 的透射率为 **1%–37%**，**并不能稳定满足 10% 限值**；乳白不透明瓶才达标（[Thermo 分光透射应用笔记](http://assets.thermofisher.cn/TFS-Assets/MSD/Application-Notes/AN53158-spectral-transmission-testing-pharmaceutical-containers.pdf)）。
- **结论**：单层"琥珀色 PC 板"不等于遮光。建议 **不透明 PC/ABS 主体 + 取药小窗用厚壁琥珀 PC（≥2mm）+ UV 吸收剂母粒 + 内衬遮光膜**，并**用分光光度计实测 290–450nm 曲线**（供应商提供的"UV 阻隔率"多为 380nm 单点值，不可直接采信）。
- 注意：不同厂家"UV 阻隔 PC"数据差异大，本文未取得板材厂商的完整透射曲线，**标注不确定，需实测**。

---

## 5. 主控、联网、语音

### 5.1 MCU / 无线

| 型号 | 内核 | WiFi | BLE | 深睡电流 | 模组价(¥) | 适用 |
|---|---|---|---|---|---|---|
| **ESP32-C3-MINI-1** | 单核 RISC-V 160MHz，400KB SRAM | WiFi4 | BLE5 | **8.14µA**（实测，模组级） | ¥10–14（华秋 1 片 ¥18.2，**偏高**） | ✅ 首版首选 |
| ESP32-C6-WROOM-1 | RISC-V 高性能+低功耗双核 | WiFi6 | BLE5.3 | 约 7–10µA | ¥16–19（Findchips $2.67/1pc） | 需 Thread/Matter |
| ESP32-S3-WROOM-1 | 双核 LX7 240MHz + 向量指令 | WiFi4 | BLE5 | 约 10µA | ¥21–26 | 需屏/摄像头/本地语音前端 |
| nRF52832-QFAA | Cortex-M4F | ❌ | BLE5 | 约 1–2µA | ¥16–24 | 纯 BLE、纽扣电级待机 |

- ESP32-C3 功耗实测：Deep-sleep **8.14µA**，active 约 **23.88mA**（[Espressif 官方电流测量指南](https://docs.espressif.com/projects/esp-idf/en/latest/esp32c3/api-guides/current-consumption-measurement-modules.html)）。
- 价格：[ESP32-C3-MINI-1](https://www.hqchip.com/search/ESP32-C3-MINI-1.html)、[ESP32-S3-WROOM-1](https://www.hqchip.com/search/ESP32-S3-WROOM-1.html)、[Findchips C6](https://www.findchips.com/search/ESP32-C6-WROOM-1)、[nRF52832](https://www.hqchip.com/search/nRF52832-QFAA.html)。
- **"BLE+WiFi 组合"不必双芯片**：C3/C6/S3 都是单芯片双模，省 BOM 和省电（分时：配网用 BLE，日常用 WiFi 上报）。双芯片方案仅在需要"BLE 常开 + WiFi 大流量"时考虑。

### 5.2 4G Cat-1（选配）

- **Air780E**：封装 17.7×15.8×2.3mm，Cat.1 下行 10Mbps/上行 5Mbps，低功耗模式 **<0.5mA**（[合宙官方规格](https://docs.openluat.com/air780e/product/)）。
- 价格：裸模组约 **¥25–35**（**待核**，合宙批量价）；DFRobot Gravity 成品板 **¥128**（[商品页](https://mall.dfrobot.com.cn/goods-3929.html)，含天线/底板，不可作 BOM 价）。
- 提醒：4G 峰值电流 2A 级，需 1000µF 以上储能 + 独立 PA 供电；**不建议放进药盒本体**，做底座/选配模块。

### 5.3 离线语音（唤醒 + 命令词）

| 方案 | 唤醒词 | 命令词 | 电压/电流 | 价格 | 备注 |
|---|---|---|---|---|---|
| **SU-03T** | 默认 2 个（"你好小智"/"小智精灵"），可自定义 | 可自定义数十条（智能公元平台生成固件） | 4.5–5.5V，EVB 待机 **60mA** | 约 ¥6–10（**待核**） | 便宜、资料多；**常听功耗高** |
| CI1302 / CI2305（启英泰伦） | 可自定义 | 100+ 条，本地降噪/回声消除 | 3.3V 域 | 约 ¥8–15（**待核**） | 识别率更好，需官方工具链 |
| SYN6288（TTS 播报） | — | — | 3.3–5V | 模块约 ¥30–45（**待核**） | UART 文本转语音，中文自然度一般 |
| WT588F02B（语音 IC） | — | — | 2.4–5.5V | **¥2.75**（[华秋](https://www.hqchip.com/search/WT588F02B.html)） | 存 MP3/WAV，需外挂 Flash + 功放 |
| ESP32 + I2S 功放（MAX98357/NS4168） | 软件（ESP-SR 需 S3） | 软件 | — | 功放 ¥3 级 | 最灵活，亲情语音首选 |

- SU-03T 规格局限：供电 4.5–5.5V、**EVB 待机 60mA**（[SU-03T 开发板规格书](http://docs.aimachip.com/zh-cn/latest/_static/document/SU-03T/SU-03T%E5%BC%80%E5%8F%91%E6%9D%BF%E8%A7%84%E6%A0%BC%E4%B9%A6V1.0.pdf)）。
- **关键功耗结论**：语音常听 20–60mA，3000mAh 电池只能撑 **50–150h**，与"低功耗待机"冲突。对策：① 语音模组单独 LDO + 负载开关，**仅按键/开盖时上电 3–5s**；② 用 PIR/霍尔/触摸做一级唤醒，语音做二级唤醒；③ 待机只保留 RTC + 称重定时采样。

### 5.4 语音播报与"家属录音亲情语音"

- **实现路径（推荐）**：手机 App 录音（AAC/MP3，≤30s）→ 云端转码 → 设备 WiFi 下载到 **SPI Flash（16MB，约 ¥6）或 TF 卡** → ESP32 用 I2S 播放 → 功放 → 扬声器。7 格 × 4 时段 × 2 条 ≈ 56 条，16MB 足够。
- **离线版**：WT588F02B 支持"录音+回放"（需外挂 Flash 与麦克风），可做"按住说话"本地录制，但音质与容量受限。
- 器件：MEMS 麦克风（I2S 数字，如 SPH0645LM4H，约 ¥5–8，**待核**）；扬声器 **49×35mm 8Ω 2W，¥4.79**（[立创 GSPK4935PN-8R2W](https://item.szlcsc.com/550909.html)）。
- **音腔设计**：后腔 ≥1.5cm³（用泡棉+独立腔体，别和电池共用），前腔 0.3–0.5cm³，泄音孔 φ0.8–1.5mm，四周密封泡棉压紧；**3.7V 直推 8Ω 实际约 1.0–1.3W**，标称 2W 需 5V 升压。

---

## 6. 电源与结构件

| 物料 | 规格建议 | 价格(¥) | 备注 |
|---|---|---|---|
| 锂电池 | 3000mAh，**805060（8×50×60mm），约 60g**，带保护板 + JST-PH2.0 | 约 ¥15–25 | 尺寸/重量来源：[Kubii 3000mAh 805060](https://www.kubii.com/it/alimentatori-protezioni/4913-ec-805060-batterie-li-po-avec-protection-3272496324541.html) |
| Type-C 母座 | 16P 贴板/沉板，带固定脚 | ¥0.8–1.2（华秋 1 片 ¥3.96） | [TYPE-C-16P](https://www.hqchip.com/search/TYPE-C-16P.html) |
| Pogo pin 磁吸 | 4pin（V+/GND/D+/D-），镀金，行程 1.5–2mm | 单针 ¥0.3–1.0；4pin 座 ¥5–12 | 需磁极防反接 + ESD + 短路保护 |
| 充电管理 | **TP4056**（线性 1A）¥0.27–0.55；**IP5306**（充电+升压+电量）¥1.07 | 见左 | TP4056 无路径管理；IP5306 静态自耗偏高，**待核 datasheet** |
| 硅胶密封圈 | 食品级硅胶 O 型/异形，邵氏 50–60A | ¥0.3–1.5 | 与 IP54 强相关，压缩量 20–30% |
| 干燥剂盒 | 可复用变色硅胶盒 20×30mm | ¥1–3 | 建议可拆换，配湿度指示 |
| 铰链/弹开 | 阻尼铰链 ¥2–6；push-push 弹开 ¥1–3 | 见左 | 7 格独立小盖用弹开更省空间 |
| 食品级 ABS | 注塑粒料 | 约 ¥18–25/kg | 需 GB 4806 符合性声明 |
| PC（透明/琥珀） | 注塑粒料 / 板材 | 约 ¥22–32/kg；琥珀 PC 板 ¥60–120/m²（**待核**） | 遮光需实测透射曲线 |

- 价格来源：[TP4056](https://www.hqchip.com/search/TP4056.html) ¥0.547→¥0.266；[IP5306](https://www.hqchip.com/search/IP5306.html) ¥1.07。
- 电池合规：必须选**有 GB 31241 报告 + UN38.3** 的电芯，保护板要过充/过放/过流/短路四重保护。

---

## 7. 初版 BOM（1k 批量估算，不含外壳模具/包装/认证）

| # | 物料 | 型号建议 | 数量 | 单价(¥) | 小计(¥) | 口径 | 备注 |
|---|---|---|---|---|---|---|---|
| 1 | 主控模组 | ESP32-C3-MINI-1-N4 | 1 | 12.0 | 12.0 | 批量估 | 深睡 8µA |
| 2 | 称重传感器 | 1kg 单点铝合金 | 1 | 22.0 | 22.0 | **待核** | 含线材 |
| 3 | 称重 ADC | HX711（SOP-16） | 1 | 2.2 | 2.2 | 华秋大货 | 可选 CS1237 ¥1.8 |
| 4 | IR 对射 | ITR9608 | 7 | 1.0 | 7.0 | 华秋大货 | 每格 1 组 |
| 5 | 霍尔开关 | AH1815 | 1 | 1.8 | 1.8 | 华秋 | 判盖 |
| 6 | 温湿度 | SHT40 | 1 | 4.0 | 4.0 | 华秋 | ±1.8%RH |
| 7 | 光照 | VEML7700 | 1 | 4.3 | 4.3 | 华秋 | I2C |
| 8 | 离线语音 | SU-03T 模组 | 1 | 8.0 | 8.0 | **待核** | 含板载 MIC |
| 9 | 功放 | NS4168 / MAX98357 | 1 | 3.0 | 3.0 | 估 | I2S/模拟 |
| 10 | 扬声器 | 49×35mm 8Ω 2W | 1 | 4.79 | 4.8 | 立创 1 片 | 含音腔泡棉 |
| 11 | 充电管理 | TP4056 | 1 | 0.4 | 0.4 | 华秋 | + 负载开关 |
| 12 | 电池 | 3000mAh 805060 带保护 | 1 | 18.0 | 18.0 | 估 | 需 GB31241 报告 |
| 13 | Type-C | 16P 母座 | 1 | 1.0 | 1.0 | 华秋大货 | |
| 14 | Pogo 磁吸 | 4pin 座 + 4 针 | 1 | 6.0 | 6.0 | 估 | 底座方案 |
| 15 | 电源 | LDO + 负载开关 + 电感 | 1 | 1.5 | 1.5 | 估 | |
| 16 | 阻容/ESD/三极管 | — | 1 | 5.0 | 5.0 | 估 | 约 60 个器件 |
| 17 | PCB | 4 层 60×90mm | 1 | 8.0 | 8.0 | 估 | 含贴片 |
| 18 | 密封圈 | 食品级硅胶 | 1 | 1.2 | 1.2 | 估 | |
| 19 | 干燥剂盒 | 可复用 | 1 | 2.0 | 2.0 | 估 | |
| 20 | 铰链/弹开 | 7 组小盖 | 7 | 0.4 | 2.8 | 估 | |
| 21 | 磁铁 | φ4×2mm | 8 | 0.12 | 1.0 | 估 | 盖+底座定位 |
| 22 | 导光柱/扩散片 | — | 1 | 1.0 | 1.0 | 估 | 状态灯 |
| 23 | 辅料 | 螺丝/泡棉/双面胶/线材 | 1 | 3.0 | 3.0 | 估 | |
| | **合计（不含税运、不含外壳与组装）** | | | | **≈ ¥120** | | |

### 成本区间

| 场景 | 区间(¥) | 说明 |
|---|---|---|
| 1k 批量（本文 BOM） | **¥105–150** | 不含外壳模具、包装、认证、组装人工 |
| 100 台小批 | ¥160–220 | 器件按 1 片价、PCB 无摊销 |
| 单件打样 | ¥280–400 | |
| 每格独立称重版（1k） | **¥290–375** | +¥180~220（6 传感器 + ADS1234×2 + 结构/标定） |
| 4G 选配（底座） | +¥28–35 | Air780E 裸模组 + SIM + 天线 + 电源 |
| 外壳模具（一次性） | ¥3–8 万 | 7 格内衬 + 主体 + 盖，2–3 套模具（**未计入 BOM**） |

---

## 8. 合规与标准

| 标准 | 适用范围 | 关键要求 | 状态 |
|---|---|---|---|
| **GB 4806.1-2016 / GB 4806.7-2023** | 与药品/食品接触的塑料件、硅胶圈 | 总迁移量、高锰酸钾消耗量、重金属、感官；需供应商**符合性声明 + 第三方检测报告** | [GB 4806.7-2023 已发布，代替 2016 版](https://www.spc.org.cn/online/b8dc1a3121134cffc41a79c1d5a84f81.html) |
| **GB 31241-2022** | 便携式电子产品用锂离子电池和电池组 | 过充/过放/短路/挤压/热箱/低气压；电芯需 CB 或 UN38.3 | [现行版为 2022，代替 2014](https://www.spc.org.cn/basicsearch?standclass=CN&text=GB+31241) |
| **GB/T 9254.1-2021** | 信息技术设备/多媒体设备 EMC 发射 | Class B 辐射/传导发射；需 3m 暗室或认可实验室 | [标准信息页](https://std.samr.gov.cn/gb/search/gbDetailed?mode=p&id=xrpAjee8TCI%3D) |
| **GB/T 4208-2017** | 外壳防护等级（IP 代码） | 建议目标 **IP54**（防尘 5 级 + 防溅 4 级）；药盒不浸水，IP54 足够 | IP54 = 防尘（少量进尘不影响）+ 各方向溅水 |
| **GB 4943.1-2022** | 信息技术设备安全 | 若含外置适配器/底座供电需评估 | 需法规确认 |
| **SRRC / 3C** | 无线电发射 / 强制认证 | WiFi+BLE 需 SRRC 型号核准；带适配器需 3C | 需法规确认 |
| **医疗器械分类** | 声称"提醒、记录、依从性管理" | 通常按**消费电子**管理；若声称"按剂量分发/治疗/诊断/慢病干预"则可能被界定为 **II 类医疗器械**，需注册 | ⚠️ **需法规确认**（建议做 NMPA 分类界定申请） |
| **药品管理法** | 若涉及按处方分装药品 | 分装/调配属药品经营行为，消费电子不得替代药师分装 | ⚠️ **需法规确认** |
| 其他 | 语音内容、App 隐私（个人信息保护法）、儿童安全（小零件/磁铁） | 磁铁需做拉力测试，防误吞 | 需确认 |

**合规落地建议**：① 所有接触药品的塑料件指定"食品级/药用级"牌号并留检测报告；② 电池选有 GB 31241 报告的电芯厂；③ 宣传文案禁用"治疗/诊断/替代用药"字样；④ 预留 EMC 与 IP54 整改余量（密封圈压缩量、开孔位置）。

---

## 9. 待确认清单（下单前必须闭环）

1. **称重传感器实际报价与图纸**（1kg/2kg 尺寸、安装孔、温漂曲线）——目前为区间估算；**SHT31/SHT85、ADS1234、SU-03T、CI1302、SYN6288、Air780E 裸模组、琥珀 PC 板**的真实批量价（本文标注"待核"）。
2. **语音常听功耗**实测（SU-03T 60mA 为 EVB 待机值，模组真实值需实测），据此定"一级唤醒"策略。
3. **琥珀 PC 透射曲线**实测（290–450nm）是否满足 ≤10%；**IP54 结构验证**（7 格独立盖密封累计公差为最大风险点）。
4. **医疗器械分类界定**结论（决定宣传口径与注册路径，建议正式申请分类界定）。

### 参考链接汇总

- 称重/传感：[HX711 datasheet](https://cdn.sparkfun.com/datasheets/Sensors/ForceFlex/hx711_english.pdf)｜[立创 HX711](https://item.szlcsc.com/7662293.html)｜[华秋 CS1237](https://www.hqchip.com/search/CS1237.html)｜[TI ADS1232](https://www.ti.com/product/ADS1232)｜[Sensirion SHT40](https://sensirion.com/products/catalog/SHT40/)｜[华秋 VEML7700](https://www.hqchip.com/search/VEML7700.html)｜[华秋 ITR9608](https://www.hqchip.com/search/ITR9608.html)｜[华秋 AH1815](https://www.hqchip.com/search/AH1815.html)
- 主控/语音/电源：[ESP32-C3 功耗实测](https://docs.espressif.com/projects/esp-idf/en/latest/esp32c3/api-guides/current-consumption-measurement-modules.html)｜[Findchips ESP32-C6](https://www.findchips.com/search/ESP32-C6-WROOM-1)｜[合宙 Air780E](https://docs.openluat.com/air780e/product/)｜[SU-03T 规格书](http://docs.aimachip.com/zh-cn/latest/_static/document/SU-03T/SU-03T%E5%BC%80%E5%8F%91%E6%9D%BF%E8%A7%84%E6%A0%BC%E4%B9%A6V1.0.pdf)｜[WT588F02B](https://www.hqchip.com/search/WT588F02B.html)｜[扬声器](https://item.szlcsc.com/550909.html)｜[电池 805060](https://www.kubii.com/it/alimentatori-protezioni/4913-ec-805060-batterie-li-po-avec-protection-3272496324541.html)｜[TP4056](https://www.hqchip.com/search/TP4056.html)｜[IP5306](https://www.hqchip.com/search/IP5306.html)
- 遮光/合规：[Thermo 药包材透射测试](http://assets.thermofisher.cn/TFS-Assets/MSD/Application-Notes/AN53158-spectral-transmission-testing-pharmaceutical-containers.pdf)｜[GB 4806.7-2023](https://www.spc.org.cn/online/b8dc1a3121134cffc41a79c1d5a84f81.html)｜[GB 31241](https://www.spc.org.cn/basicsearch?standclass=CN&text=GB+31241)｜[GB/T 9254.1](https://std.samr.gov.cn/gb/search/gbDetailed?mode=p&id=xrpAjee8TCI%3D)
