anweat/idea-05b-smart-medicine-box/文件清单.txt

IDEA-05 智能药盒 · 7 格演进版 · 文件清单
============================================================
文件数：58    合计：35.97 MB

      6.3 KB  README.md
      2.7 KB  文件清单.txt
    199.1 KB  00_设计图板/01_top_layout.png
    309.7 KB  00_设计图板/02_front_view.png
    318.5 KB  00_设计图板/03_section.png
    135.1 KB  00_设计图板/04_compare.png
    446.6 KB  00_设计图板/05_retrieval_geometry.png
    355.7 KB  00_设计图板/06_retrieval_options.png
    817.9 KB  00_设计图板/09_IDEA-05B_design_board.png
   4239.9 KB  00_设计图板/10_IDEA-05B_concept_board.html
    631.7 KB  00_设计图板/10_IDEA-05B_concept_board.png
   4237.6 KB  00_设计图板/10_IDEA-05B_concept_board.svg
      8.2 KB  01_设计文档/07_取药几何优化.md
      7.9 KB  01_设计文档/08_IDEA-05B_7格定稿.md
     13.1 KB  01_设计文档/11_特色点与创新点_讲述稿.md
     25.5 KB  01_设计文档/IDEA-05_设计优化方案_v1.md
    866.7 KB  02_三维模型/IDEA-05_box.blend
   2233.7 KB  02_三维模型/IDEA-05_box.glb
   2233.6 KB  02_三维模型/IDEA-05_box_closed.glb
     11.7 KB  02_三维模型/display_ui.png
   1766.7 KB  03_渲染图/cup_detail.png
   1859.6 KB  03_渲染图/exploded.png
   1406.6 KB  03_渲染图/front.png
   1682.5 KB  03_渲染图/hero.png
   1442.3 KB  03_渲染图/top.png
    604.2 KB  03_渲染图/transparent/cup.png
    974.2 KB  03_渲染图/transparent/exploded.png
    719.9 KB  03_渲染图/transparent/front.png
    818.9 KB  03_渲染图/transparent/hero.png
    804.2 KB  03_渲染图/transparent/top.png
   1317.1 KB  03_渲染图/transparent/ui.png
     16.8 KB  04_脚本/build_model.py
      5.4 KB  04_脚本/draw_lib.py
      8.4 KB  04_脚本/draw_retrieval.py
     11.9 KB  04_脚本/draw_scheme.py
      0.7 KB  04_脚本/export_glb.py
      1.2 KB  04_脚本/geom.py
      4.7 KB  04_脚本/make_board.py
     15.5 KB  04_脚本/make_svg_board.py
      5.5 KB  04_脚本/render_final.py
      4.3 KB  04_脚本/render_transparent.py
      0.9 KB  04_脚本/运行说明.txt
   1881.9 KB  05_参考资料/design_ref_raw.png
    912.3 KB  05_参考资料/ref_bottom.png
    188.5 KB  05_参考资料/ref_detail.png
    278.9 KB  05_参考资料/ref_exploded.png
    177.6 KB  05_参考资料/ref_front.png
    190.1 KB  05_参考资料/ref_header.png
    253.7 KB  05_参考资料/ref_iso.png
    477.3 KB  05_参考资料/ref_iso2.png
    469.1 KB  05_参考资料/ref_row1.png
    297.3 KB  05_参考资料/ref_row2.png
    123.9 KB  05_参考资料/ref_row2_side.png
    133.8 KB  05_参考资料/ref_side.png
    811.2 KB  05_参考资料/ref_top.png
     19.8 KB  06_调研笔记/research_competitors.md
     23.3 KB  06_调研笔记/research_components.md
     22.8 KB  06_调研笔记/research_ergonomics.md
