anweat/idea-05b-smart-medicine-box/v3/03_打印件/v3_托盘.stl

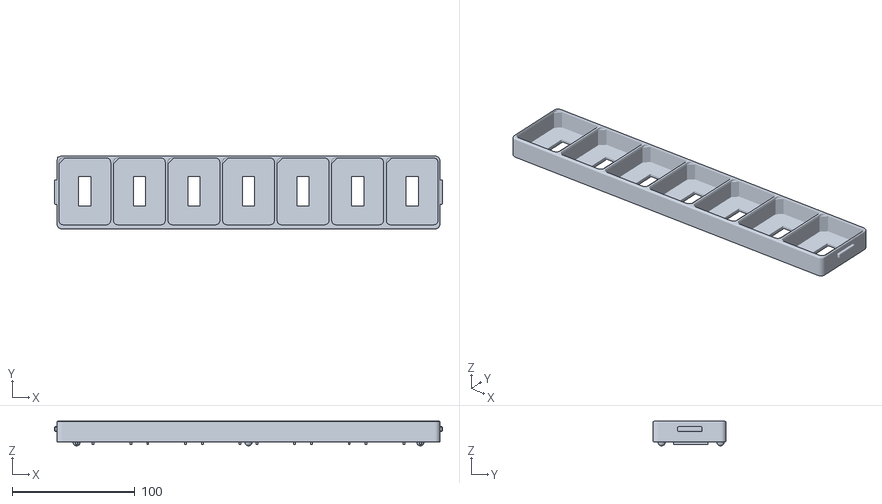
[picture p56: CAD file, 2026-10-26]
v3/03_打印件/v3_托盘.stl
316.0 x 59.4 x 20.2
