anweat/idea-05b-smart-medicine-box/v3/03_打印件/v3_装药漏斗模板.stl

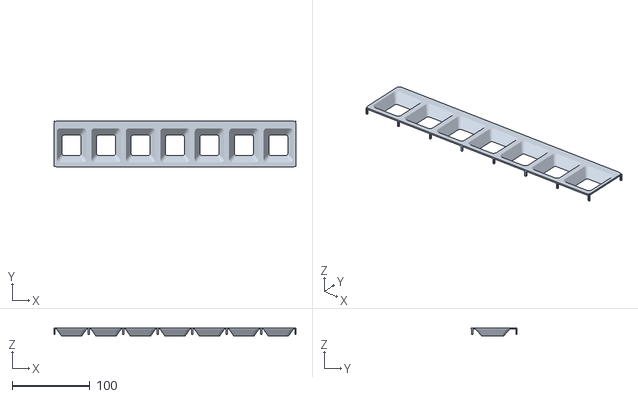
[picture p57: CAD file, 2026-10-26]
v3/03_打印件/v3_装药漏斗模板.stl
312.0 x 59.4 x 10.6
