anweat/idea-05b-smart-medicine-box/v3/03_打印件/v3_药杯.stl

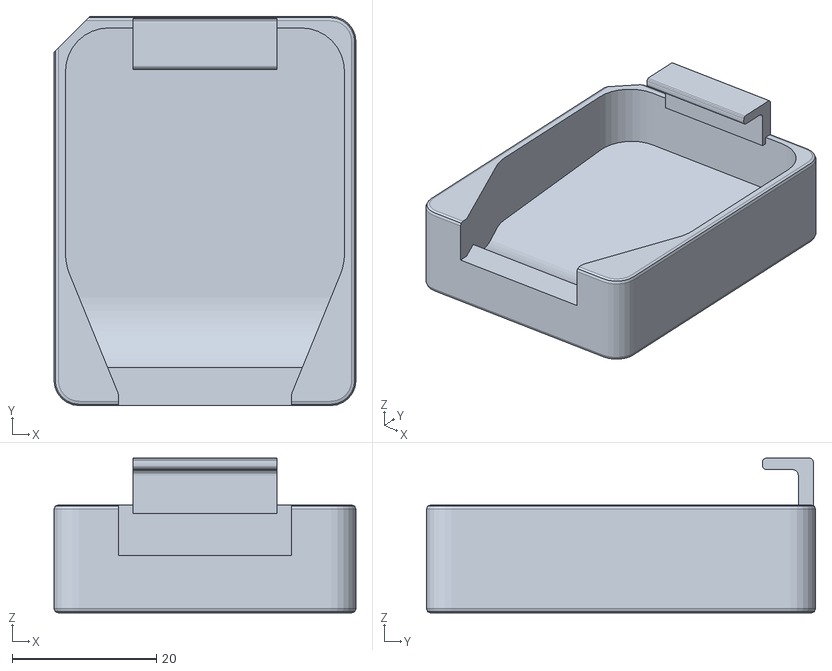
[picture p58: CAD file, 2026-10-26]
v3/03_打印件/v3_药杯.stl
41.9 x 54.0 x 21.5
