anweat/idea-05b-smart-medicine-box/(list of files, cad)

Other CAD files:
02_三维模型/IDEA-05_box.blend
v3/02_三维模型/IDEA-05_box_v3.blend
v3/02_三维模型/取药结构_v3.blend
