anweat/idea-05b-smart-medicine-box/(commit log)

2026-10-19 IDEA-05B 智能药盒：7 格演进版设计、Blender 模型与概念图板
    [IDEA-05_box.blend]
2026-10-19 docs: 仓库说明与 Release 链接
2026-10-19 feat: GitHub Pages 产品页，3D 模型展示与拆解
2026-10-19 docs: 国内部署评估（Gitee Pages 已停服，AtomGit/GitCode/EdgeOne 方案）
2026-10-19 docs: EdgeOne CLI 匿名部署与 API Token 说明
2026-10-19 feat: EdgeOne CLI 一键部署脚本
2026-10-26 feat: v3 取药 / 装药 / 称重结构升级 + 介绍页 + 3D 实时预览
    - v3/：创新点详述、取药结构方案、双人 5 分钟讲解稿、成本估算、整机与取药剖面图；
    整机 / 取药结构 Blender 模型与 GLB；药杯、托盘、装药漏斗模板 STL；渲染图；重建脚本；校验数据
    - docs/v3/：静态介绍页（想法与设计 / 结构与功能 / 成本）+ 3D 实时预览（闭盖 / 周三开盖 / 一拨全开）
    - docs/index.html、README.md：加 v3 入口，第一版内容不动
    [IDEA-05_box_v3.blend, v3_托盘.stl, v3_药杯.stl, v3_装药漏斗模板.stl, 取药结构_v3.blend]
2026-10-26 docs: 加许可声明 CC BY-NC 4.0（非商业），商业使用需联系作者
    - LICENSE：设计、文档、模型、图片、脚本采用 CC BY-NC 4.0；商用需事先取得作者授权（GitHub @anweat）；
    第三方 model-viewer 保持 BSD-3-Clause
    - README、v3/README、产品页 v3 入口条、v3 介绍页与 3D 页页脚同步写明许可与商用联系方式
2026-11-02 docs: 介绍页改为两大板块，措辞正式化
    - 板块一「需求与创新」：问题来源、目标人群、应用场景、核心创新、价值与成本，以叙述为主
    - 板块二「产品与结构」：外观、使用方式、结构组成、关键结构、设计验证，以图为主，每处一句说明
    - 去除代号、版本号等草稿式用语；三维模型页同步更名与改写标注
    - 剖面图标注正式化；正视 / 俯视图改为透明底渲染
    - 讲解稿按新板块重写，合计约 4 分 40 秒
2026-11-02 docs: 介绍页「价值与成本」下增加零件级成本明细
    - 电子元件 18 项、结构件 13 项、其他费用、一次性模具 10 项，千台批量估算
    - 明细直接读取 v3/01_设计文档/34_成本估算_v3.md 的表格生成，页面与文档保持一致
